Keyi-1/xinxian-fpga-guitar/tools/windows_score_uploader/examples/CSV格式说明.txt

CSV 是音符事件表，不是图片或音频文件。请使用 UTF-8 编码。

拍数格式（受软件 BPM 设置影响）：
onset_beats,duration_beats,midi_note,lane,velocity_hint,flags,group_id
0,1,60,,2,0,0
1,1/2,62,,2,0,0
3/2,1/3,64,,2,0,0

onset_beats：从曲首开始的拍数，休止直接体现在起音时间间隔中。
duration_beats：持续拍数；连音请合并为一条较长事件，避免重新起音。
midi_note：MIDI 50–79，即 D3–G5。
lane：0–3 对应界面第 1–4 根弦；所有行留空时按既有规则自动分弦。
velocity_hint：0–3，默认 2，用于试听；实际玩家拨弦力度仍由 FPGA 前端检测。
flags：目前固定 0。group_id：0–65535，通常填 0。

也可使用绝对 48 kHz 样本时间：
t_on_samples,duration_samples,midi_note,lane,velocity_hint,flags,group_id
0,48000,60,,2,0,0
48000,24000,62,,2,0,0
使用样本时间时，软件 BPM 设置不改变节奏。

必须按起音时间排序；同弦不能重叠，起音间隔至少 250 毫秒。
任意 108200 样本窗口每根弦最多 8 次起音；最长 10 分钟。
单首最多 1345 事件，五个槽共享导入空间。
无法分弦或密度超限时软件会报错，不会暗中删除音符。

《入门示例》是 8 秒音阶短句，用于首次串口导入测试。
《情歌》来自用户已确认的两页简谱主旋律：60 BPM、第二音色，
212 个起音、152 秒；第 10/18 小节采用已试听认可的修订节奏，CRC c3451bbc。
