Keyi-1/xinxian-fpga-guitar/verification/docs/RADIAL_SPECTRUM_DISPLAY_PLAN.md

# 右侧莉萨如、环形频谱与左侧四弦拨弦条带

2026-10-12，用户确认 J17 跳帽接触问题已解决，并授权开始下一版。
已按以下布局建立独立 [neo_guitar_radial 工程](../gowin/neo_guitar_radial/README.md)，
使用共享乘法 FFT、32 个实际频带插值为 64 根柱、原生 150×150 曲线及四条拨弦渐变。
**旧的 `neo_guitar_lissajous` 位流继续保留原居中布局。**
本文件保留设计依据；实际实现及验收状态以新工程 README、`verification.json` 为准。

2026-10-12 后续反馈：用户确认环形频谱与四条渐变新版已通过实物验收。
未来优化需求另见 [松品、力度、渐暗与触控游戏方案](NEXT_VERSION_PERFORMANCE_TOUCH_GAME_PLAN.md)，
暂不修改当前已验收的程序。

## 布局

屏幕保持 480×272。用户最新草图把画面分为左侧 208×272、右侧 272×272。
当前居中版本保持不变；这些布局只属于后续环形版本。

右侧区域 x=208..479，圆心 **(344,136)**，中央莉萨如正方形 **150×150**。
其对角线约 212.13，圆半径约 106.07，每侧约剩 29.93 像素。
频谱柱向外延伸，最大半径控制在约 134..135，预留边缘像素及光晕，避免越界。
圆内仍显示四根弦的真实音高 XY 图形，12 点低频、顺时针变高。

左侧 x=0..207，按 y 分成四条，各 **68 像素**：

| 弦 | 区域 y | 色彩 |
| --- | --- | --- |
| 第一根 | 0..67 | 蓝 |
| 第二根 | 68..135 | 绿 |
| 第三根 | 136..203 | 橙 |
| 第四根 | 204..271 | 红 |

每条带在实际接受拨弦时快速点亮渐变，再缓慢变暗；重新拨弦立即重新提亮，
四弦同时拨时四条可同时点亮，单独换品不能伪造拨弦闪光。
弦号/品位/Hz 可放在各自条带内；右侧不再使用当前底部四个信息卡。
三个按键仍保持原音色/音效功能。

## 频率与动态

从既有 `guitar_audio_top.final_pcm_valid/final_pcm` 取数据。
该信号来自 `four_string_board_audio_chain` 中最终音效后的左右 PCM24 平均值，
分析涵盖实际三音色模态、哇音半倍频、五度和声以及合唱/混响。
它是单声道混合频谱；左右声道相位抵消会影响幅度，不等于两声道能量之和。

12 点方位为低频，顺时针升高。建议 64 根柱，以接近对数的频率轴覆盖
约 47 Hz 到 24 kHz，48 kHz 采样的正频率范围。
仓库已有 1024 点 FFT，频率格距 46.875 Hz；最低几个柱需要依据实际 FFT 数据插值，
高频柱按频带聚合，而不是给窄频带强行分配不存在的 FFT 格点。

高度使用对数幅度和有限自动量程，让音色的高频分量也可见。
相邻柱可做有限的空间平滑，时间上采用快速上升、缓慢下降和独立峰值标记；
柱体沿半径渐变，顶部更亮。实际没有频谱能量的区域允许为空，静音时应回落。
显示上的插值和平滑不改动音频 PCM，也不能创造未演奏的频率。

## 保持声音完整的资源方案

当前音频单独使用 112/118 BSRAM；居中原分辨率显示使用 4 个，合计 116。
已有 FFT/频谱工程相对音频增加约 3 BSRAM 和 5 DSP，直接叠加会超过可用 RAM。
因此后续必须先改显示/分析的资源分配，不减少音源的 32 模态或音效。

建议把只有 256 项的反正弦表改为明确的 LUT 逻辑，释放 1 BSRAM；
FFT 保留两个复数工作 RAM 和原窗口，将窗口/蝶形乘法改成一个分时乘法器，
通过更多计算时钟换取 DSP 余量。在 50 MHz 显示域运行 FFT，
PCM 用保持数据的同步交接进入分析端，始终不向音频施加背压。
环形图继续使用原分辨率行缓存，不另建全屏帧缓存。

这是待验证的架构预算。后续实现需分别检查：

- 音频与当前完整版本逐周期、逐样本一致；所有原音色/音效保持。
- 单音、四音、半倍频、和声及接近 Nyquist 的 FFT 参考输出正确。
- 频率沿圆周顺时针映射，空间平滑不丢峰，静音时全部回落。
- 圆、中央正方形、外圈柱体和信息区在屏内且没有重叠。
- 全部行在刷新预算内完成，无缓存撕裂、PCM 丢样或音频 deadline miss。
- 实际综合网表 RAM/DSP 未超限，两时钟的 setup/hold 零违例。

环形版本应建立独立上板工程，保留当前已验收的居中版本及其位流。
