Keyi-1/xinxian-fpga-guitar/COPYRIGHT.md

# 版权与署名

**Copyright (c) 2026 芯弦项目贡献者（Xinxian project contributors）。**

该署名代表项目原创贡献者的集合，不表示所有版权已转让给某一维护者、GitHub 账号或新增的法律实体。各贡献者保留对自己原创贡献依法享有的权利；已有个人、单位或第三方权属约定继续有效。

Git 历史中的贡献者署名包括 Keyi（亦使用 Keyi Zhao）、Iris965、hanxiao-1。Git 历史用于记录协作与来源，不单独构成完整的权属证明。仓库维护者已于 2026-11-04 明确确认取得团队对 Apache-2.0／Windows GPLv3 授权方案及“芯弦项目贡献者”署名的同意。

团队原创代码和材料按 [LICENSING.md](LICENSING.md) 指定的范围授权。使用、修改和再分发时，按相应许可证保留版权、许可和必要的修改声明；没有另行附加必须署名为某一个人的条件。

第三方软件、IP、音乐、编配、谱面、图纸、字体及商标权利仍归其各自权利人，不因收录或参与打包而转让给本项目。没有明确授权依据的材料，不声明为团队原创，不由本项目重授权。

源代码许可不授予冒充原团队、宣称获得团队背书或超出许可证范围使用他人标识的权利。本文不声明“芯弦”已注册为商标，也不声明拥有未列明的专利。

发现署名、来源或授权信息有误时，请通过仓库 Issue 向维护者说明具体文件、来源和依据，以便核实和更正。
