Keyi-1/xinxian-fpga-guitar/releases/LICENSING.md

# 发布文件的许可补充

本目录的程序与源码按仓库根目录 [LICENSING.md](../LICENSING.md) 的组件范围授权。第三方曲谱、字库、图纸和 Gowin IP 保留原权利，不因打包成 FS、APK、MEM 或源码 ZIP 而由本项目重新授权；部分再分发权仍待核实。

`license_notices_20261104.zip` 提供根许可证、版权、NOTICE、第三方许可和源码索引，并列出它所对应的固定发布文件 SHA256。原始验收包和纯源码包不改写，可与该补充包一起取得许可说明。

Windows 优先下载 `FPGA_Guitar_Uploader_1.2.0_licensed.zip`。它保留原 `1.2.0.zip` 的所有成员及其字节，另附许可文件和带许可的对应源码 ZIP；软件版本和运行代码未变。`licensing_manifest.json` 列出原包哈希与新增成员，便于审阅。

这里的“许可补充”不表示已取得所有第三方素材的公开再分发许可。仓库保持现有可见性；公开分发含这些素材的包之前，仍需解决 [第三方清单](../THIRD_PARTY_NOTICES.md) 中标为待核实的项目。
