Keyi-1/xinxian-fpga-guitar/tools/windows_score_uploader/LICENSING.md

# Windows 客户端许可

Copyright (c) 2026 芯弦项目贡献者 / Xinxian project contributors。

本目录的原创应用代码、界面绘制和 `tools/run_windows_score_uploader.py` 采用 **GNU General Public License version 3 only，SPDX: GPL-3.0-only**。完整正文见同目录 `LICENSE`。

共享的 `tools/game_score_upload.py`、`game_score_v2.py` 和 `game_fingering.py` 保持 Apache-2.0；作为开源版 PyQt5 应用的一部分组合分发时，应用整体遵守 GPLv3，并保留这些共享模块的原许可和声明。

`examples/` 中的第三方曲谱、外部运行时和依赖不由本目录重新授权；参见仓库根目录 `LICENSING.md` 与 `THIRD_PARTY_NOTICES.md`。PyQt5 采用开源 GPLv3 版本，不因底层 Qt 使用 LGPL 而变成 LGPL。

原始便携包及其 `对应源代码.zip` 保持原字节。许可补充版增加应用许可、第三方源码索引和 `对应源代码-含许可.zip`，全部原程序与运行资源保持不变。原包的第三方声明仍可在 `THIRD_PARTY_NOTICES.txt` 查阅。

分发时应提供版本对应的完整源码、构建与依赖信息及适用许可。使用者可以按许可证修改程序、替换动态 Qt 库并重新构建，不另加相反限制。
