Keyi-1/xinxian-fpga-guitar/docs/images/full_width_game_stage.png

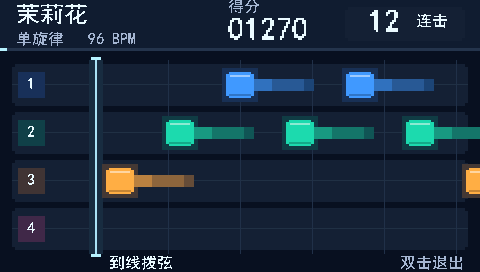
docs/images/full_width_game_stage.png
