Keyi-1/xinxian-fpga-guitar/tools/windows_score_uploader/assets/guitar.png

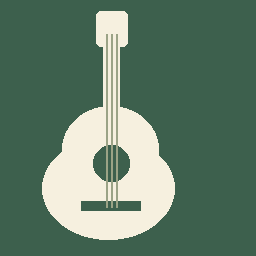
tools/windows_score_uploader/assets/guitar.png
