Keyi-1/xinxian-fpga-guitar/verification/docs/LCD_WHITE_WHEN_AUDIO_PLUGGED.md

# 插入 3.5 mm 耳机/音箱后 LCD 白屏：排查记录

**已解决（2026-10-12）：用户确认根因是 J17 跳线帽接触不牢，插牢后音频与 LCD 无冲突。
无需为此修改显示或音色 RTL。以下保留排查过程及当时待验证的假设。**

## 2026-10-12 实物反馈

- 工程：`gowin/neo_guitar_lissajous`，居中四弦莉萨如版本。
- 不接音频插头时，LCD 坐标背景、曲线与演奏联动正常。
- 接 USB 供电的有源音箱，3.5 mm 插头一插入即白屏，不需要拨弦；音频仍正常。
- 用户修正了先前的描述：上电后热插拔，拔出 3.5 mm 插头并不会恢复，屏幕继续白屏。
- 音箱 USB 接独立电源；更换不需要 USB 电源的无源耳机也会白屏。
- 底板通过圆形 DC 接口和 12 V 诱骗线供电；充电器标称支持 12 V / 2 A。
- 耳机预先接入后的冷启动结果、保持插头的重新下载结果和白屏时的电压/波形尚待实测。
- 最新补充：用户表示先前能显示颜色的程序现在似乎都不能变色。
  尚未确认是否已拔掉音频线、完全断电、重新加载原彩条程序，并复测电压/时钟。

## 已核对的事实

1. `constraints/neo_guitar_lissajous.cst` 的 52 个端口分配互不重复。
   DAC 使用 Y17、AB17、AA16；功放关闭脚为 AB16。
   LCD 数据/控制使用 G18..P20 的另一组已固定引脚，没有复用上述四脚。
2. 顶层 `pa_en_n=~audio_rst_n`，正常运行时一直为低；没有读入 3.5 mm 插头检测信号。
   LCD 扫描、背景及像素时钟不以耳机插入、PCM 音量或拨弦作为使能条件。
3. 用户提供的 31005 底板 PDF，第 10 页 `DAC+PA.kicad_sch`：
   J25 是 3.5 mm CTIA 插孔，`HP_DETL` 接到 NS4263 的 `HP-IN`；
   插入时检测开关断开，电阻把 HP-IN 拉高，切换到耳机模式。
   该检测网络没有连接 LCD 的 DCLK、DE、HSYNC、VSYNC 或 FPGA 软件输入。
   `PA_EN` 高电平关闭功放，低电平开启。
4. 同一 PDF 第 12 页 `LCD_DPI.kicad_sch`：
   J5 的 4 脚 VCC、31 脚 DISP 接 +3V3；背光来自 5V_Peripheral 的独立升压电路。
   亮背光不能证明 LCD 逻辑电源、时钟及 RGB 采样仍正常。
5. 2026-10-12 09:09 的本地实现报告仍为 setup/hold 零违例，
   音频 Fmax 13.512 MHz、显示 Fmax 51.360 MHz。
   源文件与上一轮验证记录中的源文件 SHA-256 一致。
   本次重新生成的位流 SHA-256 为
   `faa0aae61b0b07b54577dbd810e73b7c32c286ae740a7090248dcfd4baf95e6a`，
   与 10 月 11 日记录的文件不同，不能直接将旧位流哈希当成本次文件的验证证据。

以上没有证明硬件根因；目前没有证据支持改动音色、降低音频精度或更换 LCD 引脚。

## 第一轮对照：区分插入瞬间扰动与持续异常

若旧的独立彩条程序也不显示，应先恢复无音频连接的最小基准，再继续下面的热插/冷启动区分：

1. 拔掉 3.5 mm 音频插头，底板和屏幕断电；检查并重新插牢 J17 的 1–2 跳帽及 J5 排线锁扣。
2. 上电后重新下载原来实物成功的 `T:/Documents/AMD/fpga_lcd_selftest_60k/impl/pnr/lcd_selftest.fs`。
   它只包含 50 MHz LCD 彩条逻辑，没有吉他音源、MCP3208 或 PT8211 数据发送链。
3. 记录默认彩条、KEY1 切换及 KEY0 按住关闭背光的结果，并按下表重测屏幕端电压/波形。
4. 若需排除按键切换因素，可使用既有
   `T:/Documents/AMD/fpga_lcd_selftest_60k/diagnostic_auto_rgb/impl/pnr/lcd_auto_rgb.fs`，
   每 2 秒轮换黑、红、绿、蓝、白；这是测量工具，并非保证修复白屏的新位流。

未获得上述基准结果，不能确认屏幕已损坏，也不能把现象确定为整合程序的音频/LCD 引脚冲突。

无源耳机同样触发白屏，已经降低“原音箱 USB 电源/地环路”为首因的可能性。
热拔出不恢复提示可能是一次扰动后，LCD 内部状态或 FPGA 显示域没有恢复；
这是待测假设，不能仅凭此确定复位、供电或时钟中的哪一项有问题。

先插好普通有线耳机，使底板和屏幕完全断电约 5 秒，再重新上电。
确保相同 FPGA 程序已加载；若之前只做 SRAM 下载，断电会丢失配置，需在预插耳机后再次下载。
若冷启动正常、热插入才失效，应捕获插入瞬间的供电和时钟异常。
若预插耳机冷启动也白屏，应比较耳机模式下的持续供电、电平和 DCLK。

白屏后保持耳机插着，再下载同一个程序：

- 重新下载后恢复：优先检查 FPGA 显示域状态、复位恢复、50 MHz 时钟瞬态及供电；
  重新下载也改变 LCD 时序，不能仅凭该结果排除 LCD 内部状态问题。
- 下载不恢复，但整体断电可恢复：优先检查 LCD 逻辑电源与自身初始化；
  J5-31 DISP 硬接 +3V3，当前 FPGA 不能直接将它拉低重置面板。
- 以上均不恢复：继续检查持续电气异常和接触/连接。

## 已做与备用接线对照

依次记录以下组合的画面与声音，不同时修改多个条件：

| 条件 | 观察目的 |
| --- | --- |
| 原音箱、3.5 mm 保持接入，仅断开音箱 USB 电源 | 区分外部电源/地线联系与插孔本身；无源状态下的输入也可能产生负载，结果须结合下两项 |
| 普通不需要 USB 供电的有线耳机接入 J25 | 已测，同样白屏；问题并非原音箱专属 |
| 原音箱改为独立充电宝供电，再接 3.5 mm | 检查共用充电器、多口 PD 重新协商或电脑/底板 USB 接地产生的影响 |

当前应继续查底板功放切换、电源、插孔、50 MHz 时钟以及 LCD 接线。
标称 12 V / 2 A 不能替代插入前后的实际电压和纹波测量。

## 第二轮测量：在白屏状态测，不使用旧的正常状态读数

以屏幕端 J5 的 GND（3、29、36 脚）为参考，分别记录插入前后：

| 测点 | 本工程正常预期 |
| --- | --- |
| J5-4 VDD、J5-31 DISP | 约 3.3 V，插入时也应保持稳定 |
| J5-30 DCLK | 8.333333 MHz；示波器确认高低电平、连续性与边沿，不只看频率档 |
| J5-32 HSYNC | 约 15.694 kHz，低脉宽 0.48 us |
| J5-33 VSYNC | 约 53.745 Hz，低脉宽 254.88 us |
| J5-34 DE | 有效行高脉宽 57.6 us；每帧 272 条有效行 |
| 底板 DC 输入与 +3V3 | 插入前后是否变化；捕获插入瞬间跌落或振铃 |

若底板端信号正常，需在屏幕端再次测量，以识别 FPC、地线和连接接触问题。
声音正常只能证明音频链仍工作，不能证明独立的 50 MHz 显示时钟及 LCD 逻辑电源正常。

## 何时修改代码

- 显示信号及电源测量确认异常后，按异常位置处理，不先改频率比例、颜色或音色算法。
- 如对照结果指向板载 NS4263，可建立独立的“PA_EN 固定高”的临时诊断位流；
  它会关闭板载功放，不能作为同时发声与显示的正式修复。
- 如确认只有瞬间异常，修复应针对电源/信号完整性，或在有明确复位证据后增加恢复逻辑；
  延时启动或软件复位不能保证修复持续欠压，且不能直接复位硬接高的 DISP。
- 如需要观察 50 MHz 域，可另加诊断指示或定时背景；正式版继续保留原三键功能。

本次排查不启动下一版环形频谱设计，当前演奏显示 RTL 与音色核心暂未修改。
