Keyi-1/xinxian-fpga-guitar/verification/docs/VELOCITY_CALIBRATION.md

# P4 四弦力度校准

2026-10-19后续边界：第一弦易串触与最低响度先由[第一版修正](DYNAMICS_TUNING.md)接续；当前原impl和同名FS已为[四等分力度版](QUARTER_DYNAMICS.md)，CH0/CH2触发220/60，四档64/128/192/256，认证`quarter_dynamics_verification.json`。本文150/112参数及210877be...哈希为保存的初次力度校准快照，只对应`p4_velocity_calibration_20261019/`内部FS，不认证此后同名发布文件。

2026-10-18用户提供三份队友测试代码，授权基于已保存的P4接入力度并综合仿真，随后允许生成新位流时覆盖同名`neo_guitar_touch_game_p4_posture.fs`。没有新推送或代理烧录授权。

旧P4保存在本地标签`snapshot/p4-posture-before-velocity-20261018`（`1bbab98`）及原完整归档`build/releases/touch_game/p4_posture_20261018/`。旧位流SHA256为`34f8a86e942e291453159655c654fc72e5424167686cb2200dd659d4daf7229c`；归档中的`evidence/gowin/neo_guitar_touch_game/impl/pnr/neo_guitar_touch_game.fs`保持该版本。旧P4认证只认证这个固定快照，不能认证此后同名发布文件。

## 采用的校准值

三份输入原文和SHA256在`sim/reference/velocity_teammate/`，不改外部微信文件。注释不是额外指令；两个过期注释写100/30，与实际宏150等/20不符，生产采用实际宏值并纠正注释。

| ADC/轨道位 | 静态基准 | 触发偏差≥ | 回落偏差≤ | 进入力度1/2/3的峰值偏差≥ |
| --- | ---: | ---: | ---: | --- |
| CH0 / bit0 | 2053 | 150 | 20 | 280 / 430 / 620 |
| CH1 / bit1 | 2053 | 100 | 20 | 250 / 400 / 600 |
| CH2 / bit2 | 2053 | 80 | 20 | 150 / 280 / 400 |
| CH3 / bit3 | 2053 | 100 | 20 | 220 / 380 / 600 |

偏差为`abs(sample-2053)`，正负方向均触发；未到触发值不发音，到触发值但低于第一分界为力度0。达到边界归入较高等级，四档编码0～3。CH0～3仍对应MCP3208 CH0～3与`pluck_valid[0:3]`，没有改接线或交换弦。

`BOARD_FIXED_VELOCITY_ENABLE=0`启用动态四档，保留显式固定2的调试参数。按队友代码从首次越过触发值开始，取其后32个该通道样本与首个样本的最大绝对偏差，共33个观测值，末个样本也计入。窗口结束才同时提交力度和单周期拨弦脉冲，避免按刚越阈值的低幅度误分档。原事件时间戳仍记录提交时刻。

原SPI和ADC数据重建保持，包括已下板的奇数码重建方式，没有借此次校准改变ADC位对齐。400个通道样本死区和80个连续低于回落值样本保持，窗口按各通道自己的采样次数计数，不按四通道总数计数。新增`capture_pending`只用于观察窗口；姿态自动切音色把它计入待处理起音，防止约1.5ms捕获期间提前换音色。

## 响度与音色边界

上传的`voice_envelope.v`与现有文件逐字一致；它属于旧可选包络路径。当前三种音色使用实时`piano_voice_core`及其既有四档增益，不用另一套ADSR覆盖已验证的钢琴击弦和弦音/哇音包络。

| 力度编码 | 现有Q8增益 | 相对满力度振幅 |
| --- | ---: | ---: |
| 0 | 112 / 256 | 43.75% |
| 1 | 160 / 256 | 62.50% |
| 2 | 208 / 256 | 81.25% |
| 3 | 256 / 256 | 100% |

演奏与游戏真实拨弦使用捕获力度；试听继续固定2，曲谱metadata和推荐音色不改。此表是音源数字增益，不是声压dB或人耳响度比例。所有模态/谐波、音色系数、包络、音效、采样率、位宽、主增益、PA、两路音频与按键职责保持。四档最终响度仍须用实际琴体、扬声器和功放确认。

## 验证与当前构建

运行时源码`e5680ef`，原工程`gowin/neo_guitar_touch_game/neo_guitar_touch_game.gprj`、原`impl`、Device B。原工程综合及完整P&R/STA均PASS，记录在`build/velocity_calibration/synth_v1/`。综合LUT39698+ALU10501=Logic50199；下表统一采用完整实现报告，与保存的P4比较，不能将综合逻辑BSRAM108代替物理BSRAM113。

| 完整实现指标 | 保存的P4 | 力度校准版 | 变化 |
| --- | ---: | ---: | ---: |
| Logic / 59904 | 50580 | 50570 | -10 |
| Register / 60780 | 20090 | 20146 | +56 |
| CLS / 29952 | 28585（95.436%） | 28316（94.538%） | -269 |
| BSRAM / 118 | 113 | 113 | 0 |
| DSP / 118 | 115.5 | 115.5 | 0 |
| 系统报告Fmax / MHz | 50.020 | 50.089 | +0.069 |
| 音频报告Fmax / MHz | 13.858 | 13.638 | -0.220 |

运行仍为50/12.288MHz；未布通、setup、hold、latch及已测运算deadline违例全部0。保留两条既有PR1014通用时钟布线提示，STA计入实际布线。旧余量目标中CLS≤95%、音频≥13.5MHz已达到，系统≥55MHz仍未达到，不能宣称全部余量目标完成。资源变化来自本次完整实现，不把局部寄存器变化当作总体收益。

- `velocity_detector_01`：四通道全部4096输入码，共16384组，正负偏差/边界/132个峰值位置、末样本提交、固定2选项、交错窗口、振铃/重触发/复位；另有生产SPI4/捕获32/死区400/回落80的四弦×四档真实SPI模型。
- `velocity_audio_02`：实际ADC引脚→P2演奏路由→三音色×四档，每档1024样本；与独立指定正确等级的原音源逐PCM/PT8211/I²S比对，声部能量严格递增，12个单声部干声测试无数字硬顶。全部音效与四声部同时起音、捕获期姿态保护、手动优先、原生产顶层姿态场景也通过。01仅因测试最后四弦参考误设为混合等级而失败，已保留原日志；修正参考为四弦满力度，没有改生产音源。
- `velocity_legacy_01`：冻结`655458f32ba4f7e06403fd6c5c4da0b6f0dad8a7`的8192样本/2097153周期、全部音色/效果/1452样本退出；P2判定/四档力度、D3～G5完整32位参考/9032样本、实际硬件默认按键去抖均通过。
- `velocity_adc_gate_01`：当前实际完整VG中的ADC前端，原语/父级补码复位及全部8位力度/4位捕获输出已审计，真实SPI4和生产计数，四弦×四档，4739008时钟/32238转换逐周期与RTL相同，无内部结果强制。

- `velocity_full_gate_01`：当前实际完整VG整机对照PASS，10次真实115200事务，实际RAM写入/CRC/帧原子提交，第五行触控和四声部G5/D3/E4/C5；13397音频样本、16帧、5875200 LCD时钟采样，包含动态频谱与曲线渐暗。
- `velocity_posture_gate_01`：当前实际完整VG姿态整机PASS，真实MPU引脚、生产256包校准、物理音色键、AUTO待命/尾音/手动取消/退出/恢复；12815音频样本、1773读包、5次实际音色变化、11226240有效期系统时钟LCD采样。上述LCD采样数不是独立像素数；各bench的触控/计数加速/事件刺激边界在记录中明确，不把受控仿真称为实物验收。
- 曲库384组布尔连线审计PASS；33项PC测试与生成器按完整源码/输入/日志哈希复用，未变化的既有证据只用于明确同源范围，不复用旧VG日志认证新网表。

当前完整VG SHA256为`f64a6960a33513f73e2c60006b31a0fdf18970cce2fd0a23a128eb81e816e3c2`。综合PID39028、同一VG接续P&R PID24376及两个实际VG整机仿真均已结束，完整实现于2026-10-19 00:09:27完成。严格最终校验PASS，认证为`gowin/neo_guitar_touch_game/velocity_calibration_verification.json`，重新绑定源码、ROM、输入、工具、日志、当前VG、P&R/STA与位流哈希。不要重复启动已通过测试或完整构建。

## 发布与下板

原工程可直接使用`gowin/neo_guitar_touch_game/impl/pnr/neo_guitar_touch_game.fs`，无需重新综合布线。按用户明确许可，发布副本覆盖原同名`build/releases/touch_game/neo_guitar_touch_game_p4_posture.fs`，新SHA256为`210877be3e236c36d431e67bd116a6c9b0c2ac4e6d7b18912b162473b2b5812c`。本批完整证据归档为`build/releases/touch_game/p4_velocity_calibration_20261019/`，以`archive.json`核对每个文件；旧P4标签与固定原归档保持，旧认证只对应旧归档内部FS。两个受保护用户文件的内容及暂存对象不变。

1. 在Gowin Programmer中选择上述同名新FS，保持原接线与运行时钟。
2. 先在演奏模式逐弦试轻/中/重/最重，检查同弦强弱层次、连拨和静置不误触；再试三种音色、四弦同时拨及延音/混响。
3. 游戏中核对真实拨弦判定、试听固定力度2、触控选曲/退出和UART；已接MPU时再核对捕获/尾音期间不提前自动切音色、手动仍优先。

本批实物仍待：每弦轻/中/重/最重各20次，静置噪声/串弦/连拨/正负压电波形，跨弦与跨音色听感和硬削顶，游戏命中窗口，延音与姿态同时操作。没有原始ADC标注波形、目标声压或功放增益测量，因此不能把数字验证当作独立声学标定。供电/MPU接线/阈值和稳定性继续按P4说明验收，不自动展开蓝牙或新功能。
