Keyi-1/xinxian-fpga-guitar/verification/docs/evidence/voice_e4_golden_summary.txt

Xinxian FPGA Guitar - E4 golden vector
Configuration: {"lut_addr_bits": 10, "note_off_index": 24, "note_on_index": 0, "pcm_product_shift": 7, "phase_bits": 32, "phase_rom_sha256": "dc0c068f5d900bf015759b7a247e24b5ad950976b3725c4a76183bdb4eadd294", "sample_rate_hz": 48000, "sine_lut_sha256": "39d6e76e2dcf7f8337257c5948d6f525a94ffe09f5cf481e9e75a1300082b3c5", "vector_length": 48}
Phase increment: 01C20D2F
Vector samples: 48
Maximum PCM24: 6022393
Minimum PCM24: 0
Maximum PCM16: 23525
Minimum PCM16: 0

The CSV is the primary human-readable reference.
The MEM files are intended for ModelSim scoreboards.
