Keyi-1/xinxian-fpga-guitar/verification/docs/evidence/voice_e4_long_summary.txt

Xinxian FPGA Guitar - long E4 golden vector
Vector length: 48800
Sample rate: 48000 Hz
Nominal frequency: 329.6275569 Hz
note_on index: 0
note_off index: 36000
Phase increment: 01C20D2F
Sine LUT SHA-256: 39d6e76e2dcf7f8337257c5948d6f525a94ffe09f5cf481e9e75a1300082b3c5
Phase ROM SHA-256: dc0c068f5d900bf015759b7a247e24b5ad950976b3725c4a76183bdb4eadd294
PCM24 range: -8368130 .. 8385792
PCM16 range: -32688 .. 32757
