Keyi-1/xinxian-fpga-guitar/verification/gowin/neo_guitar_radial/README.md

# 四弦拨弦渐变、150×150 莉萨如和环形真实频谱

这是独立的下一版上板工程，Top=`neo_guitar_radial_top`，
器件 `GW5AT-LV60PG484AC1/I0`，Device B。
旧的 `neo_guitar_lissajous` 居中版本及其位流继续保留。

**实物验收（2026-10-12）：环形布局和松品续音均已由用户确认通过。**
本轮按用户授权只加入中央曲线渐暗，新位流待上板复测。
四档力度、条带长度与触控游戏仍为
[下一版方案](../../docs/NEXT_VERSION_PERFORMANCE_TOUCH_GAME_PLAN.md)中的待实施项目。

## 画面与演奏

480×272 屏幕左侧为 208×272，四条带各 68 像素：第一弦蓝、第二弦绿、第三弦橙、第四弦红。
只有实际接受的拨弦事件才使对应条带快速点亮，之后约 0.58 秒渐暗；
四弦可同时亮起，重拨重新提亮，单独换品不会伪造拨弦。
每条带显示弦号、品位和当前实际发声音高，保留原 20 ms 滑音。
按品和松品只选择音高：最后一个品位松开后，正在发声的弦滑向空弦并继续原衰减；
不会生成松品停音，也不会重置响度、力度、相位或包络年龄。只有真实拨弦重新起音。
声音结束由原音色自然包络及延音设置决定；静音后仅换品不会恢复声音。
这是共享 `guitar_play_control` 的新策略，重新构建引用它的其他工程也会采用相同行为；已有旧位流不变。

右侧为 272×272，中心在像素中心 **(343.5,135.5)**，即约 (344,136)。
莉萨如绘图区为 **150×150 原生像素**，中心和 X/Y 半径分别为上述中心及 74.5。
圆半径约 106，与 150×150 正方形的对角线相匹配；谱柱从半径 107 向外伸展，
柱体最高半径 134，峰值标记最高到 135。所有内容均在屏内。
圆内保留细线、抗锯齿、光晕和淡残影，四音曲线叠加混色。
Y 轴为 220 Hz 参考，X 轴来自四根弦真实主音高 DDS；它不是全部模态 PCM 的 XY 混合。

## 中央曲线渐暗

四声部各有一个 8 位显示亮度包络，复用原逐声部 PCM 峰值：

- 新的实际拨弦计数到达时，一帧提亮到 255；只换品或松品不会重新提亮。
- 持续发声时，亮度向 `level << 4` 跟随，升亮按差值的 1/2、降亮按差值的 1/32 推进，至少变化 1。
- 实际声部结束后保留最多 8 帧尾迹，约 **149 ms**，逐帧降至零；重拨立即重新点亮该弦。
- 四条曲线独立渐暗后再混色；一弦的结束或重拨不改变其他弦的包络。

已去掉原 `22 + 2*level + flash` 的固定底亮度。内部 8 位包络输出为面板的 6 位颜色强度，
低于可显示强度时停止绘图，内部包络最终归零；抗锯齿、光晕、残影和颜色流动继续保留。
包络与绘图使能均在帧消隐内提交，像素流水线级数及 LCD 时序不变。
尾迹按最后实际发声的 DDS 音高继续推进相位，静音后准备下一品不会使旧尾迹跳变。
只有环形顶层启用被动观察器的 `HOLD_INACTIVE_PITCH`；声音活动标志与音高/品位标签仍来自原演奏链。
该功能没有反馈到音频，三音色、4×32 分量、滑音、音效和松品续音均保持不变。
左侧四条带和真实频谱继续采用原衰减逻辑。本轮未改变拨弦力度判断或条带长度。

亮度实现见 `rtl/display/guitar_curve_envelope.v`，只使用移位、加减和寄存器，
不增加 RAM 或 DSP。现场可在此调整峰值跟随速度；尾部固定 8 帧的移位步长需同步修改计数及测试。

## 环形频谱

12 点附近为最低频率，顺时针升高。64 根可视柱来自 32 个实际频带的插值和邻域平滑，
快速上升、每帧缓降，另有慢速峰值标记和沿半径变亮的彩色渐变。
低频段不分配没有 FFT 格点的空频带；实际无能量的区域可以为空，静音会回落。

## 真实频谱与资源共享

分析输入为既有 `guitar_audio_top.final_pcm_valid/final_pcm`：
最终音效后的左右 PCM24 平均值，包含原三音色、五度和声、合唱及混响。
这是单声道混合频谱，两声道相位抵消会影响幅度，不等于两声道能量之和。

PCM 通过保持数据的请求/应答邮箱从 12.288 MHz 进入 50 MHz 域。
交接没有向音频施加背压；超限有独立诊断，仿真必须为零。
FFT 连续采集 1024 个 48 kHz 样本，加 Hann 窗；处理时短暂停止采集下一分析窗口，
不停止或丢弃实际音频输出。每个分析窗口约 22.2 ms。
FFT 保留既有分析定点算法，24→16 位只用于显示分析，音频 PCM 精度保持原样。
正频率覆盖 bin 1..512，约 **46.875 Hz..24 kHz**，排除 DC 并包含 Nyquist。
前 14 个频带各对应一个低频格点，后续频带逐渐加宽，避免低频空带。
幅度采用对数映射、有限增益与缓降参考，避免小噪声在静音时被放大成满圈。
32 个频带计算完成后整组发布；64 根柱及拨弦条带在帧消隐内更新。

一套 18×16 乘法器分时完成窗函数和四个复数乘积，不同时复制四个 FFT 乘法器。
本轮为满足 50 MHz，将乘法器输入提前一拍寄存，使状态译码/输入选择与 DSP 乘法分开。
蝶形仍采用原四次乘法调度，窗函数采样多一个 ROM 准备时钟；48 kHz 输入仍连续采集。
FFT 整数结果与原 FFT 逐频点比对，音频算术、ROM 和 PCM 路径不参与该优化。
FFT 用两个双端口工作 BSRAM 和一个窗 ROM，共 3 个 BSRAM。
曲线继续使用两条行缓存和一个正弦 ROM，共 3 个 BSRAM。
反正弦、旋转因子和小型径向表显式使用 `syn_romstyle="logic"`，避免自动占用 RAM。
原音频使用 112 个 BSRAM，总预算为 **118/118**，不能再直接叠加帧缓存。
新增共享只发生在显示/频谱模块，音源的 4×32 分量、ROM、定点精度和全部音效没有降低。

圆周方向用八分区阈值比较，距离用平方距离；显示不做逐像素除法或 atan2。
几何/字体为五级流水线，行缓存到 RGB 为四级，均在六个 50 MHz 时钟的像素周期内完成。
面板 RGB、同步与 DE 仍在 DCLK 下降沿输出，距上升沿约 60 ns。
绘图最坏 2266/3186 时钟（2176 行独立解析参考测试，含实际声部结束后的尾迹），无丢行。

本次渐暗版最终布局布线结果（Gowin V1.9.12.03，2026-10-12）：

| 项目 | 使用量／容量或结果 |
| --- | --- |
| Logic | 41721 / 59904 |
| Register | 16370 / 60780 |
| BSRAM | 118 / 118 |
| DSP | 115.5 / 118 |
| 音频 Fmax，目标 12.288 MHz | 17.483 MHz |
| 显示 Fmax，目标 50 MHz | 50.167 MHz |
| Setup / Hold 违例 | 0 / 0 |
| Latch | 0 |

显示域时序余量较小，RAM 已用满；更改 RTL 后必须重新综合、布线和验收，
不能直接增加帧缓存或提高显示时钟。

## 接线、按键与下载

沿用上一版所有接线：J5 LCD、J13 品位矩阵、J8 MCP3208、PT8211 和音箱。
**J17 必须可靠短接 1–2，确保跳帽接触牢固**；它关闭与 LCD 共线的 CH569。
不需要 HDMI。V22 仍为 50 MHz，V13 仍为板上已配置的 12.288 MHz。
三个用户按键保持原功能：

| 按键 | 功能 |
| --- | --- |
| KEY0 | 钢琴 → 明亮弦音 → 哇音 V4 |
| KEY1 短按 | 合唱开关 |
| KEY1 长按约 1 秒 | 五度和声开关，后续拨弦生效 |
| KEY2 | 无效果 → 延音 → 轻混响 |

在仓库根目录构建：

```powershell
gw_sh.exe gowin/neo_guitar_radial/build.tcl
```

Gowin IDE 可打开 `neo_guitar_radial.gprj`，确认 Top 为 `neo_guitar_radial_top`。
最终下载 `impl/pnr/neo_guitar_radial.fs`，首次使用 SRAM Program/Configure。
本次渐暗更新另存同内容下载文件 `impl/pnr/neo_guitar_radial_curve_fade.fs`，
方便在 Programmer 中区分旧版本；两份文件 SHA-256 相同。
CLI 构建脚本会同步更新该别名。IDE 另行构建仅更新默认 FS；使用带后缀文件前需把默认 FS 重新复制到别名，验收脚本会检测不同步的文件。
已验收的松品版本仍保留为 `impl/pnr/neo_guitar_radial_open_release.fs`，
另有构建前备份 `temp/before_curve_fade/neo_guitar_radial.fs`，指纹为
`701ba99e1c65f5667b934ef5b860df0bc968fca73d2ac45fc7b23b17e9ee85ce`。
更早的原环形程序备份为 `temp/before_open_release/neo_guitar_radial.fs`，
指纹 `71629a8d242f99c2bf7d8f1e2ea60fa0e24c903dfccb8665d16093bec77a047c`。
资源和两个时钟的 setup/hold 必须先由 `check_result.py` 验收，不能仅以生成了 FS 判断通过。
原屏背光恒流匹配和 GT911 触摸状态沿用上一版。

## 验证与实物验收

```powershell
./gowin/neo_guitar_radial/run_sim.ps1 -ModelSimBin '你的 ModelSim/win64' -PythonExe '你的 python.exe'
./gowin/neo_guitar_radial/run_gate_check.ps1 -ModelSimBin '你的 ModelSim/win64' -GowinHome '你的 Gowin/IDE'
python gowin/neo_guitar_radial/check_result.py
```

新 RTL 测试包括：PCM24 跨域交接、FFT 与旧 FFT 的逐频点整数比对、DC/Nyquist/静音、
频带原子发布、全圆独立 atan2/平方距离参考、四条带拨弦/衰减、
150×150 曲线独立解析模型和完整真实矩阵/ADC 演奏链。
完整演奏涵盖四音、最高品滑音、松品、三音色、合唱、和声、延音及混响，
连续 **7,214,423 个音频时钟**的 PCM、DDS、DAC、输入及控制输出与采用同一新演奏策略的 FULL 完全一致。
松品音高与旧行为的不同是本次预期变化，不宣称松品后的声音与旧程序相同。
新增 `tb_guitar_open_release` 在完整 4×32 音源中检查四弦包络年龄、自然结束、三音色和音效；
仅在测试实例缩短 MAX_SAMPLES以加快自然结束验证，生产音源参数、ROM与算术均不改动。
默认时序测试另外验证实际 12.288 MHz / 48 kHz 下的防抖、完整滑音和续音。
原核心与全部音色 ROM 的 SHA-256 另与仓库 HEAD 核对。
新增渐暗验证包括独立包络与实际 RGB 像素、四声部独立衰减、零亮度下限、
8 帧尾迹、事件计数回绕、尾迹中重拨、帧内亮度稳定以及最后可听 DDS/相位保持。
另将完整 4×32 音源的自然结束接入实际 CDC 和 LCD 扫描，导出 10 帧画面；
仅测试实例的 MAX_SAMPLES 缩短为 4096，生产时长、采样率、音源 ROM 和算术均不变。
门级测试用实际 Gowin 原语模型核对 LCD 引脚与 DAC 串行输出，并绑定当前网表哈希。
最终资源、Fmax、零违例和测试证据写入 `verification.json`。

本次渐暗版最终验收通过：30 项 RTL 测试证据，其中与修改相关的 10 项已重跑，
其余 20 项引用源码未变的既有结果；52 个固定引脚及电压核对通过，Setup/Hold 均为零。
当前综合网表的 7632 帧实际 DAC 输出与 RTL 逐位一致，包含 7292 帧非零和 1596 帧半速哇音；
7949456 个板时钟、1115060 个可见 LCD 像素完全一致。
音源、音色 ROM、音效及已验收松品控制的文件指纹与 `4d1af92` 基线保持一致。
渐暗位流及同内容下载别名的 SHA-256：
`870b8c1f2bd76d6dc6b0ddc2d5210fe75bdefa1017f62c4f9726649268598173`。
构建脚本自动更新下载别名；验收脚本核对别名与默认 FS 一致，防止误用旧文件。

本次为保持原 50 MHz 时钟，FFT 乘法器操作数改为提前寄存。
未增加乘法器或 RAM，2048 个正频点结果与原 FFT 逐位一致；当前 50.167 MHz Fmax 已通过。
不放宽时钟约束，不降低音源精度、分量数或音色复杂度。

历史松品更新最终验收已通过：27 项 RTL 回归证据、52 个固定引脚及电压核对、
Setup/Hold 零违例；综合网表的 **7632 帧实际 DAC 输出**（7292 帧非零，
1596 帧半速哇音）和 **1115060 个可见 LCD 像素**逐位一致。
门级另验证真实矩阵四弦松品后完成空弦滑音，声部保持活动且没有松品阻尼。
音源核心与全部音色 ROM 文件保持不变。上述自动构建/门级验收记录对应的位流 SHA-256：
`701ba99e1c65f5667b934ef5b860df0bc968fca73d2ac45fc7b23b17e9ee85ce`。
本地后续构建的位流指纹需单独核对；用户的实物功能反馈与这份历史自动构建记录分别保存。

实际 RTL 画面保存在 `sim/temp/radial_four_voices.png`、`radial_slide_c5.png`、`radial_release.png`。
渐暗帧保存在 `sim/temp/radial_fade_attack.png`、`radial_fade_tail_0.png` 到 `radial_fade_tail_7.png`，
其中声音结束后改为准备第 8 品，尾迹仍保留先前实际音高；最后一帧中央曲线归零。
本次渐暗更新待上板复测：逐弦及四弦拨弦应快速亮起，随声音慢慢变暗，结束时平滑淡出；
尾迹中重拨对应弦应立即提亮。换品/松品应继续改变曲线比例而不会闪回最亮；
分别用三音色和 KEY2 延音观察尾部，并核对声音与已验收版本一致。
松品续音已通过用户实物验收，作为回归继续检查：
按第 1 品后拨弦，再松品，应平滑转到空弦且继续衰减；先拨空弦再按品再松品也应一致。
仅换品不重新起音，自然结束后再按品保持静音。四弦和 KEY2 延音状态分别核对。
同时复测逐弦拨弦看蓝/绿/橙/红快速点亮与渐暗；
四音同时拨弦看四条带及复音曲线；切换三音色及音效，核对频谱分布随实际声音变化。
四档力度与 GT911 触控尚未做专项标定/验收，下一版方案不把它们列为当前已完成能力。
所有 `impl/`、`sim/temp/` 的位流、报告和图片都是本地生成产物。
