Keyi-1/xinxian-fpga-guitar/verification/firmware/jdy23/release/README.md

# JDY-23 蓝牙模块版本

本目录保存 2026-10-27 已完成的发布包；2026-10-30 提交到仓库。
本次只复核源码、已有验证记录和交付包的哈希，没有重新综合、布线、编译或烧录。

- [完整发布包](jdy23_20261027.zip)：FPGA 位流、Android JDY23 APK、接线/配置说明、配置脚本、原情歌示例，以及退出旧 BL616 诊断时可选的时钟恢复文件。
- [原始数字验证记录](verification.json)：包含源码、曲库、网表、位流、Android 输入和已有专项验证记录的绑定。
- [使用说明](../README.md)：3.3V 供电、共地、J8-9/10 接线、模块配置、手机握手及传谱步骤。
- [SHA256SUMS.txt](SHA256SUMS.txt)：本目录 ZIP 与原始验证记录的校验值；ZIP 内另有逐文件校验。

FPGA 改动限定为上传串口分频及两个引脚映射：9600/8N1，TX=AB21/J8-9，RX=AB22/J8-10。
Android 采用 FFE0/FFE1、20+12 字节分片和停等确认，保留断线后的提交状态核对。
音源、钢琴半时长、尾音锁定、滑音、颤音、触控、姿态与曲库运行时源码保持已有版本。

原工程已完成综合和完整 P&R/STA，系统/音频 Fmax 为 50.033/17.840 MHz，
实际时钟为 50/12.288 MHz，setup/hold/latch/未布通均为0；系统余量较窄。
专项验证覆盖实际 9600 UART、XG3/BSRAM/CRC/提交、当前网表接收、Android 类模型及配置脚本。
本版本尚未完成实体模块广播、手机连接及实物传谱验收，APK 未由代理安装。

固定交付哈希：

| 文件 | SHA256 |
| --- | --- |
| jdy23_20261027.zip | `145c412df784d6897f97cb1ed146bf87dd4b7c459e8ae271ac19d265fa8b9178` |
| neo_guitar_touch_game_jdy23_9600.fs（ZIP 内） | `78056f8c3bdde32bbbc12e1c7cc234e76beaa002562fb134fc6807a3c3452604` |
| xinxian_jdy23.apk（ZIP 内） | `b4fceac18a13d8ff3b9220cdf36b26bf27053cea292f59be751fb316ca166f5a` |

旧发布不覆盖；后续更新使用独立版本和验证记录。
