Keyi-1/xinxian-fpga-guitar/verification/docs/FULL_EFFECTS_V2.md

# FULL 音效 V2：空弦延音与可区分的合唱／混响

后续三音色更新见 [ROCK_TIMBRE.md](ROCK_TIMBRE.md)；本页记录 V2 两音色的音效基线。

日期：2026-10-05，分支 `feat/full-piano-effects`。
用户已上板确认三键功能正常，但反馈三种音效区别小，尤其明亮弦音的空弦延音不明显。
V2 使用相同的板级入口、接线、按键与音符表，重新实现效果参数和延音行为。

## 原因与修改

V1 延音只放慢松品之后的阻尼，空弦没有这个事件。
同一次空弦 C4 拨弦的实际 RTL PCM16 对照证明：两种音色的 V1 延音与无效果输出完全相同。
明亮弦音又叠加了很快的逐分量衰减，因而更快消失。合唱使用约 1 ms 的相同左右调制，
主要改变梳状滤波音色，缺少空间宽度；混响每条回声只有 1/32。

| 处理 | V2 实现 | 比较时关注 |
| --- | --- | --- |
| 延音 | 击弦起音前 2048 样本保持原速；之后自然包络每四个样本推进一次；松品后保持阻尼系数 | 空弦及按品音符本身的长尾音 |
| 明亮弦音 | 普通状态每四个样本更新分量衰减，延音状态每十六个样本更新 | 尾部不再被额外衰减迅速压掉 |
| 合唱 | 15～23 ms 的 Q8 分数延迟，0.55 Hz 三角调制；左右反向；3/4 干声加 1/4 延迟声 | 左右宽度、厚度与缓慢晃动 |
| 轻混响 | 31.0／41.5／56.5 ms 公共反馈延迟；3/8 归一化输入、5/8 反馈；3/4 干声加两条各 1/8 回声 | 起音后的空间反射，反馈尾音约 0.6 秒 |

延音只改变包络和分量幅度衰减，DDS 相位仍按正常 48 kHz 采样推进。
退出延音时已松品的音符恢复普通阻尼。自然包络仍会结束，没有无限维持平台。
房间网络的输入系数与反馈系数之和为一，反馈小于一；干湿系数之和为一。
分数延迟使用两条独立的注册凸组合乘法，避免以前 Gowin 有符号预加器的问题。
延迟 RAM 有填充保护，按键切换保留约 5.33 ms 的干湿渐变。

默认无效果的钢琴 **192000 个 PCM16 立体声帧与 V1 逐样本相同**。
原固定八模态钢琴入口的 32000 个样本也与独立参考相同。

## 工程与位流

仍打开 `gowin/neo_guitar_audio_full/neo_guitar_audio_full.gprj`，
Top=`neo_guitar_audio_full_top`，器件 `GW5AT-LV60PG484AC1/I0` / Version B。

- 当前下载文件：`gowin/neo_guitar_audio_full/impl/pnr/neo_guitar_audio_full.fs`。
- 本轮命名副本：`build/piano/neo_guitar_audio_full_effects_v2.fs`。
- 两者 SHA256：`e122443418dc86975a82881840529990691935f06b156974d47485b0c29fbd03`。
- V1 回退副本（本轮开始时的本地构建）：`build/piano/effects_v1_accepted/gowin/neo_guitar_audio_full/impl/pnr/neo_guitar_audio_full.fs`，
  SHA256 `9d130149bea45a294b754ac6118db42bb3d0144dca875a02f34de97f22320641`。
  同目录备份树包含修改前 RTL、系数、证据与 `manifest.json`。

按键沿用：1 键循环音色；2 键短按合唱、长按五度和声；3 键循环无效果／延音／轻混响。
工程没有外部复位键。LED0～3 分别表示明亮音色、合唱、延音、轻混响。
和声在下一次拨弦锁存；第三键无效果时，同时点亮 LED2／3 表示和声已启用。

## 数字验收

| 构建 | Logic | FF | BSRAM | DSP | 时序 |
| --- | --- | --- | --- | --- | --- |
| 可下载 FULL 音频 | 22420 / 59904 | 10294 / 60780 | 80 / 118 | 91 / 118 | 音频 Fmax 20.101 MHz，最小 setup +31.633 ns；setup/hold 零违例 |
| FULL 音频 + FFT/LCD 逻辑 | 29329 / 59904 | 12615 / 60780 | 83 / 118 | 96 / 118 | 音频 Fmax 18.471 MHz，像素 Fmax 136.144 MHz；setup/hold 零违例 |

后者使用自动引脚，只用于资源和时序检查，不能下载。LCD 实物验收仍待面板采购及接线冻结。
两个构建均无锁存器，时钟和容量要求保持不变。

- 完整回归 **76 项通过**，用户 RTL 编译及普通仿真无警告或错误。
- 四声部 **128 个非零分量**、2000 个真实采样帧，音源计算仍为 **231 / 256 时钟**。
- FULL 连续 **10000 帧**无丢样或 deadline miss，FFT 与显示各更新六次。
- 实际下载工程综合网表 **3263 个 DAC 帧逐比特相同**，覆盖两音色、合唱、独立延音／混响、五度及上电初始化。
  只加速双方机械按键计数器；没有强制音频数据、ROM、乘法器或 DAC。
  原语模型有 126 条已知未使用存储位宽分支提示，无其它警告、错误或比较失败；没有加载 SDF。
- 新合唱 **4600 个整数参考样本逐个相同**，包括负数插值、地址回绕、干声旁路及脏 RAM 复位。
  新混响通过独立整数延迟模型、接近满幅输入、渐变与尾音检查。
- **16 份各 192000 帧**的新旧音效输出，采用真实 256 时钟预算；均无削波、未知数据或超时。

完整记录见 [full_effects_v2_acceptance.txt](evidence/full_effects_v2_acceptance.txt)。

## 试听与量化

`build/piano/effects_v2` 有 16 份原始输出 WAV、两份 V2 效果顺序试听、两份 V1→V2 延音对照，
以及 `effects_metrics.json` 和 `open_string_effects_comparison.png`。
WAV 为实际 RTL 输出的 48 kHz 立体声 PCM16，没有归一化、额外混响或软件音效。

- `v2_piano_effects_comparison.wav`：无效果 → 合唱 → 轻混响 → 延音。
- `v2_bright_effects_comparison.wav`：同样顺序，使用明亮弦音。
- 每段 4 秒，间隔 0.35 秒；起点为 0、4.35、8.70、13.05 秒。每段只有一次相同 C4 拨弦。
- `piano_sustain_v1_v2.wav`、`bright_sustain_v1_v2.wav`：先 V1，后 V2，各 4 秒。

拨弦后 1.5～2.0 秒，V2 延音比无效果的尾部 RMS：钢琴 **+18.21 dB**，明亮弦音 **+26.68 dB**。
两个音色的无效果／延音基频峰均为 **261.658 Hz**，接近目标 C4 的 261.626 Hz；FFT 网格间隔约 0.183 Hz。
去除最佳拟合音量差后，混响相对干声的残差 RMS 从约 10～12% 提高到约 21%；
合唱左右相关系数由近 1 降至约 0.88。这些数字证明处理差异，听感仍以实际耳机／双扬声器为准。

复现：

```powershell
gw_sh.exe gowin/neo_guitar_audio_full/build.tcl
gw_sh.exe gowin/build_full.tcl
./sim/run_main_regression.ps1 -PythonExe E:/anaconda3/python.exe
./tools/run_piano_gate_check.ps1 -Full
E:/anaconda3/python.exe tools/generate_full_effects_preview.py
```

上板比较时先保持和声关闭，以同一力度拨同一空弦、每次间隔至少 3～4 秒。
比较合唱时第三键置于无效果；比较第三键三状态时先关闭合唱。
再试按品拨弦后松品及三／四音和弦。用户听感验收后再决定是否合并分支。
