Keyi-1/xinxian-fpga-guitar/verification/docs/P2_STATIC_SONG_INTEGRATION.md

# P2 静态多曲目：触控、显示与实际音色集成

日期：2026-10-16。本版在原 `gowin/neo_guitar_touch_game/neo_guitar_touch_game.gprj` 完成综合和 P&R，
主构建始终使用该原工程和原源码。使用 `gw_sh.exe` 打开同一 `.gprj`，依次 `run syn`、`run pnr`；
采用原 CST 和 SDC，运行时钟仍为 50 MHz / 12.288 MHz。
此前 A4 三次尝试各剩 1 条未布通网络；算法 1 试验剩 376 条，四次失败报告均完整保留。
用户明确授权过 Route_Maxfan32、Clock_Route_Order0 和 Route_Option1；仅回退失败试验的 Route_Option 到 2，其他配置字节与原暂存对象保持。最终 A5 使用 Maxfan32、ClockOrder0、算法2。

A5 仅改 P2 窗口控制器的内部存储和命中掩码：已拒绝超过 28800000 样本曲长的既有目录契约，故合法 onset/duration 使用 25 位，elapsed 包括最终 7200 样本判定尾窗仍小于 2^25，结束时间之和小于 57607202，使用 26 位。输入记录和元信息的合法性检查仍为完整 32 位，错误高位不会截断为合法数据。外部 song_time、曲谱和统计接口不变。
四轨命中槽位并列译码 OR，保留原同周期提交；没有增加采样调度或流水级。独立冻结 A4 对照逐时钟比较全部公开输出：821642 拍、2753 次快照、全 2048 事件/32 次环绕、512 组四轨提交、饱和、动态拨弦、十分钟边界、跨 25 位结束时间加法、非法高位、切换与故障均一致，最忙扫描仍为 131 拍/256 拍。
A4 的旧网表结构桥接仅为历史证据；A5 重新完成整机核心/连接/显示/冻结音频 RTL 回归，以及本次实际综合网表三组对照。旧日志不能代替 A5 网表与 P&R 的认证。

原工程可用位流：`gowin/neo_guitar_touch_game/impl/pnr/neo_guitar_touch_game.fs`。
发布副本：`build/releases/touch_game/neo_guitar_touch_game_p2_static_songs.fs`。
SHA256：`8d78cf9005fadfa9aa863adf4e9c17fc494521c68b828ddce6269b8091d87292`。
新验证记录：`gowin/neo_guitar_touch_game/p2_integration_verification.json`。
完整归档：`build/releases/touch_game/p2_static_songs_20261016/`。
P1 归档及 `verification.json` 原样保留；P1 记录不能用来认证这次新产物。

## 可选曲目

| 菜单行 | 内容 | 事件／时长 | 推荐音色 | 节奏 |
|---|---|---|---|---|
| 茉莉花 | 原有单旋律 | 67 / 33.75 s | 钢琴 | 保留原 96 BPM |
| 慢练 | 原创分解和弦练习 | 256 / 256 s | 第二音色（明亮弦音） | 60 BPM，每秒一音 |
| SEVEN NATION ARMY | 升八度短 riff 练习循环 | 168 / 192 s | 哇音 | 60 BPM |
| 情歌前奏 | 四小节前奏和声的自编分解型，八次循环 | 128 / 128 s | 第二音色 | 60 BPM，每秒一音 |
| TEST ONLY | 十分钟时间边界夹具 | 256 / 600 s | 不开放 | 菜单点击无动作 |

《情歌》和 Seven Nation Army 都是此前已说明的短片段练习循环，不是完整原曲伴奏或整首转录。
数据来源、编排范围、离线分弦约束和核心边界见 `P2_STATIC_ENGINE_PROTOTYPE.md`。
电脑仍只负责整理音符事件；FPGA 存谱、显示、判定真实拨弦并实时合成，不使用 PCM 回放。

## 连接与行为

- “曲目编号＋模式”由同一条命令跨时钟传递，数据在确认前保持不变。
  普通游戏与试听使用同一份目录和静态 ROM，启动锁定元信息。
- `game_p2_mode_router` 在采样边界禁止新起音、强制释放旧声，等所有声部静音后确认命令并应用推荐音色。
  推荐音色真正加载到 `guitar_effect_buttons` 的音色状态，原按键仍可继续切换三种音色。
  合唱、五度和声、延音／混响状态和音色参数不变。
- 新的游戏代数用于识别重玩后的新快照，结果页的旧故障／结束状态不会立即取消新一轮。
  核心 fault 自动走强制释放；布局异常通过 UI 退出到结果页，显示 ERROR。
- 256 bit 帧快照保存 32 位曲时／得分、16 位统计、64 bit 消费环、窗口头和代数。
  音频侧提交窗口头与消费位；显示侧继续共享 CDC 的帧保持 bank。
- 显示扫描最多 64 条窗口事件。复用一个 18 位常数除法器生成坐标和尾长；
  对尾长先钳制至 80000 样本，与原 `min(duration/250,320)` 一致。
  有效像素仍使用原四级流水线、六个系统时钟／像素和 x=96 判定线。
- 字库为 114 个常规字符＋12 个原标题 tile，仍在原 2048×16 bit 容量内。
  游戏得分显示六位，结果计数显示五位，不在 255 或 999 时回卷。
  进度条按各曲实际总时长更新；帧中间不改状态。
- 曲谱采用明确的 DPB16 切片和逐行生成的 INIT 常量，逻辑上保留完整 2048×96 bit。
  独立单元为 12 块；生产综合删除未用的分组字段后，实际为 **10 个 BSRAM**。
  音频与显示两读端口各为一拍同步读，静态只读，无运行期写入或读写冲突。
  整机 BSRAM 数量以下方完整 P&R 为准。

### P2 快照布局

| 位 | 内容 |
|---|---|
| 63:0 | 消费环，按全局事件 ID 低六位索引 |
| 95:64 | 32 位采样曲时，倒计时为补码负数 |
| 127:96 | 32 位得分 |
| 143:128 / 159:144 | 连击／最高连击，各 16 位 |
| 175:160 / 191:176 / 207:192 | Hit／Miss／Wrong，各 16 位 |
| 219:208 / 227:220 | 四轨判定／四轨判定代数 |
| 229:228 | 模式，0菜单、1演奏、2游戏、3试听 |
| 230 / 231 / 232 / 233 / 234 | 倒计时、结束、切换、fault、deadline |
| 237:235 / 249:238 / 255:250 | 当前曲目、窗口头、游戏代数低六位 |

未被生产显示消费的位允许被综合删除；统计、消费及判定的 RTL 契约不变。
P1 控制器和默认兼容参数仍用于旧回归，生产顶层 `USE_P2=1` 实例化上述完整连接。

## 同口径完整实现

| 项目 | P1 已发布 | P2 本次完整 P&R | 变化 |
|---|---:|---:|---:|
| Logic | 50159 | 51513/59904 | +1354 |
| Register | 22405 | 23030/60780 | +625 |
| CLS | 27943 | 28455/29952（95.002%） | +512 |
| BSRAM | 95 | 99/118 | +4 |
| DSP | 115.5 | 115.5/118 | +0 |
| 系统 Fmax | 58.765 MHz | 55.880 MHz | -2.885 MHz |
| 音频 Fmax | 14.442 MHz | 15.042 MHz | +0.600 MHz |

P2 符合实际 50 MHz／12.288 MHz 运行与合法资源门槛；CLS 95.002% 超过 95% 余量目标（还需至少减少 1 CLS）。不宣称所有余量目标仍达标。

相较此前未布通的 P2 A4，A5 完整实现减少 Logic 109、Register 151、CLS 57，BSRAM/DSP 不变，并已成功布通。A4 没有有效 STA，不能据此比较 Fmax；上述表格的时序比较使用已发布 P1 与本次完整 A5 报告。
未布通、latch、setup、hold 及已测运算 deadline 均为 0。
完整报告在原工程 `impl/pnr/neo_guitar_touch_game.rpt.txt` 和 `neo_guitar_touch_game_tr_content.html`。
对应综合网表 SHA256：`a4560fbd637231658d9422b95b0d21951cc64078dea90df651ddffe4146aa6d3`。

## 验证范围

- 原九项 RTL 与五项离线分弦测试通过。另通过原按键两个兼容回归，包含真实 245760 拍防抖、
  12288000 拍长按，未强制内部状态；原按键职责保持。
- P2 4 项核心 RTL／五项 Python 数据测试通过，包括 2048 事件、32 次环回绕、300 次统计、
  密度和非法元数据拒绝、Perfect/Good/Bad/Wrong/Miss、四声部、重玩和时间边界。
  最坏每采样 65 次读、131 个忙时钟，低于现有 256 拍采样周期。
- P2 连线回归通过四行触控选曲、诊断行禁用、异步原子命令、实际三种音色非零 PCM、
  试听、手动换音色、延音退出、故障释放和故障后重新开始，共 19542 个采样周期。
- 原与 P2 演奏路径各 8192 样本／2,097,153 参考时钟，与冻结音频 `655458f` 一致，
  覆盖原三音色和音效。延音退出 1452 样本，约 30.25 ms。
- 2,636 次 RTL 布局由独立整除／舍入计算核对：全部五槽事件、消费位变化、窗口回绕、
  倒计时、10 min 和 2^24 时间边界通过。最长 445 个系统时钟，小于保守消隐预算 38,226。
  六位得分、五位计数、进度、RIFF 放大标题的四字符像素及四首准备页通过。
- 显式 ROM 单元综合网表先做 4096 次逐条对照：全部 2048 条 96 位记录在两个异步端口一致，
  跨页、一拍读和停读保持通过。早期自动推断版在第二条记录观察到 MIDI 59→29，
  该版布线已停止，不作为发布；最终版本使用经验证的显式 INIT 映射。
- A5 网表完整保留顶层与真实 ROM－布局连接，核对 1,865 次连续布局，覆盖全部 619 条生产事件。
  原子代数／消费字段在同一帧使用。没有根据优化后的网名猜测并注入组合译码结果。
- A5 网表实际四曲试听和三种音色，通过 10215 样本的 PT8211／I²S 引脚逐时钟对照。
  此测试仅将倒计时计数器缩至一次采样，真实合成、释放和采样节奏不变。
- A5 十帧整机综合网表对照，1,305,600 个有效像素：主页、菜单、选中前奏、倒计时、哇音舞台、
  长曲窗口头／计数、结果页、动态频谱／曲线和页面切换；真实六时钟扫描、触控 GPIO、静音双音频输出一致。
- A5 使用本次新网表重新验证，直接绑定同一 VG 哈希。A4 的两份原始 VG、结构证明和四次失败记录作为历史证据另行保留，不替代 A5 的行为认证。
- 控制器例外仅适用于上述冻结 A4 对照通过的单一模块；八项故意改错测试确认无法据此放过其他模块、错误参考、未验证的源码、错误收据或带 Warning 的日志。音频资产、其余源码和 CST/SDC 保护检查保留。
- 综合、完整 P&R、真实 BSRAM 映射及 STA 通过。本次网表、ROM、源码、日志、报告与位流分别重新哈希绑定。

时间越界测试使用测试台推进内部曲时，不声称完成墙钟十分钟或长期稳定性测试。
尚待 P2 下板反馈：实际触摸方向、听感／音量、完整慢曲游玩及长时间稳定性；没有新定量声学结果。
严格比赛参数组合不作为本训练版的新位流发布；本版保持 `ALLOW_AUTOPLAY_PREVIEW=1`、`ENABLE_MISS_CUE=1`。
UART 导入、MPU、Flash／SD、蓝牙和完整原曲伴奏均未实现。

## 复核与下板

本轮证据目录由脚本保留：

```powershell
./tools/run_touch_game_checks.ps1
./tools/run_game_p2_window_equivalence.ps1 -RunDir sim/temp/p2_window_opt_r2
./tools/run_touch_game_checks.ps1 -RunName p2_a5_integration -Benches tb_game_p2_connection,tb_game_p2_display,tb_game_p2_audio_preservation
./tools/run_game_p2_checks.ps1 -RunDir sim/temp/p2_a5_core
./tools/run_game_p2_gate.ps1 -GateDir sim/temp/p2_a5_gate_origin -Benches tb_game_p2_engine_gate
./tools/continue_game_p2_gate.ps1 -OriginGateDir sim/temp/p2_a5_gate_origin -GateDir sim/temp/p2_a5_gate_final
E:/anaconda3/python.exe tools/check_game_p2_result.py --build-dir build/p2_integration/impl_a5_bound_time --gate-dir sim/temp/p2_a5_gate_final
```

上述目录对应已通过的这一次构建，不应为刷新状态重复运行。新改动使用新的证据目录；旧 P1 校验器和归档不改写。
原工程综合清单与失败布线报告在 `build/p2_integration/impl_a4/`；第二次失败记录在 `build/p2_integration/impl_a4_route32/`；
第三、四次失败记录分别在 `build/p2_integration/impl_a4_route32_clock0/`、`build/p2_integration/impl_a4_route32_clock0_algo1/`；最终记录在 `build/p2_integration/impl_a5_bound_time/`。
后者明确绑定新源码清单、控制器独立参考证明、本次综合网表、用户授权及配置前后哈希，本地归档同时保存这些证据和源码快照。
源码归档仅用于追溯，综合和 P&R 始终使用原 `.gprj` 与原 `impl`。

1. 在 Gowin Programmer 直接选择原工程的新 `.fs`，或同哈希 P2 发布副本；无需为使用位流再综合。
   若 Gowin IDE 此前一直打开，重开同一 `.gprj` 刷新新增文件列表即可。
2. 保持现有接线和 J17 1–2 可靠连接，先查看主页、触控菜单及第五行禁用行为。
3. 选择“情歌前奏”，试听应是第二音色的慢速分解；选择 SEVEN NATION ARMY 应为哇音。
   准备、舞台和结果显示当前曲目；原音色按键仍可手动换音色。
4. 进入实际游戏，四轨无需按品，对准 x=96 拨弦，核对判定、Miss 提示和进度；
   开延音后双击退出，确认旧声释放、菜单恢复、重玩仍为原选曲。
5. 再测演奏模式三音色、音效和双输出，最后检查完整慢练／长时间运行。

代理没有烧录硬件或推送远程。本次下板反馈后再决定后续长曲内容或导入阶段。
