Keyi-1/xinxian-fpga-guitar/verification/docs/QING_GE_USER_MELODY.md

# 《情歌》用户谱完整主旋律试奏版

2026-10-18：当前主工程已由[P3可写曲库/UART发布](P3_WRITABLE_SONG_IMPORT.md)更新。本页M2资源、位流哈希和验证只认证固定主旋律历史归档；同一38小节/212起音内容、第二音色及用户暂接受的第10/18小节时值继续保留在P3。当前原`impl`应使用P3认证，不能套用本页旧日志。

## 本次内容与明确许可

输入为用户于 2026-10-16 提供的两张 EOP / Wuyangr 双行钢琴简谱图片，原谱 G 调、4/4、72 BPM。
保留原图和哈希于 `scores/p2/source/qing_ge_user_page_1.jpg`、`qing_ge_user_page_2.jpg`，
逐音读谱记录在同目录 `qing_ge_user_melody.json`，生成的逐音审计在 `scores/p2/qing_ge_transcription_audit.json`。

本版取上行主旋律，覆盖图片全部 **38 小节／152 个四分音符拍**；按已选慢练速度 **60 BPM**，长 **152 s**。
下行分解伴奏没有变成拨弦任务，也没有新增自动伴奏玩法。
这是用户提供的整份简化编配，不声称包含原唱录音中未给出的所有段落。

用户已明确同意：

1. 保留所有音程，整曲降一八度，将游戏音域扩为 **D3～G5（MIDI 50～79）**；演奏模式保持原样。
   原谱常规 G4 唱名基准下为 D4～G6。第 36 小节双高音点的 1 按原图保留为 G6，输出 G5，没有偷偷折回。
2. 第 **10、18** 小节可见时值各少半拍；将两处“5”由半拍改为一拍，补足四拍。
   这是用户接受的试行修订，不冒充无歧义的原谱内容；原始读法与修订分别保留。2026-10-18 用户下板后认为这两处仍有轻微节奏偏差，但影响不大，当前保留为已知待改进项。

合并 30 个灰色同音延续、保留 13 处休止和三连音，共 **212 次真实起音**。
跨第 5→6、13→14 小节的延音连续，不重复起音。末小节保留完整四拍长音。
没有把前奏循环重复拼成整首，也没有从别处补录未提供的旋律。

## 代码范围

- 原第 3 槽替换为“情歌”，推荐第二音色，菜单/准备/游戏/结果名称同步，舞台标为 MELODY。
  原前奏 CSV/二进制及已发布片段位流保留作历史，不再作为生产槽 3。
- `qing_ge_user_score.py` 用有理数生成全部起音/结束样本，逐小节核对四拍，检查连音相邻与同音。
  生产库现在 959/2048 事件，前四曲 703 事件；前三曲及十分钟诊断的事件数据不变。
- 新 `game_extended` 只用于无需按品的游戏谱。沿用已有分配器的同弦不重叠、临近音换弦代价与密度检查，
  允许四个合成声部接受 D3～G5。原 `physical` 默认仍使用既有 0～8 品候选和 D3～C5。
- P2 控制器的 DDS 暂存/表从 26 扩到 27 个有效位，外部仍为 32 bit 精确相位增量。
  音频链只增加参数，使 P2 的原滑音器用 27 个有效位；其他工程默认仍为 26。
  不扩大滑音器会在 G5 持音时丢掉 bit26，因此新增完整 32 位参考对照。
- 钢琴模态/谐波、音效、采样率、PCM/DDS 分辨率和时钟不变；CST/SDC/接线不变。
  进度步长与目录由同一生成器输出，不再独立写死旧前奏的 128 秒。
- 可见曲名复用现有“情歌”字样，MELODY 使用新消息；字库本体及原标题图块不变。

## 验证与构建结果

用户追加的标题修订已纳入：可见曲名统一为“情歌”；准备／结果页两字框 x=224～255，按 480 像素画面居中；选曲列表保留行内左对齐，游戏顶部保留原信息区。以冻结 M1 独立核对 20 屏／2,611,200 像素，其他像素及原演奏模式不变。

本批已通过原工程综合、完整 P&R/STA 和所需数字验证。本次使用 `gw_sh` 打开用户平时使用的同一 `.gprj`，执行 `run syn` / `run pnr`，直接生成原 `impl` 产物，没有另建工程。
原工程位流：`gowin/neo_guitar_touch_game/impl/pnr/neo_guitar_touch_game.fs`。
独立发布副本：`build/releases/touch_game/neo_guitar_touch_game_qing_ge_melody.fs`。
两者 SHA256：`c0a138912edbf2504f64143049066234c4f10ea381fd974b9c58f6b147bd3bf4`。
认证：`gowin/neo_guitar_touch_game/p2_qing_ge_melody_verification.json`；完整证据归档：`build/releases/touch_game/qing_ge_melody_20261016/`。
历史片段和 P1 位流、各自认证保持原样，不能混用日志。

同一器件、同一原工程完整实现报告口径：

| 项目 | 已下板片段版 P2 | 本批 38 小节主旋律 |
| --- | --- | --- |
| Logic | 51513/59904 | 52286/59904 |
| Register | 23030/60780 | 23079/60780 |
| CLS | 28455/29952 | 28470/29952 |
| BSRAM | 99/118 | 99/118 |
| DSP | 115.5/118 | 115.5/118 |
| 系统 Fmax | 55.880 MHz | 55.334 MHz |
| 音频 Fmax | 15.042 MHz | 13.143 MHz |

CLS 为 95.052%；三项旧 P1 余量目标未全部达到，不能用本批合法实现宣称余量目标达成。实际运行时钟保持 50／12.288 MHz。
系统已达到 55 MHz 目标；CLS 尚需减少至少 16 个，音频 Fmax 距 13.5 MHz 目标尚差 0.357 MHz。
资源均合法，未布通、latch、setup／hold 及已检查音频／曲谱／布局 deadline 均为 0。音源模态、效果、FFT、采样率、位宽、时钟和 CST/SDC 保持。

验证范围：

- 20 项主旋律 RTL bench（标题修改只复用这些源码证据，另加 20 屏独立标题对照）：五项 P2 核心、四项集成／音频、原九项触控／游戏与两项按键兼容；另有旧 MIDI50～72 域冻结控制器逐拍对照 821,642 时钟／2,753 快照，不将该旧域证明扩称为新音域证明。
- 整份 212 音的试听／全 Perfect／全 Miss／重启，以及 MIDI50～79 的每个精确 DDS 值。控制器时间加速 4000 倍：四分拍为 12 样本，十六分／三连音保持精确；生产 48 kHz 不变。最高每 256 时钟 65 读／131 忙。
- 原演奏 8192 样本／2,097,153 参考时钟与冻结提交 `655458f32ba4f7e06403fd6c5c4da0b6f0dad8a7` 一致，延音开启退出仍 1452 样本。扩展音域四声部以完整 32 位滑音参考对照 9032 样本，覆盖三音色／全部音效、G5 持音 bit26、双向滑音及强制释放。
- 2888 次连续 RTL 布局，最慢 445 时钟，小于 38226 消隐预算；24 项 Python 测试包含格式／分弦／MIDI 导入／两页谱转换。字库 114 字形与 12 标题图块保持。
- 最终 M2 实际综合网表：四首选曲／三音色的音乐 PT8211/I2S 对照、2117 次布局、10 帧 1,305,600 有效像素和实际六系统时钟／像素扫描、动态频谱／页面切换对照。
- 实际完整 VG 另按已证明的 25 个 elapsed DFF Q 寄存器推进时间，逐一触发全部 212 次真实曲库读取／DDS 解码／起音（含第36小节 G5 bit26），55,222 时钟内与 RTL 的控制和音乐串行输出一致；只加速计时，不注入曲库、相位或起音结果，不冒充墙钟整首播放。
- 实际完整 VG 的 DPB 两个异步端口共 4096 读，覆盖所有 2048×96 bit 记录、G5、跨页、读延迟和停读保持；实际映射 10 个 DPB16（恒零 group 切片消除）。新增音域门级检查从控制器已注册输出注入 D3/C5/F#5/G5，保留真实路由／音频链／串行输出，对照 G5 持音、双向滑音及延音退出。这是明确的组件边界注入，不冒充墙钟整首门级播放。

标题修改后 Gowin 改变了网表边界，未采用旧网表复用方案；上述六项实际综合网表检查全部在最终 M2 新 VG 重跑并重新绑定。仅源码回归使用严格限定的 renderer 三处字／坐标变化例外，其他运行源码哈希均保持，并以新增 20 屏冻结像素对照单独验证。M1 候选和未采用的图复用检查按历史保留，不能认证 M2。

综合／P&R 进程、源码清单和日志在 `build/qing_ge_melody/impl_m2_title/`；所有认证哈希重新绑定本批实际源码、ROM、VG、构建日志、P&R、STA 和位流。
最终版证据通过后不重复构建相同源码；M1 到 M2 因用户新增标题要求重新实施。保护的工程 process_config 与 MPU 文档保持原字节和暂存对象。

## 下板核对

1. Programmer 直接选择上述原工程 `.fs` 或同哈希独立副本，沿用原接线。无需重新综合；本次没有代理烧录或 push。
2. 游戏选曲第四行“情歌”，确认推荐第二音色，先试听。主内容 60 BPM／152 秒；核对第 10、18 小节加长半拍的修订、第 36 小节高 G、长音／三连音、末小节完整四拍和全曲曲式。
3. 开始演奏并核对判定／Miss、进度、结果／重玩；延音开启双击退出，确认旧声释放。再抽查其他三曲、演奏三音色、按键音效与两路音频。

这份交付覆盖两张图片的全部 38 小节上声部，不声称补齐原唱录音未提供的段落。下行伴奏尚未接入本次主旋律游戏。
2026-10-18 用户报告当前版本已经过下板验证，整体可以接受；第 10、18 小节仍有轻微节奏偏差，影响不大，先保留当前时值并登记为已知待改进项。此反馈不等于节奏完全准确，也不单独认证第 36 小节高 G 的定量表现。

反馈已记入 `hardware_acceptance.json`；未另行采集现场烧录文件哈希、定量声学或长期稳定性测量。数字认证及发布归档保持原样，本次仅记录反馈，无源码变化，不重复构建。下一主线为 P3 可写曲库与 UART 导入；已到货加速度计可先做独立读取和安装校准，正式姿态联动按 P4 推进。
