Keyi-1/xinxian-fpga-guitar/verification/misc/roadmap.md

# 从零到基础要求：建议时间安排

假设每周投入 10～15 小时，三人并行。

## 第 0 周：准备

- 确认报名题目为高云选题二；
- 建立 Git 仓库；
- 安装 Python、VS Code、Icarus Verilog、GTKWave；
- 阅读高云赛题原文，确认禁止软核/MCU 的边界；
- 不买板，先运行本目录的 Python 参考程序。

交付物：能生成 440Hz WAV，能读懂工程目录。

## 第 1 周：数字音频基础

- 了解采样率、位宽、频率、周期；
- 用 Python 生成正弦、方波、三角波、锯齿波；
- 验证 48kHz、16bit 音频；
- 完成 DDS 数学模型；
- 完成 256 点波表。

交付物：`sine_table.hex`、参考 WAV、频率测试结果。

## 第 2 周：第一个 HDL 模块

- 学 Verilog 的时钟、复位、寄存器；
- 完成相位累加器；
- 完成 ROM 查表；
- 完成单声部 DDS；
- 用 Testbench 导出样本。

交付物：单声部仿真波形和 440Hz 频率误差。

## 第 3 周：按键与音符

- 写按键同步器；
- 写按键去抖；
- 写 8 个按键到音符的映射；
- 预计算 C4～C5 的 phase_inc；
- 完成按下发声、松开发声停止。

交付物：仿真中能按事件切换音符。

## 第 4 周：四复音

- 写 4 个 voice；
- 写声部分配器；
- 写按键释放逻辑；
- 写 4 路定点混音；
- 做溢出保护。

交付物：同时触发 4 个音符的仿真结果。

## 第 5 周：第二个控制维度和包络

- 音色选择：正弦/方波；
- 音量控制或八度切换；
- 加简单 Attack/Release；
- 测量按键到声音数据变化的延迟。

交付物：满足“2+ 控制维度”的 HDL 版本。

## 第 6 周：I2S 仿真

- 明确 DAC 的 I2S 格式；
- 写 BCLK/LRCK/SDATA；
- 用 Testbench 检查串行数据；
- 不接板也先验证 I2S 时序。

交付物：I2S 时序波形和数据恢复脚本。

## 第 7 周：第一次上板

- 安装 Gowin IDE；
- 建立工程；
- 约束时钟和 I/O；
- 下载固定测试音；
- 再下载按键单音。

交付物：板上固定音、按键单音。

## 第 8～9 周：板级四复音和音色

- 接 I2S DAC；
- 四复音；
- 两种音色；
- 长时间运行；
- 修复按键、噪声、时序问题。

交付物：基础功能完整演示。

## 第 10～12 周：稳定性和材料

- 连续运行测试；
- 测量复音数、延迟、资源、时钟；
- 整理 HDL 源码；
- 录制演示视频；
- 写设计报告和答辩 PPT。
