Keyi-1/xinxian-fpga-guitar/verification/docs/PERFORMANCE_VIBRATO.md

# 演奏主链路颤音接入

2026-10-23。用户选择保留当前松品回空弦的操作，连续松按同一品位三次后开启颤音。基线为 `5ad92f0c4ec2b877e750ea59c0372c40c1075d75`，已验收 ID70 完整版与 Flash 断电启动继续保留。

## 操作与声音边界

- 在演奏模式，先按品并真实拨弦，使该弦正在发声；在同一品位完成三次松开／按回。
- 每次松开时间为 60～200 ms，三次手势需落在约 600 ms 窗口内。未达到次数、超时、换到其他品位均不触发。
- 每次松品仍立即选择空弦，并保持原来的 20 ms 滑音和自然衰减；手势模块只观察接触变化，不产生 Attack、note_off 或旧版 250 ms 等待。
- 第三次按回后，待原滑音结束，以约 6 Hz、Q15 深度 380（约 ±20 音分）调制该弦音高。四弦独立；只按品不会凭空发声或复活已结束音符。
- 松品、换品、真实重拨、该声部自然结束、退出演奏或复位，会清除对应颤音；单弦重拨或换品不取消其他弦。
- 游戏、试听和倒计时不启用该手势，曲谱音高与判定保持。IMU 自动音色仍遵循空闲、手动优先和已有尾音保护。

## 实现

旧版 `a8bffe7` 的 `phase_vibrato_modulator.v` 与三次松按识别作为参考。没有把旧 `fret_note_event` 接回主链，因此没有恢复延后松品和松品 note_off 的旧语义。

新增 `performance_vibrato_gesture.v` 观察真实矩阵去抖结果；`guitar_touch_game_audio.v` 只在演奏模式交给它识别。`four_string_board_audio_chain.v` 在已有滑音之后、声音合成之前应用 `four_string_vibrato_serial.v`。关闭或取消时组合旁路，真实拨弦的同样本音高与包络保持。

调制器共享一个移位加法乘法器；默认 380 系数只需 9 位，V4 四声部在 44 个音频参考时钟内完成下一采样的准备，低于每样本 256 时钟预算。保留旧 Q15 算术移位的负数向下取整、无符号 32 位相位范围和饱和语义。输入在运算中改变或取消时丢弃旧结果；溢出运算预算会置位 deadline 标志。

## V2 历史验证：功能通过，时序未通过

V2～V5 均未发布可下板的新颤音位流。原工程始终使用 `gowin/neo_guitar_touch_game/neo_guitar_touch_game.gprj` 和原 `impl`，CST／SDC、时钟、音源模态与音效参数不变。

- 冻结前版源码、原工程位流／网表／报告及保护文件保存在 `build/vibrato/before_20261023/`；固定 ID70 发布 `build/releases/touch_game/p4_imu_id70_20261023/` 和同名 `neo_guitar_touch_game_p4_posture.fs` 保持。
- 第一候选 V1：组件、51,001 样本独立音频参考、冻结音频、姿态／显示 RTL 均通过。综合 Logic 52317、Register 21191、逻辑 BSRAM 108，DSP 原语与基线一致。未进行 P&R；完整网表保存在 `build/vibrato/v1/synthesis_artifacts/`。因可去除两组冗余快照而被 V2 接续，不把 V1 综合数据作为最终资源。
- V1 的 Windows PowerShell 进程对象没有返回子进程退出码，原 `process.json` 中保留 `null`；成功判据为带错误捕获的 Tcl 完成标志、综合完成日志、无错误和新鲜资源／网表文件。V2 改用可靠的 Python 子进程退出码记录，不伪造旧退出码，不重复已经成功的 V1 综合。
- V2 组件 `vibrato_components_07` 已通过：33 次手势刺激，21,022 个采样、168,176 次相位对照，默认最长 48 时钟，另检查满 16 位深度、动态输入、复位和故意超预算报警。
- V2 综合 PID 5820 已成功结束，真实退出码 0；Logic 51758、Register 20929、逻辑 BSRAM 108，DSP 原语保持。相较 V1 减少 559 Logic、262 Register。实际 VG SHA256 为 `aba7640ee17b9871033acf739b258f6b23045e7fe95119f9d96f2769cef53d7e`；以上综合数据不代替最终物理资源。
- `vibrato_audio_04` 通过：关闭颤音时 12290 样本等于冻结旧链，启用时 51001 样本等于独立直接乘法参考，13056513 个 PT8211／I²S 时钟对照一致，覆盖三音色、四档力度及原音效。
- `vibrato_top_02` 的 ID68／ID70 整机与 12 场景／1566720 有效像素通过；`vibrato_legacy_03` 的冻结音频、扩展音域、判定、真实按键和分弦检查通过。`vibrato_physical_top_02` 通过真实四弦矩阵／三次生产时值松按，共 23134 音频样本。
- 当前实际 VG 的四弦四档 ADC／SPI 对照 `vibrato_adc_gate_01` 已通过：4739008 时钟、32238 次转换。曲库 384 组及四声部真实增益操作数 128 组审计均通过。
- 当前实际 VG 的姿态整机 `vibrato_posture_gate_01` 已通过：真实 MPU 引脚、生产 256 包校准、实体音色键、AUTO／尾音／手动优先／退出／恢复，共 12838 音频样本、1773 读包、5 次音色变化、11246883 LCD 时钟样本。仅保留原有明确行号的 vendor `vopt-2697` 例外，项目警告与错误均为 0；LCD 时钟样本不是独立像素数。
- V2 UART／显示整机 `vibrato_full_gate_01` 已通过：10 次真实 115200 事务、四声部、13397 音频样本、16 帧／5875200 LCD 时钟样本。物理矩阵颤音 `vibrato_gesture_gate_01` 已通过：26821 音频样本、4633 MPU 包、23500800 LCD 时钟样本；三次生产时值松按、立即空弦、四弦隔离、重拨／游戏／退出均覆盖。
- V2 P&R PID 10256 已于 12:40 结束，但最终 STA 拒绝：系统 Fmax 37.655 MHz、950 个 setup 违例；音频 12.732 MHz、hold 0。Logic 52147、Register 20929、CLS 28805/29952、BSRAM 113、DSP 115.5。最差路径为扫描 v_count 到 UI 的 tails1，slack -6.557 ns。该版不可下板，未发布；完整源码、VG、FS、P&R／STA 已保存在 `build/vibrato/v2/implementation_artifacts/`，拒绝状态见 `candidate_status.json`。旧 ID70 发布仍保持。

## V3 选择器实验：综合收益不足，已撤回

只将 UI 的八组跨全曲谱动态选择改为先选四轨之一，再作八组固定切片；不增流水线、不改像素节奏、RGB、字库、音色或音频链。

- 独立冻结 ID70 UI，`vibrato_ui_01` 已通过 12 场景／1566720 像素／9408537 时钟的逐时钟 RGB 和页面对照，覆盖全32槽、动态布局、全部9位 y、菜单／游戏／IMU／切页。
- `audit_vibrato_ui.py` 只允许五处精确源码替换，对全部512种 y、32槽、centre／tail／valid 的90112个符号输入位选择逐一证明相同。原裁剪、算术、舍入、状态和全部 RGB 输出语句保持。
- 原工程 V3 综合 PID 16512 已结束：Logic 51944，比 V2 增加186，寄存器20929保持；综合估算系统 Fmax 从44.713降至41.619MHz（不是物理结果）。未进入P&R，实验已撤回，生产 UI 恢复原字节。完整综合产物保存在 `build/vibrato/v3/synthesis_artifacts/`，不用于发布。

## V4 音频／手势优化：V5 沿用

只改颤音内部实现：移除与最终累加器重复的 product 寄存器、合并准备状态，用一条带低位进位的加法链精确完成正负 Q15 舍入与基准相位相加，四组已有基准比较共用。手势改为等价剩余时间计数，减少常数比较。生产 UI 保持原样。

- `vibrato_components_09` 全部通过：原33次边界手势、21022采样／168176次相位核对，默认44时钟；新增冻结V2手势逐时钟核对108201采样／400000随机边沿，覆盖生产与缩短参数，并持续检查“剩余+已过=原时限”不变量。
- `vibrato_audio_05` 全部通过，仍为冻结12290／独立参考51001样本、13056513个双音频口时钟，且与V2相同的37668个样本体现启用颤音的预期变化；三音色／四力度／全部音效与松品语义保持。
- `vibrato_top_03`、`vibrato_legacy_04`、`vibrato_physical_top_03` 均已通过，覆盖ID68／70整机、1566720像素、冻结8192／扩展9032音频样本、判定／实体按键、23134个物理矩阵演奏音频样本。
- 原工程综合 PID 25080 已结束：Logic51650、Register20878，仅比V2少108 Logic和51寄存器。未进入P&R；保留本节精确音频／手势实现，V5另直接拆分显示关键路径。

## V5 显示关键路径修复：功能通过，STA 仍拒绝

针对 V2 实测最差的扫描计数到 UI 尾迹寄存器路径，原四级像素流水线内把尾迹长度比较从第一级移到已有的第二级；原 dx／valid／local_y 与原始9位尾迹长度同沿寄存，布尔谓词及符号舍入不变。扫描器同步保存 `pixel_y=(v_count-12) mod512`，同行／换行／帧回绕／复位均无坐标延迟，不增加像素流水级。

- `vibrato_display_timing_02` 通过：1566720像素／9408537时钟／12场景，尾迹标记、RGB、页面逐时钟一致；另1917150扫描时钟、1567607有效期时钟样本、5个帧起始，所有坐标／mask／RGB／DCLK／同步／DE逐时钟一致，仍六时钟一像素。全512种y、32槽、完整字段边界和复位／消隐／切页均覆盖。
- `audit_vibrato_timing.py` 限定全部精确源码变换，验证尾迹谓词跨共同寄存器的等价身份和584种完整行计数状态转移。不增加任何时序例外，也不修改CST／SDC。
- 原工程综合 PID39608已成功结束：Logic51518、Register20951、逻辑BSRAM108，DSP保持；实际VG SHA256 `52a9495972ca542db8ef7179a5f818cffcb59138433c7dd16459c5696c1ed16c`。物理资源和Fmax仍以当前完整P&R为准，不用综合估算宣称通过。
- `vibrato_top_04`、`vibrato_legacy_05`、`vibrato_physical_top_04` 当前完整RTL均通过。只复用V4已通过的两个独立音频／手势记录：它们编译但未实例化的UI／扫描文件有变化，静态模块闭包与原日志的加载模块均排除这两模块；所有实际音频／手势／ROM／bench／工具字节一致。复用例外只限这两文件、两个记录，当前显示证明仍须独立通过。
- V5实际VG四弦四档ADC／SPI `vibrato_adc_gate_02` 已通过，4739008时钟／32238转换；曲库384组及四声部真实增益128组静态审计已通过。其余实际VG整机为 `vibrato_full_gate_02`、`vibrato_posture_gate_02`、`vibrato_gesture_gate_02`，不复用V2网表日志。
- 原工程完整 P&R PID40264 已结束。最终系统 Fmax 45.902 MHz、音频 Fmax 11.955 MHz，setup 违例 113、hold 0；Logic 51903、Register 20951、CLS 28889/29952（97%）、BSRAM 113、DSP 115.5。显示最差路径已消失，但新的音频最差路径落在 `phase_slide_smoother` 的精确 `/15` 除法器，系统最差路径落在既有 `guitar_radial_bands` 状态；后者是用户明确拒绝继续改动的历史实验区域。V5 不可下板、未发布，拒绝记录保存在 `build/vibrato/v5/candidate_status.json`。

## V6 精确除法替换与最终物理实现

V6 只把生产 `SLIDE_SAMPLES=960=64×15` 的无符号 `/15` 换成精确移位加法倒数和一次余数校正；其余滑音状态、舍入、采样延迟与接口逐字节保持。对全部小于 `2^33` 的输入，近似商只可能等于真商或小一，余数范围为 0～29，因此低 5 位余数与 `>=15` 校正给出精确商，不引入 DSP 或新流水级。证明记录为 `build/vibrato/divide15_candidate/proof.json`。

- 当前源码重新通过 `vibrato_divide15_06`：穷举 4,194,304 个 22 位输入，另测 400,000 个 27/33 位输入及 120,000 个动态时钟；五组 phase26/27/32、slide960/15/997 的输出、step、busy 每拍等于冻结旧实现。完整音频链另有冻结 12,290 样本、独立参考 51,001 样本、13,056,513 个 PT8211／I²S 时钟，覆盖三音色、四档力度、全部音效、滑音／空弦／重拨／释放且无 deadline。
- 原工程 V6 综合退出码 0；Logic 50618、Register 20959、逻辑 BSRAM 108，DSP 原语保持。实际 VG SHA256 为 `0e825c35bac0db47327279f2866cc4aa75797c922e54d671c8328bc931938663`，相较 V5 综合减少 900 Logic。
- 原工程 V6 完整 P&R 退出码 0；Logic 51019、Register 20959、CLS 28447/29952（95%）、BSRAM 113、DSP 115.5。系统时钟要求 50.000 MHz、实际 Fmax 50.003 MHz；音频时钟要求 12.288 MHz、实际 Fmax 17.668 MHz；setup／hold 违例均为 0，无 latch、未布线或约束变更。系统余量只有 0.003 MHz，属于达标但极窄，不宣称有额外环境余量。
- 新位流 SHA256 为 `997baf9cfa57e3e6fd65250a3ab0452cde10802f53405043b50a3b748269566b`。V6 实际网表的曲库 384 组写入隔离、四声部 128 组增益操作数审计和四弦四档 ADC 门级测试均通过。UART／游戏／LCD 整机通过 10 次真实 115200 事务、13397 个音频样本和 16 帧／5875200 个 LCD 时钟样本；ID70 姿态整机通过生产 256 包校准、12838 个音频样本、11246883 个 LCD 时钟样本及 1773 次 MPU 读包；物理矩阵颤音整机通过三次生产时值松按、立即空弦、四弦隔离、重拨／游戏／退出，覆盖 26821 个音频样本、23500800 个 LCD 时钟样本及 4633 次 MPU 读包。最终统一审计为 PASS。

最终记录为 `gowin/neo_guitar_touch_game/vibrato_verification.json`，独立发布位流为 `build/releases/touch_game/neo_guitar_touch_game_vibrato.fs`。保留已确认的 ID70/P4 发布以便回退；本轮不代替用户烧录或自动推送，硬件颤音手感仍待用户下板确认。

## 验证范围要求

组件检查次数／时值边界、四弦隔离、模式／复位／重拨／自然结束、松品立即回空弦；相位检查使用直接整数乘法的独立参考，并覆盖有符号舍入、饱和、输入动态变化和 deadline。音频同时对照冻结旧完整链与独立调制参考，覆盖三音色、四档力度、原音效、滑音和双输出。

原有 655458f 冻结音频仍仅允许已经授权的三处力度增益常数变换。现有断言、音频保护和警告检查不删除；旧 bench 只补四处新增可选端口的显式关闭连接。实际综合网表必须重新验证真实矩阵列输入、生产手势时值、MPU、UART／游戏／四声部／LCD 和采样预算，再核对原工程完整布线及时序。

最终资源以新完整 P&R／STA 为准。固定旧版的 50.072／13.687 MHz 不能用于认证新颤音位流；硬件颤音手感、误触与实际听感仍需用户下板确认。

## 下板试听

1. 先用 SRAM 加载新的完整颤音 `.fs`。已确认可用的 ID70 固件和 Flash 内容可留作回退；确认本版后再按原流程更新 Flash。
2. 进入演奏模式，可先选第二音色并开启延音，以便听清尾音。按住任一品位，真实拨弦一次。
3. 在约 600 ms 内，对同一品位完成三次“松开、按回”，每次松开约 60～200 ms；第三次按回后保持按住，听音高约每秒起伏六次。过程中不再拨弦，也不需要额外按键。
4. 松开应立即选回空弦并继续自然衰减；再次真实拨弦应重新起音并取消该弦颤音。换品只取消相应弦，其他正在颤音的弦保持。
5. 对四根弦分别试验，并检查普通换品不会频繁误触。再确认游戏／试听音高、双击退出、IMU 校准和空闲切音色仍正常。

数字对照不代替实物手感和声学测量。需要用户确认实际矩阵去抖、松按动作带来的压电串触发、颤音深浅／速度和尾音听感；本轮不代理烧录硬件。
