Keyi-1/xinxian-fpga-guitar/verification/docs/DYNAMICS_TUNING.md

# 第一弦误触与最低档响度调整

后续边界：用户已要求第三弦更灵敏、中间两档改为50%/75%，当前原impl和同名发布FS由[四等分力度版](QUARTER_DYNAMICS.md)接续，认证为`quarter_dynamics_verification.json`。本文CH2=80、64/160/208/256及e97afee4...仅适用于`p4_dynamics_tuning_20261019/`内部固定旧FS，不认证此后的同名发布文件。

2026-10-19：用户反馈弹其他弦时第一根弦易误触，随后要求最低档音量更小、扩大强弱对比。基于已验证力度版`df770fa`仅作两个生产常数修改；其余演奏、游戏、曲谱、显示、UART、姿态及接线保持。旧版标签`snapshot/p4-velocity-before-ch0-threshold-20261019`及固定归档`build/releases/touch_game/p4_velocity_calibration_20261019/`保留，旧位流SHA256为`210877be3e236c36d431e67bd116a6c9b0c2ac4e6d7b18912b162473b2b5812c`。

## 参数与行为

| 项目 | 调整前 | 本次 |
| --- | --- | --- |
| 第一弦E4 / MCP3208 CH0触发偏差 | ≥150 | ≥220 |
| CH1 / CH2 / CH3触发偏差 | 100 / 80 / 100 | 保持 |
| 最低档0增益Q8 | 112/256，满力度振幅43.75% | 64/256，满力度振幅25% |
| 档1 / 2 / 3增益Q8 | 160 / 208 / 256 | 保持 |

偏差仍为`abs(sample-2053)`；新触发220是根据用户现象选择的首轮试板值，未声称经过新ADC实测标定。CH0最低档有效峰值范围缩为220～279，其余分档[280,430,620]、回落20、死区400、稳定80、首样本加随后32通道样本取峰保持。没有增加跨弦互锁或消音，因此同时拨多根弦仍可发音。若实际串弦扰动超过220，单靠此次阈值仍可能触发；需结合下板结果或标注ADC波形继续定值。

最低档增益作用于四弦全部三音色，降低的是轻拨档，不改变中高三档和主音量。新最低振幅为原最低的4/7，最大与最小数字振幅比由16/7增至4；这些是数字增益比例，不是人耳响度倍数或绝对声压。钢琴模态、谐波、真实击弦、弦音/哇音参数、包络、音效、采样时钟和位宽不变；试听固定力度2。

## 数字验证

生产源码`855e63d`，严格源码守卫仅允许`guitar_config.vh`的CH0触发150→220、`piano_voice_core.v`的档0增益112→64两个常数改动，所有其余生产源码/ROM/GPRJ/CST/SDC与保存版本相同。三个上传原文件和原始校准证据继续保留，不重写为新试验值。

- `dynamics_detector_01`已PASS：16384组通道/ADC码、132峰值位置、动态捕获/回落/复位、固定2选项、真实SPI四弦×四档。新增140组正负150～219的模拟串弦扰动，与旧150阈值同场比较：CH0不再触发，其他三弦事件/力度/待捕获逐周期一致；220边界真实起音仍为最低档，其他三弦活动不阻挡它。
- `dynamics_audio_01`已PASS：冻结上版音源30024样本，三音色×三频段×四档；其中档1～3的8694样本逐样本相同，档0的21330样本满足64/112缩放及整数舍入误差界，模态源/包络/调度相同。涵盖击弦、五度、延音、哇音年龄边界和释放，deadline为0。另有真实ADC→生产路由→三音色×四档每档1024样本，逐PCM/PT8211/I²S对照、能量递增、12项单声部干声无硬顶；音效/四声部/捕获期姿态保护及生产姿态策略/整机2853样本通过。
- `dynamics_legacy_01`已PASS：8192样本/2097153时钟的冻结演奏链、P2判定、9032样本扩展音域参考、实际按键。冻结基线仍为655458f，但本次仅在独立参考音源中同样应用用户授权的档0增益112→64，校验器逐字审计这一处改动及名称/路径转换；不能将结果称为档0也与旧未改PCM完全相同。旧原始基线及旧校验器不变。延音退出仍1452样本。

原工程综合PID12236已结束并审查PASS：Logic50200=LUT39700+ALU10500、FF20139、逻辑BSRAM108，DSP原语不变。当前VG SHA256为`b5896b26820e9ff7d90c3e53d118a68f31fb6c8ca25682587b5bb2598c0e6769`；384组本批曲库连线审计PASS。另对四声部实际速度乘法器输入作128组完整布尔组合审计，证实演奏/游戏两种来源下所有四档真实DSP增益均为64/160/208/256，未选中的另一输入不影响结果，DSP输入/输出流水线参数与保存版相同。它补充两个整机门级轨迹使用试听固定力度2的覆盖边界，没有强制网表信号。

实际ADC网表`dynamics_adc_gate_01`已PASS，生产SPI4/捕获32/死区400/稳定80、四弦×四档，4739008时钟/32238转换逐周期对照，含新CH0最低档边界。完整VG入口`dynamics_full_gate_01`/`dynamics_posture_gate_01`均已结束PASS：前者10次真实115200事务、实际RAM写/读回CRC/原子提交、四声部、13397音频样本/16帧/5875200 LCD时钟采样，含动态频谱与曲线渐暗；后者真实MPU GPIO/生产256包校准/物理音色键/尾音待命/退出/恢复、12815音频样本/1773读包/5次音色变化/11226240有效期系统时钟LCD采样。LCD时钟采样不是独立像素数，触控/计数/ADC事件加速边界沿用各bench的明确审计。231条厂商原语vopt-2697时序检查提示仅按已有精确白名单接受，无其他仿真警告或错误。33项PC按完整同源输入/工具/日志哈希复用。

最终`tools/check_dynamics_result.py`已PASS，认证`gowin/neo_guitar_touch_game/dynamics_tuning_verification.json`严格绑定两个常数例外、新增冻结参考、全部当前输入/工具/日志/实际VG/P&R/STA和位流。构建仅在用户原`.gprj`与原`impl`进行，受保护配置与方案文件的内容/暂存对象不变。综合PID12236、P&R PID31412和全部仿真均已结束；禁止重复启动已通过的完整构建或测试。

## 完整实现结果

同一VG接续原工程P&R PID31412于2026-10-19 13:00:52结束，STA审查PASS；保持CST/SDC/路由选项不变。以下统一采用完整物理实现报告，不能以综合BSRAM108代替物理值113。

| 项目 | 保存的力度版 | 本次 | 变化 |
| --- | ---: | ---: | ---: |
| Logic / 59904 | 50570 | 50570 | 0 |
| Register / 60780 | 20146 | 20139 | -7 |
| CLS / 29952 | 28316（94.538%） | 28479（95.082%） | +163 |
| BSRAM / 118 | 113 | 113 | 0 |
| DSP / 118 | 115.5 | 115.5 | 0 |
| 系统Fmax / MHz | 50.089 | 50.043 | -0.046 |
| 音频Fmax / MHz | 13.638 | 13.619 | -0.019 |

运行仍为50/12.288MHz，未布通、setup、hold、latch及已测deadline违例均为0；两条既有PR1014通用时钟提示保留，STA已计入实际布线。旧余量目标中CLS≤95%和系统≥55MHz未达到，音频≥13.5MHz达到。物理打包/布线结果有变动，不能用寄存器减少宣称整机资源改善。本批是误触和响度修正，不宣称旧P1余量目标全部完成。

新原工程FS SHA256为`e97afee45346aad123a1ec525a2ddc0b344348898348eaf518fd7d9d7b0c4213`，对应新完整证据归档`build/releases/touch_game/p4_dynamics_tuning_20261019/`，以`archive.json`核对每个文件。旧210877be...和更早34f8a86e...的固定完整归档及标签保留，旧认证只适用于各自归档内部FS。

## 实物比较

全部数字门槛通过后，按既有明确授权覆盖同名`build/releases/touch_game/neo_guitar_touch_game_p4_posture.fs`，内容与原`gowin/neo_guitar_touch_game/impl/pnr/neo_guitar_touch_game.fs`相同。用Programmer直接选择新FS即可，无需重新综合布线。

1. 先不拨第一弦，分别对其他三弦轻/重各拨20次，检查第一弦误触次数；再测试跨弦和四弦同时起音。
2. 对第一弦轻拨20次，观察提高门槛后是否漏音；再逐弦试轻/中/重/最重，比较最低档与其余三档的层次。
3. 三音色分别检查，再开五度/合唱/延音/混响；核对游戏命中和MPU待命/手动切音色。实际声压、串弦概率与长期稳定性尚无新测量。

本批交付后等待用户试板，不推送、代理烧录或打开COM，不自动继续新功能。
