Keyi-1/xinxian-fpga-guitar/verification/docs/P4_POSTURE_TIMBRE_BRINGUP.md

# MPU-6050 姿态切音色与《情歌》节奏修订

2026-10-19发布边界：当前原工程和同名`neo_guitar_touch_game_p4_posture.fs`已更新为[第三弦与四等分力度版](QUARTER_DYNAMICS.md)，以`quarter_dynamics_verification.json`和新位流哈希为准。本文接线、姿态操作和已确认节奏继续适用；下文A2资源/哈希/认证为保存的历史P4快照，只对应`build/releases/touch_game/p4_posture_20261018/`内部旧FS。

2026-10-18：用户已确认当前P3总体可用，并授权先推送保存、再做本批修改。P3提交 `7837a24` 已推送 `origin/master`；本批修改已在本地通过数字验证，不自动推送或代理烧录。旧P3位流/认证完整保留，新源码使用独立P4认证。

## 《情歌》第10、18小节

用户确认的四拍为 `1_11|(1)5_3|(3)___|345`；每个竖线分隔一拍，括号延续前音，不另拨弦，最后345均分一拍。

| 起音（拍，从0开始） | 音 | 持续拍数 |
| --- | --- | --- |
| 0 | 高1 | 1/2 |
| 1/2 | 高1 | 1/4 |
| 3/4 | 高1 | 1/2，连到第二拍 |
| 5/4 | 5 | 1/2 |
| 7/4 | 3 | 5/4，连到第三拍结束 |
| 3、10/3、11/3 | 3、4、5 | 各1/3 |

60BPM电脑参考音在 `build/qing_ge_rhythm_review/preview_v1/`：`corrected_bar10_twice_counted.wav` 为四拍预备后两遍修订小节；`old_then_corrected_counted.wav` 先旧后新；`corrected_bars9_11_clean.wav` 带上下文、不加节拍器。它们为软件近似拨弦音，仅核对节奏，不是板上PCM或音色等价证据。用户已试听确认“节奏正确，采用这版修改正式曲谱”。

正式CSV/BIN、逻辑ROM和两套BSRAM初值已同步。独立逐事件测试证明只有四条事件的时间变化，音高、原分弦、力度、group及其余事件保持；全曲仍38小节/212起音/152秒/60BPM/第二音色。旧试行补拍和原图读谱在源JSON中保留，新的授权明确覆盖旧修订。

如需用既有UART工具再次导入同一曲目，使用新样例`build/p4_posture/upload_example/qing_ge.bin`及同名`.json`，CRC32为`c3451bbc`，BIN与新生产曲谱逐字节相同。P3归档中的旧样例保持原样，不能用它恢复新节奏。PC上传环境及实际COM选择仍按[P3说明](P3_WRITABLE_SONG_IMPORT.md)，本批未打开串口。

## 杜邦线接法

用户实物为GY-521/MPU-6050，尚未固定琴身。使用独立GPIO总线，不与原生J6触控共享，不改原ADC/矩阵/I2S接线。

| MPU模块信号 | NEO Dock 31005 | FPGA/用途 |
| --- | --- | --- |
| VCC | J8-1（3V3） | 模块电源，先核对实物供电 |
| GND | J8-3 | 共地 |
| SCL | J8-11 | Y21，Bank8，开漏GPIO |
| SDA | J8-12 | Y22，Bank8，开漏GPIO |
| AD0（用户写ADO） | 接模块GND | 地址0x68 |
| XDA、XCL、INT | 留空 | 本版轮询数据就绪，不使用辅助总线/中断脚 |

J8-2同为3V3、J8-4同为GND，但上表只指定一套接点。按板上排针编号连接，不按图片左右方向猜位置；J8-5～8继续留给ADC，J13矩阵、J9 I2S、J6触控和LCD跳帽保持。SCL/SDA只驱动0或高阻。

核对依据为官方31005原理图第19页（J8电源及PMOD1_IO0/1），两版60K核心板Bank8/Y21/Y22和BTB连接，以及官方60K约束；原PDF/哈希在 `build/p3_import/board_evidence/`，本批页图在 `build/p4_posture/board_evidence/`。链接：[31005原理图](https://dl.sipeed.com/fileList/TANG/Mega_138K_60K/02_Schematic/DOCK/Tang_Mega_NEO_Dock-138K_31005_Schematics.pdf)。

用户所说3V3尚不是供电实测记录。断电接线；先只接模块VCC/GND，确认稳压后芯片供电和SDA/SCL上拉电平兼容，再接信号。不同GY-521稳压器/上拉可能不同；不能为了修复不通信直接改接5V。原保护方案中的供电/上拉检查继续适用。

## 首版交互和安装

上电默认MANUAL、钢琴，未校准和传感器离线不自动切换。主页底部左侧`CALIBRATE`、中间`AUTO OFF/ON`、右侧健康/姿态；演奏页右下角显示`MANUAL/AUTO/WAIT TAIL`等状态。原游戏页面和触控职责保持。

1. 默认轴向为模块+X指向琴颈、+Z指向琴面正面；+Y完成右手坐标系。先临时固定或用手保持与琴身一致的方向，避免杜邦线拉动。需要换轴/反号时修改显式参数并重新验证，不靠零偏校准掩盖轴向错误。
2. 将琴面+Z朝上水平静置，点击`CALIBRATE`。收集256个连续静止有效包，约2.56秒；移动、跳变、失联或断包会重新计数。陀螺仪均值去零偏，加速度Z保留8192LSB的重力。校准后另等至少1秒健康数据。
3. 出现FLAT/GUITAR/UPRIGHT/READY等状态后，点击`AUTO ON`，再进入演奏模式。
4. 新确认的平放姿态选择钢琴；斜抱选择明亮弦音。原音色键继续按钢琴→明亮→哇音循环，处于同一姿态时手动选择保持。
5. 自动目标等待全部声部自然结束、无待处理起音，且至少两个采样边界确认流水线排空。持续延音可以长期`WAIT TAIL`；不缩包络、不强制截音。手动按键取消待命目标，模式退出使用原停止流程。
6. 竖抱仅报告UPRIGHT，琵琶未实现，因此不改变为假冒的第四音色。游戏默认不受AUTO影响，仍使用曲目推荐和原手动键；菜单只监测。
7. 失联保留当前音色和声音，手动键继续有效。恢复后重新等待健康数据，同一姿态不重发默认音色。复位/重新配置需重新校准和启用AUTO。

这是方案中的“等待音源空闲”的验证版。逐声部起音音色锁存、混合音色尾声隔离、琵琶、蓝牙和断电保存均不在本批。

## 数字验证进度

独立驱动覆盖一字节指针、复位/ID、10项配置写入和逐项回读、14字节大端有符号包、未就绪、NAK、坏ID/配置、过期、时钟卡死和恢复。共享I2C主机的默认两字节路径保留并回归GT911。

姿态运算复用36位移位加法单元，6次平方及3次阈值乘积，无新增DSP乘法表达式；1024个全宽乘积、生产256点校准、重力保留、滤波、三姿态/回差、运动/倒置/饱和、重复包、断包和恢复均测试。分类最慢352个系统时钟，低于1000时钟预算。稳定确认500ms、自动事件间隔1秒；这些是初始阈值，尚需实物姿态数据校准。

实际生产RTL顶层已用真实MPU I2C引脚模型打通：触控校准/AUTO、实际音色键、当前音色枚举、旧音待命/手动取消、退出/重入和传感器故障恢复；2853音频样本、347读取包、两次实际自动切换。触控/ADC注册事件和毫秒计时为明确加速刺激边界，音频时钟和采样方程保持。两次失败测试发现“正常PCM valid反复清除quiet计数”，修订为采样边界排空并加入专门回归，原失败证据保留。

20项既有RTL、4项P3存储/UART/整机/冻结显示、33项Python/生成器已经通过。新增可选端口仅补常量/空连接，逐字反向审计后保留前序PASS日志续跑，没有删除断言或放宽警告。

用户提出底部文字偏左后，改按可见字符数居中，补齐右侧状态底框；触控范围不动。`sim/temp/p4_centered_display_01/`对照冻结P3的12场景、1,566,720有效像素，除主页底部三个框与演奏页右下状态外完全一致，帧中状态变化不撕裂，仍六时钟/像素。实际RTL图片在`build/p4_posture/rtl_previews_centered/`。旧像素证据留存，只按精确有限渲染修改复用不受影响的功能回归。

A1综合已通过，但在布线时收到上述UI修改，故保留证据并主动停止，没有把A1当作最终交付。A2在同一原工程/impl中完成综合、完整P&R/STA，运行时源码提交`be88562`，目录`build/p4_posture/impl_a2_centered/`。Gowin PID18208自22:03:12启动，23:14:16完成；没有重复启动其他完整构建。严格最终校验PASS，新认证为`gowin/neo_guitar_touch_game/p4_posture_verification.json`，旧P3认证/归档保持。

历史A2位流保存于`build/releases/touch_game/p4_posture_20261018/evidence/gowin/neo_guitar_touch_game/impl/pnr/neo_guitar_touch_game.fs`，完整证据仍在该固定归档。旧位流SHA256为`34f8a86e942e291453159655c654fc72e5424167686cb2200dd659d4daf7229c`；旧实际VG SHA256为`27ef25ca8683cc1881a74d9ce5eeeb9c26949c2ad93f428bd22649d0509507ee`。这些结果只绑定A2快照，不认证后来更新的原impl或同名发布文件。

| 完整实现，同器件/原工程口径 | 已验收P3 | 当前P4 A2 | 变化 |
| --- | ---: | ---: | ---: |
| Logic /59904 | 45324 | 50580 | +5256 |
| Register /60780 | 18449 | 20090 | +1641 |
| CLS /29952 | 26860（89.68%） | 28585（95.44%） | +1725 |
| 物理BSRAM /118 | 113 | 113 | 0 |
| DSP /118 | 115.5 | 115.5 | 0 |
| 系统Fmax MHz，运行50 | 50.158 | 50.020 | -0.138 |
| 音频Fmax MHz，运行12.288 | 13.068 | 13.858 | +0.790 |

所有资源合法，setup/hold/latch/未布通及已测deadline均0。新姿态模块综合无DSP，物理DSP/BSRAM与P3相同。两个原有PR1014通用时钟布线提示仍在，STA计入实际布线；没有更改SDC、时钟、路由配置、音色参数或降低音频规格。系统50.020MHz余量较小；CLS≤95%、系统≥55MHz的旧余量目标未达，音频≥13.5MHz已达，不能宣称旧P1余量目标全部完成。本批交付后先实测，不自动继续叠加功能。

当前A2实际完整综合网表的姿态整机对照已PASS：真实MPU开漏引脚、生产256包校准、实际245760时钟音色键去抖、AUTO/旧音等待/手动取消/退出重入/故障恢复，12,815音频样本、1,773次MPU读包、5次实际音色变化；LCD同步/RGB与参考RTL逐系统时钟相等，共11,226,240个有效期系统时钟采样（不是独立像素数）。只有经过原语Q/引脚审计的计数等待和注册触控/ADC事件被加速刺激，不强制ROM/DDS/音频结果。实际增益ROM全部128地址及模态状态RAM352读/384写也通过；384组曲库页/地址/数据/字节使能布尔连线审计通过。

同一实际VG的原UART/动态显示整机入口也PASS：真实115200十次事务（含重复/BUSY）、DPB写入和RAM读回CRC/原子提交、四声部G5/D3/E4/C5、13,397音频样本、16帧/5,875,200 LCD时钟采样，包含频谱与曲线渐暗。本入口保持生产I2C分频并对照未接传感器时的开漏输出，不使用姿态计时加速；只有注册触控事件和原有32位倒数计数Q刺激。旧版本数字日志不参与本次VG认证。

归档审计发现旧45210样本组件记录没有单独记录音色ROM哈希，因此仅补跑音源/状态RAM两项组件以补齐当前全部ROM、系数、原数组参考及源码的完整输入哈希：`p4_audio_dependency_closure_01`通过，仍45,210样本/全部模态使用值和352读/384写。已完成的20项/整机/网表测试不重跑；没有以忽略资产哈希的方式获得PASS。

实物尚待：模块电源/上拉、轴向、三姿态各20次、阈值边界60秒、拨弦5分钟、摇晃/倒置/拔线恢复、无截尾/误起音、原游戏/UART/两路音频和长期稳定性。没有代理烧录、实物COM通信或本批定量声学结果。
