Keyi-1/xinxian-fpga-guitar/verification/docs/QUARTER_DYNAMICS.md

# 第三弦灵敏度与25/50/75/100%力度档

2026-10-19：用户要求第三根弦最低触发阈值略降、第二和第三档数字增益调整为50%/75%。已保存旧版标签`snapshot/p4-before-quarter-gains-20261019`（d0b57a4）及固定归档`build/releases/touch_game/p4_dynamics_tuning_20261019/`，旧FS SHA256为`e97afee45346aad123a1ec525a2ddc0b344348898348eaf518fd7d9d7b0c4213`。不覆盖旧固定归档。

| 参数 | 保存版 | 本次 |
| --- | ---: | ---: |
| 第三弦G3 / CH2触发偏差 | 80 | 60 |
| 第一弦CH0触发偏差 | 220 | 保持220 |
| 第二/第四弦CH1/CH3触发偏差 | 100 / 100 | 保持 |
| 档0 / 1 / 2 / 3增益Q8 | 64 / 160 / 208 / 256 | 64 / 128 / 192 / 256 |
| 相对满档数字振幅 | 25 / 62.5 / 81.25 / 100% | 25 / 50 / 75 / 100% |

这是实际拨弦力度功能上的参数调整，已有版本已按真实ADC峰值分四档，不是本次才启用音量随力度变化。每次首次过门槛及随后32个该通道样本取绝对偏差峰值，窗口末尾同时提交起音和力度；一次起音确定档位，余音继续原包络衰减。第三弦60是根据用户要求选择的初次试板值，未声称经过新测量；其最低档峰值范围60～149，分档边界150/280/400不变。其余三弦力度边界、基准2053、回落20、死区400、稳定80均保持。

增益作用于四弦全部三音色；不改变主音量、音色模型/模态/击弦/包络/音效/采样率/位宽或接线。试听继续固定编码2，其实际数字增益随本次档2改为75%，原为81.25%。数字振幅比例不等于人耳响度或绝对声压。

## 源码和验证范围

生产源码`152a764`相对d0b57a4只有两个文件的三个常数变化：CH2触发80→60、档1增益160→128、档2增益208→192。原工程/原impl构建，不另建工程。两个受保护用户文件内容和暂存对象保持。旧参考、旧认证和旧构建日志不认证本次产物。

- `quarters_detector_01`五项PASS：16384组通道/ADC码、132峰值位置、捕获/重触发/复位、真实SPI四弦×四档。140组第一弦抑制用例仍通过；新增第三弦正负60～79共40组轻拨，仅新60门槛接受，其他三弦事件/力度/捕获逐周期相同；59不触发、60包含且等满32后续样本才提交。
- `quarters_audio_01`四项PASS：独立冻结上版音源48456样本，三音色×三频段×四档；档0/3的5796样本完全相同，档1/2的42660样本分别满足128/160和192/208缩放及整数舍入界，模态源/包络/调度保持，deadline为0。另真实ADC→三音色×四档每档1024样本，逐PCM/PT8211/I²S及实际增益检查、能量递增、单声部干声无硬顶；全部音效/四声部、姿态策略及真实MPU整机2853样本通过。
- `quarters_legacy_01`四项PASS：8192样本/2097153时钟演奏链、P2判定、9032样本扩展音域/双数字口、实际按键，延音退出仍1452样本。冻结演奏链回归只允许在原655458f参考内累计应用已授权的112/160/208→64/128/192三个增益常数；最大256和其余参考代码不变。不能将改过增益的档0/1/2称为与未改旧PCM完全一致。

综合PID23460已结束并审查PASS：Logic50053=LUT39553+ALU10500、Register20139、逻辑BSRAM108，DSP原语计数与保存版相同；最终以完整实现物理值为准。当前VG SHA256 `543d2db4977ee1b141c179ac17ebb4d948d40fbf13fd6d82f441580547d72107`。实际曲库384组布尔连线与四声部128组速度DSP操作数/原流水线参数审计PASS，实证两种模式下全部四档为64/128/192/256，而非只检查试听固定档2。
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
