Keyi-1/xinxian-fpga-guitar/verification/scores/p2/source/qing_ge_user_page_2.jpg

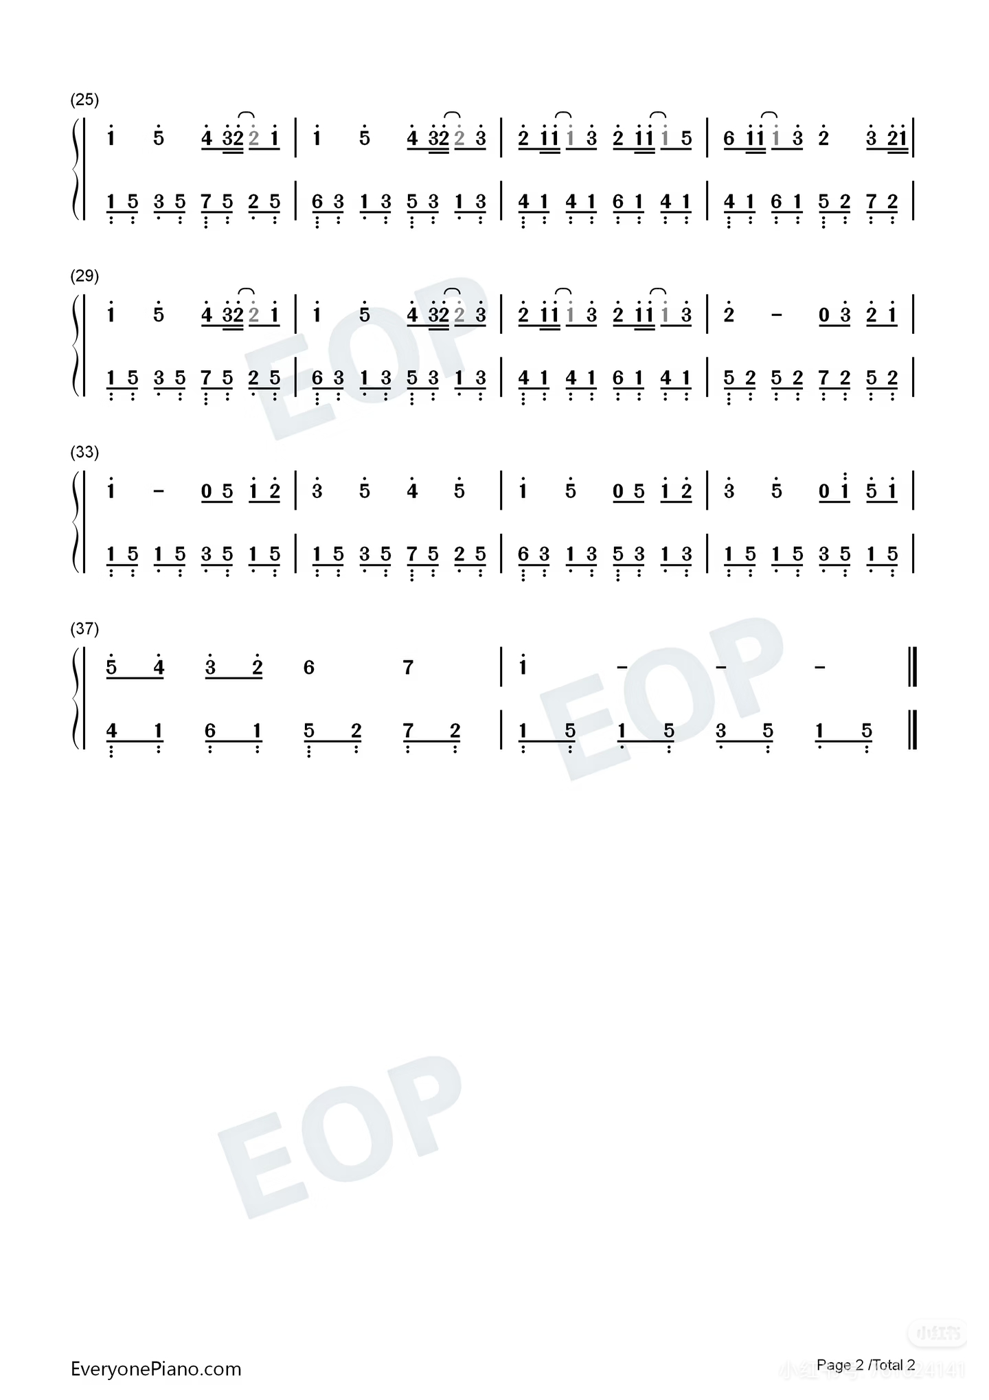
verification/scores/p2/source/qing_ge_user_page_2.jpg
