Keyi-1/xinxian-fpga-guitar/(list of files, drawings)

Other design files:
verification/misc/ProPrj_guitar_2026-09-09.epro
