Keyi-1/xinxian-fpga-guitar/verification/mobile/p5-import/pnpm-lock.yaml

lockfileVersion: '9.0'

settings:
  autoInstallPeers: true
  excludeLinksFromLockfile: false

importers:

  .:
    dependencies:
      expo:
        specifier: 58.0.14
        version: 58.0.14(@babel/core@7.29.7(supports-color@8.1.1))(@expo/dom-webview@58.0.2)(react-native@0.88.0(@babel/core@7.29.7(supports-color@8.1.1))(react@19.3.0)(supports-color@8.1.1))(react@19.3.0)(supports-color@8.1.1)
      expo-crypto:
        specifier: 58.0.7
        version: 58.0.7(expo@58.0.14)
      expo-dev-client:
        specifier: 58.0.14
        version: 58.0.14(expo@58.0.14)(react-native@0.88.0(@babel/core@7.29.7(supports-color@8.1.1))(react@19.3.0)(supports-color@8.1.1))
      expo-document-picker:
        specifier: 58.0.4
        version: 58.0.4(expo@58.0.14)
      expo-file-system:
        specifier: 58.0.9
        version: 58.0.9(expo@58.0.14)(react-native@0.88.0(@babel/core@7.29.7(supports-color@8.1.1))(react@19.3.0)(supports-color@8.1.1))
      react:
        specifier: 19.3.0
        version: 19.3.0
      react-native:
        specifier: 0.88.0
        version: 0.88.0(@babel/core@7.29.7(supports-color@8.1.1))(react@19.3.0)(supports-color@8.1.1)
      react-native-ble-plx:
        specifier: 3.5.1
        version: 3.5.1(react-native@0.88.0(@babel/core@7.29.7(supports-color@8.1.1))(react@19.3.0)(supports-color@8.1.1))(react@19.3.0)

packages:

  2g@1.0.1:
    resolution: {integrity: sha512-+uViadKOS/wwR4pFu5g8TPn3QHpKqoX19JHCnp8k/3cLpImdcXozwvZA6Q/5PeW3AcU8neL8faaMidBcv7o8CA==}
    hasBin: true
    peerDependencies:
      typescript: '>=5.8.0'
    peerDependenciesMeta:
      typescript:
        optional: true

  '@babel/code-frame@7.29.7':
    resolution: {integrity: sha512-Aup7aUOfpbAUg2ROOJN6Iw5f9DMBlzu0mIkm/malLQFN/YQgO48wCj0Kxa3sEHJvPVFg7siR+qRInwXd2qhQKw==}
    engines: {node: '>=6.9.0'}

  '@babel/compat-data@7.29.7':
    resolution: {integrity: sha512-locTkQyKvwIEgBzVrn8693ebc97F2U8ZHjbXwDXJ5Fn2TCpNwTlKcaKLkdHop5c/icOFE7qt7Q9JC5hnKNa6Gg==}
    engines: {node: '>=6.9.0'}

  '@babel/core@7.29.7':
    resolution: {integrity: sha512-RgHBCvtjbOK2gXSNBNIkNoEc9qoVEtau3hj8gEqKQuL3HZAibKarWFEI3Lfm6EYKkLalOh8eSrj9b+ch9H/VBA==}
    engines: {node: '>=6.9.0'}

  '@babel/generator@7.29.8':
    resolution: {integrity: sha512-gZbepsdh3WDtgZKWL+vTPh71LSBrm/Y4/QDZBVCcYfmeTEEuoOYwlSy+G1StfJg+/Zy550u/3TATbm7qDbbMtg==}
    engines: {node: '>=6.9.0'}

  '@babel/helper-annotate-as-pure@7.29.7':
    resolution: {integrity: sha512-OoK6239jHPuSQOoS0kfTVKn0b/rVTk0seKq4Gd2UMLtmOVLjDC0ki3e+c90Trqv2gMfvJFqkiljrr568+qddiw==}
    engines: {node: '>=6.9.0'}

  '@babel/helper-compilation-targets@7.29.7':
    resolution: {integrity: sha512-wem6WaBj4NaVYVdNhLPPVacES6ZJ+KBBfSkTMD3YZxbP3rm3Di85tJU5ljaUNhaOynt+Aj0xruhYuzQBt8n71g==}
    engines: {node: '>=6.9.0'}

  '@babel/helper-create-class-features-plugin@7.29.7':
    resolution: {integrity: sha512-IY3ZD9Tmooqr3TUhc3DUWxiuo8xx1DWLhd5M7hQ+ZWJamqM2BbalrBJb2MisSLoYorOj75U03qULCxQTY9r3hg==}
    engines: {node: '>=6.9.0'}
    peerDependencies:
      '@babel/core': ^7.0.0

  '@babel/helper-create-regexp-features-plugin@7.29.10':
    resolution: {integrity: sha512-/YY9soQuWa8TURtHXHT+GbklpbAA+dZErxFGHIr6qgDg96xuGWrTAs1+MfjgVJPF0YLQsOVsOYs8lhgsPbOinQ==}
    engines: {node: '>=6.9.0'}
    peerDependencies:
      '@babel/core': ^7.0.0

  '@babel/helper-define-polyfill-provider@0.6.8':
    resolution: {integrity: sha512-47UwBLPpQi1NoWzLuHNjRoHlYXMwIJoBf7MFou6viC/sIHWYygpvr0B6IAyh5sBdA2nr2LPIRww8lfaUVQINBA==}
    peerDependencies:
      '@babel/core': ^7.4.0 || ^8.0.0-0 <8.0.0

  '@babel/helper-globals@7.29.7':
    resolution: {integrity: sha512-3nQVUAtvkKH9zahfWgw96Jc/uFOmjACE1kQz82E2lqWmHBgjzbNlsC22nuQTfahmWeQtTq5nQ/4Nnd2A1wj4zA==}
    engines: {node: '>=6.9.0'}

  '@babel/helper-member-expression-to-functions@7.29.7':
    resolution: {integrity: sha512-j+7JYmk1JYDtACIGj0QJqqWZjoUpMoEikQGADMaHgCMCSDqd2+P32rfcibUNrGOMWrlzK1WJBdxrB3JJQZwWtg==}
    engines: {node: '>=6.9.0'}

  '@babel/helper-module-imports@7.29.7':
    resolution: {integrity: sha512-ejHwrQQYcm9xnTivShn2IDOlIzInN34AXskvq9QicvCtEzq1Vzclu/tKF8Jq1Cg8JG2GL6/EmjgsCT7lXepE3g==}
    engines: {node: '>=6.9.0'}

  '@babel/helper-module-transforms@7.29.7':
    resolution: {integrity: sha512-UPUVSyXbOh627KiCIGQSgwWzGeBKLkaJ9PJEdrngIwMSzxLR4jS4+f1f1jb7VzBbg8nFLaYotvVPFCTqdrmTAg==}
    engines: {node: '>=6.9.0'}
    peerDependencies:
      '@babel/core': ^7.0.0

  '@babel/helper-optimise-call-expression@7.29.7':
    resolution: {integrity: sha512-+kmGVjcT9RGYzoDwdwEqEvGgKe3BYq+O1iGzjFubaNgZHwYHP6lsF2Yghf4kEuv9BV7tYDZ913aBW9am6YKong==}
    engines: {node: '>=6.9.0'}

  '@babel/helper-plugin-utils@7.29.7':
    resolution: {integrity: sha512-G7sHYigPY17oO5SYWnfD/0MTBwVR781S/JI643e/JhUYgVgWE/61SoW3NH9KWUKyKq5LVh3npif99Wkt6j86Jw==}
    engines: {node: '>=6.9.0'}

  '@babel/helper-remap-async-to-generator@7.29.7':
    resolution: {integrity: sha512-16AMiW26DbXWBbr3B8wNozKM0ydMLB892vaOaJW/fPJdnT8vJk5sdkQcU/isqUxyCE0cEoa8wZOcbgDuC4b6Og==}
    engines: {node: '>=6.9.0'}
    peerDependencies:
      '@babel/core': ^7.0.0

  '@babel/helper-replace-supers@7.29.7':
    resolution: {integrity: sha512-atfGXWSeCiF4DnKZIfmJfQRkSw9b9gNNXR1kqKjbhG4pGYCOnkp8OcTB8E3NXjBu8NpheSnOeNKz8KT7UNFTmQ==}
    engines: {node: '>=6.9.0'}
    peerDependencies:
      '@babel/core': ^7.0.0

  '@babel/helper-skip-transparent-expression-wrappers@7.29.7':
    resolution: {integrity: sha512-brcMGQaVzIeUb+6/bs1Av0f8YuNNjKY2JyvfRCsFuFsdKccEQ5Ges2y74D74NZ1Rz8lKJ9ksJkfqwQFJ/iNEyQ==}
    engines: {node: '>=6.9.0'}

  '@babel/helper-string-parser@7.29.7':
    resolution: {integrity: sha512-Pb5ijPrZ89GDH8223L4UP8i6QApWxs04RbPQJTeWDV0/keR2E36MeKnyr6LYmUUvqRRI+Iv87SuF1W6ErINzYw==}
    engines: {node: '>=6.9.0'}

  '@babel/helper-validator-identifier@7.29.7':
    resolution: {integrity: sha512-qehxGkRj55h/ff8EMaJ+cYhyaKlHIxqYDn682wQD7RNp9UujOQsHog2uS0r2vzr4pW+sXf90NeeayjcNaX3fFg==}
    engines: {node: '>=6.9.0'}

  '@babel/helper-validator-option@7.29.7':
    resolution: {integrity: sha512-N9ZErrD+yW5geCDtBqnOoxmR8+tNKiGuxKlDpuJxfsqpa2dFcexaziGAE/qoHLiDDreVNMupxGmSoNlyvsA3gw==}
    engines: {node: '>=6.9.0'}

  '@babel/helper-wrap-function@7.29.7':
    resolution: {integrity: sha512-iES0Skag9ERIF68aXadpO6dbXa03mNWK3sEqJaMnLNs/eC3l0lkImdfoy6Y09/SfkpawdAB4RjQ7PVA7TcVGdw==}
    engines: {node: '>=6.9.0'}

  '@babel/helpers@7.29.10':
    resolution: {integrity: sha512-EMCx3AGZ3WfAl6ht7AyQoPm2Lh+BGYEMdc4Q6Hf7uSCDOZFuLq44qNwL+iaim8VlyYhRAo4X43+weadK8ZB4Yg==}
    engines: {node: '>=6.9.0'}

  '@babel/parser@7.29.9':
    resolution: {integrity: sha512-CjXrNHTnvqBVqHgdBysY3vk2T8tpJHb5/RMeHJBTyVa9xgugCB0CJTx/3oO8RV2QRQP391RWpB7D6hLjm8V9uA==}
    engines: {node: '>=6.0.0'}
    hasBin: true

  '@babel/plugin-proposal-decorators@7.29.7':
    resolution: {integrity: sha512-EtU0Hi3GvrTqD56xKmZvV/uCXK2ZbwVNPNLAquVItcAZpUhkXwWlo3Fmj0c2LxgSf2I8IDULeAepwNP1OefLXg==}
    engines: {node: '>=6.9.0'}
    peerDependencies:
      '@babel/core': ^7.0.0-0

  '@babel/plugin-proposal-export-default-from@7.29.7':
    resolution: {integrity: sha512-p+G5BNXDcy3bOXplhY4HybQ1GxH3i2Tppmdm/3epyRu2VgJJZuUlZ61MqRTg582Q7ZLBdP7fePYvsumSEkMxcQ==}
    engines: {node: '>=6.9.0'}
    peerDependencies:
      '@babel/core': ^7.0.0-0

  '@babel/plugin-syntax-decorators@7.29.7':
    resolution: {integrity: sha512-9MTTLbF39X6sqM92JPEsoI7++26hjZvzkxKZy64aMhWLH2mPkJ/Q3AV4QLmls3R14FpSpkOwQQfUh962JGQxxg==}
    engines: {node: '>=6.9.0'}
    peerDependencies:
      '@babel/core': ^7.0.0-0

  '@babel/plugin-syntax-dynamic-import@7.8.3':
    resolution: {integrity: sha512-5gdGbFon+PszYzqs83S3E5mpi7/y/8M9eC90MRTZfduQOYW76ig6SOSPNe41IG5LoP3FGBn2N0RjVDSQiS94kQ==}
    peerDependencies:
      '@babel/core': ^7.0.0-0

  '@babel/plugin-syntax-export-default-from@7.29.7':
    resolution: {integrity: sha512-foag0BB37ROhdeIX9O8G0jX7hw0UekJc04cHMrYLOnrErsnBKqJGHJ8eDRpoCFZBvEPPygmmtw4qyU97qa4oOw==}
    engines: {node: '>=6.9.0'}
    peerDependencies:
      '@babel/core': ^7.0.0-0

  '@babel/plugin-syntax-flow@7.29.7':
    resolution: {integrity: sha512-ajMX6QPcyomotqwpzhkYGxcK2i/us0rs1Qo9QvUpa+Fca0FTmqrzKrctoIYLMxcOhGZldGT/BAVkRGTWBiR8gQ==}
    engines: {node: '>=6.9.0'}
    peerDependencies:
      '@babel/core': ^7.0.0-0

  '@babel/plugin-syntax-jsx@7.29.7':
    resolution: {integrity: sha512-TSu8+mHCoEaaCDEZ0I3+6mvTBYR4PCxQwf2z9/r5Tbztv6NaLR3B9thGTTxX2WGuGHJqRiAbKPeGTJ5XWXVg6A==}
    engines: {node: '>=6.9.0'}
    peerDependencies:
      '@babel/core': ^7.0.0-0

  '@babel/plugin-syntax-nullish-coalescing-operator@7.8.3':
    resolution: {integrity: sha512-aSff4zPII1u2QD7y+F8oDsz19ew4IGEJg9SVW+bqwpwtfFleiQDMdzA/R+UlWDzfnHFCxxleFT0PMIrR36XLNQ==}
    peerDependencies:
      '@babel/core': ^7.0.0-0

  '@babel/plugin-syntax-optional-chaining@7.8.3':
    resolution: {integrity: sha512-KoK9ErH1MBlCPxV0VANkXW2/dw4vlbGDrFgz8bmUsBGYkFRcbRwMh6cIJubdPrkxRwuGdtCk0v/wPTKbQgBjkg==}
    peerDependencies:
      '@babel/core': ^7.0.0-0

  '@babel/plugin-syntax-typescript@7.29.7':
    resolution: {integrity: sha512-ngr+82Sh0xMz25TPCZi+nC2iTzjfCdWS2ONXTp/PtSCHCgaCNBpdMqgvJ2ccdLlClVZ7sisIgB914j/JFe+RZA==}
    engines: {node: '>=6.9.0'}
    peerDependencies:
      '@babel/core': ^7.0.0-0

  '@babel/plugin-transform-async-generator-functions@7.29.7':
    resolution: {integrity: sha512-d98gXZkgswvkyohMBABkhm3GeXhYj8psWfwQ2C7gtfrKGTykQa/iOIi+JJhwMjPlZ6Vm2XN+DCf3Es1EoG4ZLA==}
    engines: {node: '>=6.9.0'}
    peerDependencies:
      '@babel/core': ^7.0.0-0

  '@babel/plugin-transform-async-to-generator@7.29.7':
    resolution: {integrity: sha512-pcUb2SS+RMo9TWVBwKGI5ShtoG7R+zBsFmCKDa6fe8c+hPr3XJlZgoE5j6i8W7gDjhyvy+85vmYexanvXh3d1w==}
    engines: {node: '>=6.9.0'}
    peerDependencies:
      '@babel/core': ^7.0.0-0

  '@babel/plugin-transform-block-scoping@7.29.7':
    resolution: {integrity: sha512-ONyr4+AZhKh8yKWInVxU9AXA9EbsyeLcL6V0dJy6M2/62vuvpGm29zzuymbTpdc451GEpDIdAyPLP3r+P61yKQ==}
    engines: {node: '>=6.9.0'}
    peerDependencies:
      '@babel/core': ^7.0.0-0

  '@babel/plugin-transform-class-properties@7.29.7':
    resolution: {integrity: sha512-GtcpjFvanPfzNQi3eTitsCqtRRmmqzpy/A+yhTR1HaZo1Ly3EA8ZXxlPyHdR8/IuRMYc3E4wdGBewB2QKQjAaA==}
    engines: {node: '>=6.9.0'}
    peerDependencies:
      '@babel/core': ^7.0.0-0

  '@babel/plugin-transform-class-static-block@7.29.7':
    resolution: {integrity: sha512-kibJgmEdX2iMwsHY2tSZNDgj8PwIlCQz7FK9KuGKO8zsuoUwSEhoNnNVp/emKWrbY4HeO6kkXfdMqRKKKXBm2A==}
    engines: {node: '>=6.9.0'}
    peerDependencies:
      '@babel/core': ^7.12.0

  '@babel/plugin-transform-classes@7.29.7':
    resolution: {integrity: sha512-qV0OGGBVacduzQHE649JyCneOFI/maT+YKsO+K4Yi3xv2wTPNjM/W2o2gdzMwEAZz7fXNTHAe0NcSg30bIN69g==}
    engines: {node: '>=6.9.0'}
    peerDependencies:
      '@babel/core': ^7.0.0-0

  '@babel/plugin-transform-destructuring@7.29.7':
    resolution: {integrity: sha512-iPX8aD6H9zV5s7ZsqTdNocPN/MGQ5sSMnElKrktxjJRMnB2jN/1p2+R7GkfD6CAYoVFqy5A4XnSIUeGgJzIWpg==}
    engines: {node: '>=6.9.0'}
    peerDependencies:
      '@babel/core': ^7.0.0-0

  '@babel/plugin-transform-export-namespace-from@7.29.7':
    resolution: {integrity: sha512-24B2nOy2TeJSMheqwPD4DDQOV/elLSIlKxjZt4i05H5AgdPdWR3n18HnNrcJ+j76WJd9gbwb9jPjNYUy6RautA==}
    engines: {node: '>=6.9.0'}
    peerDependencies:
      '@babel/core': ^7.0.0-0

  '@babel/plugin-transform-flow-strip-types@7.29.7':
    resolution: {integrity: sha512-wRHeUjUjCZnMHmiO5bRgjFLcoEh7JyTdByOW11ahhwNa4V0bmeGEaIvt51yq0zQp2yWIpqfxXXPyUP6GFJZHOQ==}
    engines: {node: '>=6.9.0'}
    peerDependencies:
      '@babel/core': ^7.0.0-0

  '@babel/plugin-transform-for-of@7.29.7':
    resolution: {integrity: sha512-zeSIHh0+E1Um1WJRXCFlHQYu2ieJNdivLLjlBEp+dIBu3S51n+SZZmIXjxnItw6pz56Cn+KvK68BIBVsxq2JiQ==}
    engines: {node: '>=6.9.0'}
    peerDependencies:
      '@babel/core': ^7.0.0-0

  '@babel/plugin-transform-logical-assignment-operators@7.29.7':
    resolution: {integrity: sha512-A0H91hh6W8MFRkp5TqJmMr39jzGD1A1E1Ysiv2O06Sfbhkapm+XyIzxWCEh5kqwOZ1/8QZ0dY3SeQ7XBqfJd5Q==}
    engines: {node: '>=6.9.0'}
    peerDependencies:
      '@babel/core': ^7.0.0-0

  '@babel/plugin-transform-modules-commonjs@7.29.7':
    resolution: {integrity: sha512-j0vCldybPC5b5dwCQOJ21uKtHzt7hxLygJTg9eF1ScfaikEDNfzn94XoW5Fi+seBR0nCyL23xaBFFkq7dTM8XQ==}
    engines: {node: '>=6.9.0'}
    peerDependencies:
      '@babel/core': ^7.0.0-0

  '@babel/plugin-transform-named-capturing-groups-regex@7.29.7':
    resolution: {integrity: sha512-vuFoLwr4qnv2xbZ16SQd6uPcH5FNrLHhk/Jzo++0XJFcaDsr4gjJVg6j398oMHiC+83k/GiBzviwF5KBJkPUtQ==}
    engines: {node: '>=6.9.0'}
    peerDependencies:
      '@babel/core': ^7.0.0

  '@babel/plugin-transform-nullish-coalescing-operator@7.29.7':
    resolution: {integrity: sha512-idmp1dFaekP9GbcMvG24Kvw2BfhFZjHnNJCkV4WuIY4PskJzwI3f1N5OdgYke38T7rftO6ERulFRn2cFeZwRkg==}
    engines: {node: '>=6.9.0'}
    peerDependencies:
      '@babel/core': ^7.0.0-0

  '@babel/plugin-transform-object-rest-spread@7.29.7':
    resolution: {integrity: sha512-Ld98jn4c0smUywL57m7SgsHq3OpThOa6LqZJif3G6jYOovPleoFhVrBJ1WegRApSFB2wu4+RelAj9AC9G08Z4A==}
    engines: {node: '>=6.9.0'}
    peerDependencies:
      '@babel/core': ^7.0.0-0

  '@babel/plugin-transform-optional-catch-binding@7.29.7':
    resolution: {integrity: sha512-sLsyndxK2VwX6yNUOakMb7Sh553ZTe/vVM1XJ+9Z5aW1ytsc8xOIwmyk05NNjN60vkc5/KqoTH6hB4V41LJhng==}
    engines: {node: '>=6.9.0'}
    peerDependencies:
      '@babel/core': ^7.0.0-0

  '@babel/plugin-transform-optional-chaining@7.29.7':
    resolution: {integrity: sha512-6GM1dhvK3gNODkXcEcMCOLEDCLSoZ/sBbro2Ax8HURyasQ4NshagQixkRFdh5niI6E4gmA/jYI/4aT7rRos3ZQ==}
    engines: {node: '>=6.9.0'}
    peerDependencies:
      '@babel/core': ^7.0.0-0

  '@babel/plugin-transform-parameters@7.29.7':
    resolution: {integrity: sha512-ZDOBqV/qLYJI0YElr8DcENEyARsFQeESqWXH6gZlghYXuPPjvweuDhP4VyEi4BlUBlLRFZVjxoZDMjxhLW766g==}
    engines: {node: '>=6.9.0'}
    peerDependencies:
      '@babel/core': ^7.0.0-0

  '@babel/plugin-transform-private-methods@7.29.7':
    resolution: {integrity: sha512-/6Rz4DK1ETDEM/bWHsPHcaEe7ZaT1EqSXjtSP/L0DijOYuaUhiRiOKcwpZ8P7zR4xXEHc2ITdiCgBm9Tpyv9ug==}
    engines: {node: '>=6.9.0'}
    peerDependencies:
      '@babel/core': ^7.0.0-0

  '@babel/plugin-transform-private-property-in-object@7.29.7':
    resolution: {integrity: sha512-+BNo06dnrzdNNqCm1X6YUaVv0DKk8Q+JYcoZfOkLhYWNCXzlwTSRq8zGWayT1csjcpNXV9CQTBRRbmTLZac5cA==}
    engines: {node: '>=6.9.0'}
    peerDependencies:
      '@babel/core': ^7.0.0-0

  '@babel/plugin-transform-react-display-name@7.29.7':
    resolution: {integrity: sha512-+1wdDMGNb4UPeY3Q4L5yLiYe6TXPXubs4NjrgRFw13hPRLJfEMw2Q5OXkee6/IfdqePIeW4Jjwe3aBh7SdKz4Q==}
    engines: {node: '>=6.9.0'}
    peerDependencies:
      '@babel/core': ^7.0.0-0

  '@babel/plugin-transform-react-jsx-development@7.29.7':
    resolution: {integrity: sha512-Xfy3UVMF04+ypnFbkhvfqtmvwfe92qwQdbGZVonhE+6v35GzlofmOnA1szaZqzb9xYWr0nl1e5EMmzi0DNON1g==}
    engines: {node: '>=6.9.0'}
    peerDependencies:
      '@babel/core': ^7.0.0-0

  '@babel/plugin-transform-react-jsx@7.29.7':
    resolution: {integrity: sha512-WsZulLVBUHXVj2cUcPVx6UE21TpalB6bHbSFErKT0Ib++ax24jjXe73FqlWvdylFOjiuPHYi6VCcgRad1ItN+A==}
    engines: {node: '>=6.9.0'}
    peerDependencies:
      '@babel/core': ^7.0.0-0

  '@babel/plugin-transform-react-pure-annotations@7.29.7':
    resolution: {integrity: sha512-H5E+HBgDpr6Q5t+Aj11tL7XkIui1jhbIoArVQnqjgXo5/3YxkN7ZEBcWF4RQlB0T4rrxJQbXS6kiFV6B7XTqUA==}
    engines: {node: '>=6.9.0'}
    peerDependencies:
      '@babel/core': ^7.0.0-0

  '@babel/plugin-transform-runtime@7.29.7':
    resolution: {integrity: sha512-xmAscdE/AsqRW7vutbPNoUmu/nF5SrLKPs7aoJgEjo35lLKA/Bc0i2rMv/hr1+Y0o1bQCiVtith3u2vdgRL39Q==}
    engines: {node: '>=6.9.0'}
    peerDependencies:
      '@babel/core': ^7.0.0-0

  '@babel/plugin-transform-typescript@7.29.9':
    resolution: {integrity: sha512-FFwIwzU+7SCOuxxV4YtJql6T9981ZVTm+FHO5GhVsRqCTdy0WwrEZh3l42ARpXruJUDGOptdduHW6Zr7pNPLNg==}
    engines: {node: '>=6.9.0'}
    peerDependencies:
      '@babel/core': ^7.0.0-0

  '@babel/plugin-transform-unicode-regex@7.29.7':
    resolution: {integrity: sha512-7D/x/23/d/3VqZ0QA+LGbZMlGwZjztBygSWWWsfTPoQ1oQ6Q1P6Mr3d0kk42XabyUVw+fha3LqdRsFqeKqvCyA==}
    engines: {node: '>=6.9.0'}
    peerDependencies:
      '@babel/core': ^7.0.0-0

  '@babel/preset-typescript@7.29.7':
    resolution: {integrity: sha512-/Foi8vKY2EVbed/1eZx0gJEEwHAIxogrySI7rULcRIvhZzbvoE/b5qG5Ghc0WKAFKOHA9SD1x7RsFlOYdutIiQ==}
    engines: {node: '>=6.9.0'}
    peerDependencies:
      '@babel/core': ^7.0.0-0

  '@babel/runtime@7.29.10':
    resolution: {integrity: sha512-NpugTzbKgGrNe45Ui32cN8vCFFMxVtP/9rtfwv0nP5FRDAjvYBxJcLVpYA9mr1jxP6cnIT7x9LUzuDTbWYYNRA==}
    engines: {node: '>=6.9.0'}

  '@babel/template@7.29.7':
    resolution: {integrity: sha512-puq+Gf35oI24FeN11LkoUQFqv9uwNeWpxXZi/Ji3rRIoKAzKnxRaZ+Gkj0vKS9ZCiTESfng1N9LyOyXvo+m+Gg==}
    engines: {node: '>=6.9.0'}

  '@babel/traverse@7.29.10':
    resolution: {integrity: sha512-B3lYAs2nkKskbgQ1nfy8Ma9ao9Q1rntTAQHrzzyDuj+TSO+X3le6PfWwqDvodsb+OumE10eMFfuMCTQSQ5iuIQ==}
    engines: {node: '>=6.9.0'}

  '@babel/types@7.29.8':
    resolution: {integrity: sha512-Vj1jF3cPfxg7OAfoI7QnVKLoILlm2JF9pnVHrX8qx7AHMiYWT+NDAA7jChlNgRS4WTLc/fD1lXLmPixluj+3Gg==}
    engines: {node: '>=6.9.0'}

  '@expo/cli@58.1.11':
    resolution: {integrity: sha512-wkFTSLXXYqLkRT5oy4DnLuTOtbFIu3qTiXHSHkFSqUBTHiE92y3bOIwM3UN7Y1ys18qVJge8lXjezaEfsHmijQ==}
    hasBin: true
    peerDependencies:
      expo: '*'
      expo-router: '*'
      react-native: '*'
    peerDependenciesMeta:
      expo-router:
        optional: true
      react-native:
        optional: true

  '@expo/code-signing-certificates@0.0.7':
    resolution: {integrity: sha512-zP0tnfqrFFRL8INtOaQ6XwEYfdIpIH9vrEo7y0bHQGQa50z4/QWXE5CI4nRUHxqFW4MVWOwXFg1hom1aAZHNkQ==}
    engines: {node: '>=22.13.0'}

  '@expo/config-plugins@58.0.9':
    resolution: {integrity: sha512-HyP7V1QgDxeHcOEh4qQH7cfK7cI7wNp0y9lszAu98SRYCshhDbwB9gWpFfnpX1GQUtgiqG4Hvgh1z3ntcGwAjw==}

  '@expo/config-types@58.0.3':
    resolution: {integrity: sha512-wyfrwkTT/hQHzwyqkXkngKxoOa8L6ovsTP4h/UukS1mTmssee5et6HOPoN5RtawdJPnm5JO28f//C/wXlpka8Q==}

  '@expo/config@58.0.6':
    resolution: {integrity: sha512-PT1qv4s/R5A/NxXb4efGlFsYF5Consi7F8xSsJBAN090EGDr6U1EDQGOijFqzDc3JA2epD8zjKLJLOVB9YOewg==}

  '@expo/devcert@1.2.2':
    resolution: {integrity: sha512-wz1YedXwdNbYqk/PRr34vixnuw1+l6uSwmPXUj649cot5iYNccb2zIOnK7Nonb1Pfd/dxAY6CvU6KM3uSdxC7A==}

  '@expo/devtools@58.0.2':
    resolution: {integrity: sha512-WBj/K+vv8JPSmY70ennL04YYOHkpEsGGkfuVY9lfv4XO7Qhbt5qz4q6W7maME194I5oGcimRMigUFfWNkBe90w==}
    peerDependencies:
      expo: '*'
      react: '*'
      react-native: '*'
    peerDependenciesMeta:
      expo:
        optional: true
      react:
        optional: true
      react-native:
        optional: true

  '@expo/dom-webview@58.0.2':
    resolution: {integrity: sha512-bLkREoP7qL3rEuzxP60xG+TjdPoGjbnZfxkvYo5imJxGWfKMOf7x962W06Pu+WWAr4gcDRk16iA+Clg8D0zjCg==}
    peerDependencies:
      expo: '*'
      react: '*'
      react-native: '*'

  '@expo/env@2.5.2':
    resolution: {integrity: sha512-z8kCvBVJpd2S20a+Ab1otQgz8sJLeR7CXDTsuAMcNbYFsK10Fdhfb7rx9Ys1vvlbijnY55eZhQvJACajc1IjBQ==}
    engines: {node: '>=20.12.0'}

  '@expo/fingerprint@0.21.5':
    resolution: {integrity: sha512-4ngc+aPgMK56sYc47tfabmoaNdP7OvPBOH7QPgN3riSYM0Ev+KwsGRDius5jBBwjCI9ADp7IpjJEK9xlRYjjvA==}
    hasBin: true

  '@expo/image-utils@0.12.5':
    resolution: {integrity: sha512-nsFYd7GfDdwZa+S+p+EkVCkh7UKKNf0kfUXDQ53HbyMmNFD3psb5JYwU/2N+uZG5wOEfKGfQ5u7pk/wn2gMlBA==}

  '@expo/inline-modules@0.2.6':
    resolution: {integrity: sha512-S8PK3wx6ogwunoQ7pqdPbklQGtXloeWTAOzWJ9yIL7xHFxvnI/Ryj0phA3KEGCMlaKZjaCP1h/3s7n/ueErRgQ==}

  '@expo/json-file@11.2.1':
    resolution: {integrity: sha512-UPhKoFCj8BcwgLB1rKQ1CuR/REITnZLiqxHEHOeH1tPsdXcHGtUDh0P5bLbr7oU0nKVdtJ5rzyKx8jniMQdESQ==}

  '@expo/local-build-cache-provider@58.0.6':
    resolution: {integrity: sha512-AJk3pslFNlwRMbUbfvxhu6CPA9U7A+JPb88VS/uWkG/S/QMJL90Iw4sPVfG4BOKfRUNkB8ipl432Dr4txjSMKw==}

  '@expo/log-box-utils@58.0.2':
    resolution: {integrity: sha512-My8Lwe9FU/yDwwzqwi5LN2rzzDcJqIAZKrD9f0XHZEKz/FQnWJYdt1rsV7+RwqMGeGq2XsxTCVT1ggTCOvumxw==}

  '@expo/log-box@58.0.12':
    resolution: {integrity: sha512-IzDYoFY2iUsmSDvl1V7YUM7UkCPDyMVS4e4a38c2LnFc1A3WGMUiQh+vsHLYTPKjIelu4r7/u4V7Gxtfa0oJgA==}
    peerDependencies:
      '@expo/dom-webview': ^58.0.2
      expo: '*'
      react: '*'
      react-native: '*'
    peerDependenciesMeta:
      expo:
        optional: true

  '@expo/metro-config@58.0.14':
    resolution: {integrity: sha512-UDUMAJwYGEzaB26ejMLG/IOVzwKDbHzoODBf3FZeRS94kk9jDf1dWE1VMX6bLBLoiflxXwqrMWiH0Fvz3gZ9YQ==}
    peerDependencies:
      expo: '*'
    peerDependenciesMeta:
      expo:
        optional: true

  '@expo/metro-file-map@58.0.5':
    resolution: {integrity: sha512-Y2w8qKklLffZie28In4WF6f6e8nIJOhU0mZ5UaQdCiITVQm2a5teNdIDudEPkBsh8ItlvyHZt9n42PN2onRbkQ==}

  '@expo/metro@58.0.0':
    resolution: {integrity: sha512-PMD640ihB0C3Oqm0AnDVJ/8qF2cKbRUEqGuSOr4tM/OTb9ktxsQqsiSSSeaOEgdCZBq20AxRS0d6WHNhhH2P+g==}

  '@expo/modules-macros-win32-arm64@0.20.0':
    resolution: {integrity: sha512-7B57gc7+TeygPcK8fLYlEhJbbvaPh+JBzex11YIYZrSzbFhz7Q+Z37fSdAfp4EsfCswJNcX0S6wpkgSlVNefVw==}
    cpu: [arm64]
    os: [win32]

  '@expo/modules-macros-win32-x64@0.20.0':
    resolution: {integrity: sha512-BM5a2U2tCyHzmtiSEY70KPsts82Mfy1bHSZ7AUbg6z9LcnxuThxJlcH85/SV5eFbhrPfgDBAG/WAncyZCvKvyA==}
    cpu: [x64]
    os: [win32]

  '@expo/osascript@2.8.1':
    resolution: {integrity: sha512-SCi+6q6uOkGhiAn6AIP/OPFgaIq/iKD2oYpnAOg2rShHStJ8ey7wyT127RbOaZXmlcY/62rHOX1WiiMnD8u/BA==}
    engines: {node: '>=12'}

  '@expo/package-manager@1.14.2':
    resolution: {integrity: sha512-sftl0eRVVCarI6grMdjAB3jX2pX1Mt3cdSnajlXS4QyeDkaKRM/ntBy6dcagj1VL0+cEfEqctlyvinmlZdNubg==}

  '@expo/platforms@58.0.1':
    resolution: {integrity: sha512-KtLrtAvpShq16l9lTxd2fZSjULxcGxXrJTHA31iUVqrc+Af7aTAJW4ZB3yQBgi/w+kSb6BB/CG9RXI0ohbMm6g==}

  '@expo/plist@0.10.1':
    resolution: {integrity: sha512-nuNOqj+r/hGJbZ1Ax3jUpZaOB8UAMHUrISALJEUKaCieTflYj7224EqFWmMpriCGk9wXS1gH+9GGVnSj0tWzuQ==}

  '@expo/prebuild-config@58.0.14':
    resolution: {integrity: sha512-2wVzVDfXjRB3LzUbW5shOM/A+6eUUCfR+2bpZiWRBBZBtZP2HA5Zq1YgCio1tDqMGAHf2NQQDhvy/Rz1U6aC3A==}

  '@expo/require-utils@58.0.4':
    resolution: {integrity: sha512-DvjS5NCitXYcad2Woe1EMHJKcbhTbE77HX0BgOQGL2LFHE3q2H0n8kCWDPBOCVJ63Drap3c35nwoJwF5TQL7Tw==}
    peerDependencies:
      typescript: ^5.0.0 || ^5.0.0-0 || ^6.0.0 || ^7.0.0
    peerDependenciesMeta:
      typescript:
        optional: true

  '@expo/router-server@58.0.14':
    resolution: {integrity: sha512-RSzQYMA+Tv2eTemhjhzpx8+hL+pMC30JTVqAWrk5AZwht+OgaKZar/gHmj4iJf7n3rq+GG6KujrkKF9xAXLz2w==}
    peerDependencies:
      '@expo/metro-runtime': ^58.0.14
      expo: '*'
      expo-constants: ^58.0.12
      expo-font: ^58.0.8
      expo-router: '*'
      expo-server: ^58.0.5
      react: '*'
      react-dom: '*'
      react-server-dom-webpack: ~19.0.1 || ~19.1.2 || ~19.2.1 || ~19.3.0
    peerDependenciesMeta:
      '@expo/metro-runtime':
        optional: true
      expo-router:
        optional: true
      react-dom:
        optional: true
      react-server-dom-webpack:
        optional: true

  '@expo/schema-utils@58.0.2':
    resolution: {integrity: sha512-w28y8SG+5ZTdDdmH2ZnCQk9wHVwGzI9NqX5V4urJUFEnxbm7I129fJRkb8RIAJmMA1WKU5h3ONmranV473uaXQ==}

  '@expo/sdk-runtime-versions@1.0.1':
    resolution: {integrity: sha512-kvisefkhxu8Fm/4M8G6DEqUaigrXfrSOm2lFw7hsk/nq0zchcp6B4wSk8rlheHY8FRi5iHxKtoVMGY/3M6h04A==}

  '@expo/spawn-async@1.8.0':
    resolution: {integrity: sha512-eb9xxd/LbuEGSdua4NumCu/McVB9EM+F/JxB9pWgnERw4HQ9XyTNH1KapG6oqLWR8TuRK2LQfzJlmNi94CVobw==}
    engines: {node: '>=12'}

  '@expo/sudo-prompt@9.3.2':
    resolution: {integrity: sha512-HHQigo3rQWKMDzYDLkubN5WQOYXJJE2eNqIQC2axC2iO3mHdwnIR7FgZVvHWtBwAdzBgAP0ECp8KqS8TiMKvgw==}

  '@expo/ws-tunnel@2.0.1':
    resolution: {integrity: sha512-mljsRffbOHzmSimYQbQu9h9NR3alwCCwEEouRGFL4QRTt8dNvsNtKEPa/5jHmtDLDtsh4xXsWKwzjN9BTpeXHQ==}
    peerDependencies:
      ws: ^8.0.0

  '@expo/xcpretty@4.4.7':
    resolution: {integrity: sha512-EbxYllZ7/ozONVZd425cm4XnolfW+AmSFT5aP7Jdno6oc3WrYQcHz2CO20z/2rwWwYgztmV2PXvYH+BQ8YFjqg==}
    hasBin: true

  '@isaacs/ttlcache@1.4.1':
    resolution: {integrity: sha512-RQgQ4uQ+pLbqXfOmieB91ejmLwvSgv9nLx6sT6sD83s7umBypgg+OIBOBbEUiJXrfpnp9j0mRhYYdzp9uqq3lA==}
    engines: {node: '>=12'}

  '@jest/schemas@29.6.3':
    resolution: {integrity: sha512-mo5j5X+jIZmJQveBKeS/clAueipV7KgiX1vMgCxam1RNYiqE1w62n0/tJJnHtjW8ZHcQco5gY85jA3mi0L+nSA==}
    engines: {node: ^14.15.0 || ^16.10.0 || >=18.0.0}

  '@jest/types@29.6.3':
    resolution: {integrity: sha512-u3UPsIilWKOM3F9CXtrG8LEJmNxwoCQC/XVj4IKYXvvpx7QIi/Kg1LI5uDmDpKlac62NUtX7eLjRh+jVZcLOzw==}
    engines: {node: ^14.15.0 || ^16.10.0 || >=18.0.0}

  '@jridgewell/gen-mapping@0.3.13':
    resolution: {integrity: sha512-2kkt/7niJ6MgEPxF0bYdQ6etZaA+fQvDcLKckhy1yIQOzaoKjBBjSj63/aLVjYE3qhRt5dvM+uUyfCg6UKCBbA==}

  '@jridgewell/remapping@2.3.5':
    resolution: {integrity: sha512-LI9u/+laYG4Ds1TDKSJW2YPrIlcVYOwi2fUC6xB43lueCjgxV4lffOCZCtYFiH6TNOX+tQKXx97T4IKHbhyHEQ==}

  '@jridgewell/resolve-uri@3.1.2':
    resolution: {integrity: sha512-bRISgCIjP20/tbWSPWMEi54QVPRZExkuD9lJL+UIxUKtwVJA8wW1Trb1jMs1RFXo1CBTNZ/5hpC9QvmKWdopKw==}
    engines: {node: '>=6.0.0'}

  '@jridgewell/source-map@0.3.11':
    resolution: {integrity: sha512-ZMp1V8ZFcPG5dIWnQLr3NSI1MiCU7UETdS/A0G8V/XWHvJv3ZsFqutJn1Y5RPmAPX6F3BiE397OqveU/9NCuIA==}

  '@jridgewell/sourcemap-codec@1.6.0':
    resolution: {integrity: sha512-T7jf+5zgsZHwNJ4lvQ7/aezbyk0nNX+zJVWpmHA7VYsEx7a7qr5Rg5IbtJFqkgze5Y2sruq1RUY8Q837Od7iFw==}

  '@jridgewell/trace-mapping@0.3.31':
    resolution: {integrity: sha512-zzNR+SdQSDJzc8joaeP8QQoCQr8NuYx2dIIytl1QeBEZHJ9uW6hebsrYgbz8hJwUQao3TWCMtmfV8Nu1twOLAw==}

  '@noxcturnal/noxcturnal-darwin-arm64@0.1.5':
    resolution: {integrity: sha512-hQgDaWxKYln83Uk1Hh4Liju9AvGoYh4aLd4A1ou3lGn5hxzhW2uO+z3mERtWk6BMGVazvi/yUXtp9x3IlaWyhA==}
    engines: {node: '>=18'}
    cpu: [arm64]
    os: [darwin]

  '@noxcturnal/noxcturnal-darwin-x64@0.1.5':
    resolution: {integrity: sha512-I57zR8QF7Xam+4nGD5UoIODsw0VjkVyn51iDBL3CMaDR5Lh1OxXwKZMYKtv3CtQl+RSDsMfmXBEqGYLE8lIPHg==}
    engines: {node: '>=18'}
    cpu: [x64]
    os: [darwin]

  '@noxcturnal/noxcturnal-linux-arm64-gnu@0.1.5':
    resolution: {integrity: sha512-gVH4XJPh8RdrdjjlU0dKeielQt/FXfvqhr8IEWEf3VeNtQs8l2rPzFPdqS0uwLWQYHLBGgB0LkuOil1KKYx1gQ==}
    engines: {node: '>=18'}
    cpu: [arm64]
    os: [linux]
    libc: [glibc]

  '@noxcturnal/noxcturnal-linux-arm64-musl@0.1.5':
    resolution: {integrity: sha512-rzQ075fcHZ+ebsELussRjnW8WBMy1RuLdS8wSqBGhdVlPR7/NaSyoWkNxnVDT8sEO26xjqGoW/o/08ghBzr/zA==}
    engines: {node: '>=18'}
    cpu: [arm64]
    os: [linux]
    libc: [musl]

  '@noxcturnal/noxcturnal-linux-x64-gnu@0.1.5':
    resolution: {integrity: sha512-X5O0lXMrv8HGOGoXDB1PG0Hjt7Rl+MJA+seR2NecQvUAAw2gzDvF/unCV5sqTAVeHfXhBHEFGkLenHZSD44efg==}
    engines: {node: '>=18'}
    cpu: [x64]
    os: [linux]
    libc: [glibc]

  '@noxcturnal/noxcturnal-linux-x64-musl@0.1.5':
    resolution: {integrity: sha512-fkQIQHRxqldNXVmjxfeCvGOiLhLU9SLBw1As02pMA2xjyiZfiXcUn4SUrZ92ciGnyCS8/XMbx+nZSxgEc3qDPw==}
    engines: {node: '>=18'}
    cpu: [x64]
    os: [linux]
    libc: [musl]

  '@noxcturnal/noxcturnal-win32-arm64-msvc@0.1.5':
    resolution: {integrity: sha512-baeH5m/vM1nf0J2UkW8cfgiVogpM0gRO9b4PZWknXQPbv5+k+0N5sGOYl/UAO2q72qYb3Xbiu7eD8c4A2kR2SA==}
    engines: {node: '>=18'}
    cpu: [arm64]
    os: [win32]

  '@noxcturnal/noxcturnal-win32-x64-msvc@0.1.5':
    resolution: {integrity: sha512-2faDMzom8pCG/s/uR4Czh1atz4KohI85AaSmA2vtAuVnCq+nLL4Viys3A5vUlNz9MNBmTNFxzXyF2Z5HtfxXLg==}
    engines: {node: '>=18'}
    cpu: [x64]
    os: [win32]

  '@oxc-project/types@0.154.0':
    resolution: {integrity: sha512-KYOUGQFlLWR+s4QMV2Q9ko38TZm7EdO87Qm7rvZLqk/webse/cDjtyxKhg/47l0byCbs/k46LT8qc4PKjAikzA==}

  '@react-native/asset-utils@0.88.0':
    resolution: {integrity: sha512-Bj1DxQt5f4OrjdlgSVkZT37Z3hx5hUIN5AUDSqL/e99vgtTcqj5vnm067epZL1EF/QiqsniZO8Q1GSkItOakDg==}
    engines: {node: ^22.13.0 || ^24.3.0 || >= 26.0.0}

  '@react-native/babel-plugin-codegen@0.88.0':
    resolution: {integrity: sha512-leGEnCcS7Q0hTxvzvhNtr8zGQpI1gfWqXjzC4UedsFmNMv6kIo4s70o0XbtM30ZXbpfWe4BcSC8NKWuak5sI4A==}
    engines: {node: ^22.13.0 || ^24.3.0 || >= 26.0.0}

  '@react-native/codegen@0.88.0':
    resolution: {integrity: sha512-SAGg+XfzsrPiYTscbKa9bo2/H2ei2TjyxW8RTMq2Ps661kRK3AnmpMGVfrEFshEMr3FGEbuQIvj86X98kaXlRA==}
    engines: {node: ^22.13.0 || ^24.3.0 || >= 26.0.0}
    peerDependencies:
      '@babel/core': '*'

  '@react-native/community-cli-plugin@0.88.0':
    resolution: {integrity: sha512-WrQdXbjVt1gwAay8ZzYtpOi9ly99ksJ0VMYFdVcMe6nq3vtiRgqKRpHgCdN6ySIbtr5o+aJ+Vr7OTDY98ec/Ow==}
    engines: {node: ^22.13.0 || ^24.3.0 || >= 26.0.0}
    peerDependencies:
      '@react-native-community/cli': '*'
      '@react-native/metro-config': 0.88.0
    peerDependenciesMeta:
      '@react-native-community/cli':
        optional: true
      '@react-native/metro-config':
        optional: true

  '@react-native/debugger-frontend@0.88.0':
    resolution: {integrity: sha512-v5cnBaaWhDRPcQv8EC20zj53jOAKH7u2wnzzXS4JTNu+diPC+cA2+kC7rq3eKI5vGhlAcG2kDPoViRuC0AY0oA==}
    engines: {node: ^22.13.0 || ^24.3.0 || >= 26.0.0}

  '@react-native/debugger-shell@0.88.0':
    resolution: {integrity: sha512-p82zT8ZKNx7nIm/8zf8pi55sxm5KQBm8td47kzoJysTdqHLyPsRMUvDXtvCJIWadHSv7RJ6t/yiCc+IoImLBtw==}
    engines: {node: ^22.13.0 || ^24.3.0 || >= 26.0.0}

  '@react-native/dev-middleware@0.88.0':
    resolution: {integrity: sha512-sHLxVHOwfkF672ZzMepNh4d3IKbrZy3qXDKWSwN5LC5VJkzzZ5FdmSPP4N/CCn2pcKJ4oSqvojXwN4De3Xk92A==}
    engines: {node: ^22.13.0 || ^24.3.0 || >= 26.0.0}

  '@react-native/gradle-plugin@0.88.0':
    resolution: {integrity: sha512-4jPSKslOfJj8NKY/jv9qmWkxZYmqPyamoS3Vs0JOFxw9t4PM6L/ea0fUsjNV0LxC9zJlvWilPJOCTOf7h8wlyw==}
    engines: {node: ^22.13.0 || ^24.3.0 || >= 26.0.0}

  '@react-native/js-polyfills@0.88.0':
    resolution: {integrity: sha512-Iq6v4+EWdOLv0M1+BpADQJBVfInl6FkABXCIBSi0FbvHahEYT+Y4UJ7Cm96p18gbEN1VKzqz3nbBbwLA6bx0rQ==}
    engines: {node: ^22.13.0 || ^24.3.0 || >= 26.0.0}

  '@react-native/normalize-colors@0.88.0':
    resolution: {integrity: sha512-eZCu3tGAQCfvMCPQJVY4dmoMX8ZZYBvqIGHX7lwOYyzNK+Dl8e5ky7ZoXub1Rq75oSrQXNNmSP2CDjNNXXZpFQ==}

  '@react-native/virtualized-lists@0.88.0':
    resolution: {integrity: sha512-zpZIOAbobdS93edwHkNUdGDzvElNeQJqukRERRPns3/ucPvuMd2G4fYpmVJSVjhxtGCcLLB1PFndLYYfwaYoBQ==}
    engines: {node: ^22.13.0 || ^24.3.0 || >= 26.0.0}
    peerDependencies:
      '@types/react': ^19.2.0
      react: '*'
      react-native: 0.88.0
    peerDependenciesMeta:
      '@types/react':
        optional: true

  '@sinclair/typebox@0.27.12':
    resolution: {integrity: sha512-hhyNJ+nbR6ZR7pToHvllEFun9TL0sbL+tk/ON75lo+Xas054uez98qRbsuNt7MBCyZKK4+8Yli/OAGZhmfBZ/g==}

  '@types/istanbul-lib-coverage@2.0.6':
    resolution: {integrity: sha512-2QF/t/auWm0lsy8XtKVPG19v3sSOQlJe/YHZgfjb/KBBHOGSV+J2q/S671rcq9uTBrLAXmZpqJiaQbMT+zNU1w==}

  '@types/istanbul-lib-report@3.0.3':
    resolution: {integrity: sha512-NQn7AHQnk/RSLOxrBbGyJM/aVQ+pjj5HCgasFxc0K/KhoATfQ/47AyUl15I2yBUpihjmas+a+VJBOqecrFH+uA==}

  '@types/istanbul-reports@3.0.4':
    resolution: {integrity: sha512-pk2B1NWalF9toCRu6gjBzR69syFjP4Od8WRAX+0mmf9lAjCRicLOWc+ZrxZHx/0XRjotgkF9t6iaMJ+aXcOdZQ==}

  '@types/node@26.6.5':
    resolution: {integrity: sha512-uMzsv9stDdofIZBx4UGh4Z9ZgXnGC9seRDscilBcTHAeOFk67MZg/k9bWVfO+bk4qZmG+l52hRnLwUiH2LnJTg==}

  '@types/yargs-parser@21.0.3':
    resolution: {integrity: sha512-I4q9QU9MQv4oEOz4tAHJtNz1cwuLxn2F3xcc2iV5WdqLPpUnj30aUuxt1mAxYTG+oe8CZMV/+6rU4S4gRDzqtQ==}

  '@types/yargs@17.0.35':
    resolution: {integrity: sha512-qUHkeCyQFxMXg79wQfTtfndEC+N9ZZg76HJftDJp+qH2tV7Gj4OJi7l+PiWwJ+pWtW8GwSmqsDj/oymhrTWXjg==}

  '@ungap/structured-clone@1.4.0':
    resolution: {integrity: sha512-1mEZtMKPM09vDmQt5y7YvmN2+DFTP7Tg0EWXdic8/C6VRnpb33e4ghisCIE3WZjsE2N8mf+QV1Zqh7ZFYLWInQ==}

  '@xmldom/xmldom@0.8.15':
    resolution: {integrity: sha512-/5NV/vDALVFDXgLmfsy9TRCBlKwO2LNBFzpzvb9iIj+jR+eSc6DLYYvVOdivT/jm7MtU6TebYuRmzEOI7w40UA==}
    engines: {node: '>=10.0.0'}

  '@xmldom/xmldom@0.9.12':
    resolution: {integrity: sha512-5AXjrcMClTryPe9LgZrygpB1lj7s0S9E0+W+AHaVKAVyHanafK86iPSvG5xHVSp/jC+VH1UXu0TAEmY279xH7A==}
    engines: {node: '>=14.6'}

  accepts@1.3.8:
    resolution: {integrity: sha512-PYAthTa2m2VKxuvSD3DPC/Gy+U+sOA1LAuT8mkmRuvw+NACSaeXEQ+NHcVF7rONl6qcaxV3Uuemwawk+7+SJLw==}
    engines: {node: '>= 0.6'}

  accepts@2.0.0:
    resolution: {integrity: sha512-5cvg6CtKwfgdmVqY1WIiXKc3Q1bkRqGLi+2W/6ao+6Y7gu/RCwRuAhGEzh5B4KlszSuTLgZYuqFqo5bImjNKng==}
    engines: {node: '>= 0.6'}

  acorn@8.19.0:
    resolution: {integrity: sha512-oJlA3XiRm7Cyk6qFD2Jn8ak9B7jSy0qy00ADO3+8dpT0LSjFihQYv4C02LFCSYJV3Q37xYwwRy5m+IpIiUzqWw==}
    engines: {node: '>=0.4.0'}
    hasBin: true

  agent-base@7.1.4:
    resolution: {integrity: sha512-MnA+YT8fwfJPgBx3m60MNqakm30XOkyIoH1y6huTQvC0PwZG7ki8NacLBcrPbNoo8vEZy7Jpuk7+jMO+CUovTQ==}
    engines: {node: '>= 14'}

  agent-cli-detector@0.1.7:
    resolution: {integrity: sha512-d8OWDVdZMgjhLUT9ZPgSv/BdFFF9pVuscC0JdUSz3bjwE15gcp6u/o0/JooM2yyAWC49KThFhXlgTXRa9B7yng==}
    engines: {node: '>=18.18'}
    hasBin: true

  anser@1.4.10:
    resolution: {integrity: sha512-hCv9AqTQ8ycjpSd3upOJd7vFwW1JaoYQ7tpham03GJ1ca8/65rqn0RpaWpItOAd6ylW9wAw6luXYPJIyPFVOww==}

  ansi-escapes@4.3.2:
    resolution: {integrity: sha512-gKXj5ALrKWQLsYG9jlTRmR/xKluxHV+Z9QEwNIgCfM1/uwPMCuzVVnh5mwTd+OuBZcwSIMbqssNWRm1lE51QaQ==}
    engines: {node: '>=8'}

  ansi-regex@4.1.1:
    resolution: {integrity: sha512-ILlv4k/3f6vfQ4OoP2AGvirOktlQ98ZEL1k9FaQjxa3L1abBgbuTDAdPOpvbGncC0BTVQrl+OM8xZGK6tWXt7g==}
    engines: {node: '>=6'}

  ansi-regex@5.0.1:
    resolution: {integrity: sha512-quJQXlTSUGL2LH9SUXo8VwsY4soanhgo6LNSm84E1LBcE8s3O0wpdiRzyR9z/ZZJMlMWv37qOOb9pdJlMUEKFQ==}
    engines: {node: '>=8'}

  ansi-styles@3.2.1:
    resolution: {integrity: sha512-VT0ZI6kZRdTh8YyJw3SMbYm/u+NqfsAxEpWO0Pf9sq8/e94WxxOpPKx9FR1FlyCtOVDNOQ+8ntlqFxiRc+r5qA==}
    engines: {node: '>=4'}

  ansi-styles@4.3.0:
    resolution: {integrity: sha512-zbB9rCJAT1rbjiVDb2hqKFHNYLxgtk8NURxZ3IZwD3F6NtxbXZQCnnSi1Lkx+IDohdPlFp222wVALIheZJQSEg==}
    engines: {node: '>=8'}

  ansi-styles@5.2.0:
    resolution: {integrity: sha512-Cxwpt2SfTzTtXcfOlzGEee8O+c+MmUgGrNiBcXnuWxuFJHe6a5Hz7qwhwe5OgaSYI0IJvkLqWX1ASG+cJOkEiA==}
    engines: {node: '>=10'}

  arg@5.0.2:
    resolution: {integrity: sha512-PYjyFOLKQ9y57JvQ6QLo8dAgNqswh8M1RMJYdQduT6xbWSgK36P/Z/v+p888pM69jMMfS8Xd8F6I1kQ/I9HUGg==}

  argparse@2.0.1:
    resolution: {integrity: sha512-8+9WqebbFzpX9OR+Wa6O29asIogeRMzcGtAINdpMHHyAg10f05aSFVBbcEqGf/PXw1EjAZ+q2/bEBg3DvurK3Q==}

  asap@2.0.6:
    resolution: {integrity: sha512-BSHWgDSAiKs50o2Re8ppvp3seVHXSRM44cdSsT9FfNEUUZLOGWVCsiWaRPWM1Znn+mqZ1OfVZ3z3DWEzSp7hRA==}

  babel-plugin-polyfill-corejs2@0.4.17:
    resolution: {integrity: sha512-aTyf30K/rqAsNwN76zYrdtx8obu0E4KoUME29B1xj+B3WxgvWkp943vYQ+z8Mv3lw9xHXMHpvSPOBxzAkIa94w==}
    peerDependencies:
      '@babel/core': ^7.4.0 || ^8.0.0-0 <8.0.0

  babel-plugin-polyfill-corejs3@0.13.0:
    resolution: {integrity: sha512-U+GNwMdSFgzVmfhNm8GJUX88AadB3uo9KpJqS3FaqNIPKgySuvMb+bHPsOmmuWyIcuqZj/pzt1RUIUZns4y2+A==}
    peerDependencies:
      '@babel/core': ^7.4.0 || ^8.0.0-0 <8.0.0

  babel-plugin-polyfill-regenerator@0.6.8:
    resolution: {integrity: sha512-M762rNHfSF1EV3SLtnCJXFoQbbIIz0OyRwnCmV0KPC7qosSfCO0QLTSuJX3ayAebubhE6oYBAYPrBA5ljowaZg==}
    peerDependencies:
      '@babel/core': ^7.4.0 || ^8.0.0-0 <8.0.0

  babel-plugin-react-compiler@1.0.0:
    resolution: {integrity: sha512-Ixm8tFfoKKIPYdCCKYTsqv+Fd4IJ0DQqMyEimo+pxUOMUR9cVPlwTrFt9Avu+3cb6Zp3mAzl+t1MrG2fxxKsxw==}

  babel-plugin-react-native-web@0.21.4:
    resolution: {integrity: sha512-FSclsDTGi5EcvpbW3TM7s8GLWwQqo5wI9zQqJr2m0IoJRenSkp1+bVvdeZXTNznI5Ms9Bry7DLBR+C5Shb9gtw==}

  babel-plugin-syntax-hermes-parser@0.36.1:
    resolution: {integrity: sha512-ycduwJbvdvIMmVvlAZqGggS+pm5Eu4Bk9pcV9Sm2Z4PJNRVsKkv0g7vHj+LeuC1gHTeF67sJXFOq61IlqCa2hA==}

  babel-plugin-transform-flow-enums@0.0.2:
    resolution: {integrity: sha512-g4aaCrDDOsWjbm0PUUeVnkcVd6AKJsVc/MbnPhEotEpkeJQP6b8nzewohQi7+QS8UyPehOhGWn0nOwjvWpmMvQ==}

  babel-preset-expo@58.0.17:
    resolution: {integrity: sha512-Rrqc/Z5Idc4bG2/PrEh725t3kvuAc7jUKCJ+wZVU9KXk2bKSdqAniXxQa8aph9aHdv4h5sGKLpMXMaMNz/4+Og==}
    peerDependencies:
      '@babel/runtime': ^7.20.0
      expo: '*'
      expo-widgets: ^58.0.20
      react-refresh: '>=0.14.0 <1.0.0'
    peerDependenciesMeta:
      '@babel/runtime':
        optional: true
      expo:
        optional: true
      expo-widgets:
        optional: true

  balanced-match@4.0.4:
    resolution: {integrity: sha512-BLrgEcRTwX2o6gGxGOCNyMvGSp35YofuYzw9h1IMTRmKqttAZZVU67bdb9Pr2vUHA8+j3i2tJfjO6C6+4myGTA==}
    engines: {node: 18 || 20 || >=22}

  base64-js@1.5.1:
    resolution: {integrity: sha512-AKpaYlHn8t4SVbOHCy+b5+KKgvR4vrsD8vbvrbiQJps7fKDTkjkDry6ji0rUJjC0kzbNePLwzxq8iypo41qeWA==}

  baseline-browser-mapping@2.11.29:
    resolution: {integrity: sha512-YeesxhUmR4h5y5V8KF8iBCqJb8YFrBJ++XBTeGcWIaQOYXGN19JM0FoiOjAhwuDoln8owMgXcWBmgHtYSkky2w==}
    engines: {node: '>=6.0.0'}
    hasBin: true

  big-integer@1.6.52:
    resolution: {integrity: sha512-QxD8cf2eVqJOOz63z6JIN9BzvVs/dlySa5HGSBH5xtR8dPteIRQnBxxKqkNTiT6jbDTF6jAfrd4oMcND9RGbQg==}
    engines: {node: '>=0.6'}

  bplist-creator@0.1.0:
    resolution: {integrity: sha512-sXaHZicyEEmY86WyueLTQesbeoH/mquvarJaQNbjuOQO+7gbFcDEWqKmcWA4cOTLzFlfgvkiVxolk1k5bBIpmg==}

  bplist-parser@0.3.1:
    resolution: {integrity: sha512-PyJxiNtA5T2PlLIeBot4lbp7rj4OadzjnMZD/G5zuBNt8ei/yCU7+wW0h2bag9vr8c+/WuRWmSxbqAl9hL1rBA==}
    engines: {node: '>= 5.10.0'}

  bplist-parser@0.3.2:
    resolution: {integrity: sha512-apC2+fspHGI3mMKj+dGevkGo/tCqVB8jMb6i+OX+E29p0Iposz07fABkRIfVUPNd5A5VbuOz1bZbnmkKLYF+wQ==}
    engines: {node: '>= 5.10.0'}

  brace-expansion@5.0.12:
    resolution: {integrity: sha512-YovQ3rzhaLMIrDjNDMkNS01tea93qhEhG5xy8f6+R0l+dw3Ki+5sCoIoI942iuLZTHWogWktgwVDhU09iNEimQ==}
    engines: {node: 20 || >=22}

  braces@3.0.3:
    resolution: {integrity: sha512-yQbXgO/OSZVD2IsiLlro+7Hf6Q18EJrKSEsdoMzKePKXct3gvD8oLcOQdIzGupr5Fj+EDe8gO/lxc1BzfMpxvA==}
    engines: {node: '>=8'}

  browserslist@4.29.3:
    resolution: {integrity: sha512-1R4kiYKXGViqEN0CnoDrXc1StD9niAwu+j2dukWzrD4bJgsD4lDmEp0CRbc6E/vYJIfTHwPmwyaKtVSudICdPA==}
    engines: {node: ^6 || ^7 || ^8 || ^9 || ^10 || ^11 || ^12 || >=13.7}
    hasBin: true

  bser@2.1.2:
    resolution: {integrity: sha512-V2o8YS2EhrKMO9AumnkK0ynynfFlsajpYupwq7S46H5mhcanwxDkNTw3K67wPIcKTH1ffkA4vhMOtAc7gRmPZw==}

  buffer-from@1.1.2:
    resolution: {integrity: sha512-E+XQCRwSbaaiChtv6k6Dwgc+bx+Bs6vuKJHHl5kox/BaKbhiXzqQOwK4cO22yElGp2OCmjwVhT3HmxgyPGnJfQ==}

  bytes@3.1.2:
    resolution: {integrity: sha512-/Nf7TyzTx6S3yRJObOAV7956r8cr2+Oj8AC5dt8wSP3BQAoeX58NoHyCU8P8zGkNXStjTSi6fzO6F0pBdcYbEg==}
    engines: {node: '>= 0.8'}

  camelcase@6.3.0:
    resolution: {integrity: sha512-Gmy6FhYlCY7uOElZUSbxo2UCDH8owEk996gkbrpsgGtrJLM3J7jGxl9Ic7Qwwj4ivOE5AWZWRMecDdF7hqGjFA==}
    engines: {node: '>=10'}

  caniuse-lite@1.0.30001816:
    resolution: {integrity: sha512-+8Yx7BXCoqk6IF8yTicjfUR6D/ldJzdlsodlEOiOSPmhK844WIgk67/zIQaGAOxNkZyyvBlrRFnLvqKIoqbAFw==}

  chalk@2.4.2:
    resolution: {integrity: sha512-Mti+f9lpJNcwF4tWV8/OrTTtF1gZi+f8FqlyAdouralcFWFQWF2+NgCHShjkCb+IFBLq9buZwE1xckQU4peSuQ==}
    engines: {node: '>=4'}

  chalk@4.1.2:
    resolution: {integrity: sha512-oKnbhFyRIXpUuez8iBMmyEa4nbj4IOQyuhc/wy9kY7/WVPcwIO9VA668Pu8RkO7+0G76SLROeyw9CpQ061i4mA==}
    engines: {node: '>=10'}

  ci-info@3.9.0:
    resolution: {integrity: sha512-NIxF55hv4nSqQswkAeiOi1r83xy8JldOFDTWiug55KBu9Jnblncd2U6ViHmYgHf01TPZS77NJBhBMKdWj9HQMQ==}
    engines: {node: '>=8'}

  cli-cursor@2.1.0:
    resolution: {integrity: sha512-8lgKz8LmCRYZZQDpRyT2m5rKJ08TnU4tR9FFFW2rxpxR1FzWi4PQ/NfyODchAatHaUgnSPVcx/R5w6NuTBzFiw==}
    engines: {node: '>=4'}

  cli-spinners@2.9.2:
    resolution: {integrity: sha512-ywqV+5MmyL4E7ybXgKys4DugZbX0FC6LnwrhjuykIjnK9k8OQacQ7axGKnjDXWNhns0xot3bZI5h55H8yo9cJg==}
    engines: {node: '>=6'}

  cliui@8.0.1:
    resolution: {integrity: sha512-BSeNnyus75C4//NQ9gQt1/csTXyo/8Sb+afLAkzAptFuMsod9HFokGNudZpi/oQV73hnVK+sR+5PVRMd+Dr7YQ==}
    engines: {node: '>=12'}

  clone@1.0.4:
    resolution: {integrity: sha512-JQHZ2QMW6l3aH/j6xCqQThY/9OH4D/9ls34cgkUBiEeocRTU04tHfKPBsUK1PqZCUQM7GiA0IIXJSuXHI64Kbg==}
    engines: {node: '>=0.8'}

  color-convert@1.9.3:
    resolution: {integrity: sha512-QfAUtd+vFdAtFQcC8CCyYt1fYWxSqAiK2cSD6zDB8N3cpsEBAvRxp9zOGg6G/SHHJYAT88/az/IuDGALsNVbGg==}

  color-convert@2.0.1:
    resolution: {integrity: sha512-RRECPsj7iu/xb5oKYcsFHSppFNnsj/52OVTRKb4zP5onXwVF3zVmmToNcOfGC+CRDpfK/U584fMg38ZHCaElKQ==}
    engines: {node: '>=7.0.0'}

  color-name@1.1.3:
    resolution: {integrity: sha512-72fSenhMw2HZMTVHeCA9KCmpEIbzWiQsjN+BHcBbS9vr1mtt+vJjPdksIBNUmKAW8TFUDPJK5SUU3QhE9NEXDw==}

  color-name@1.1.4:
    resolution: {integrity: sha512-dOy+3AuW3a2wNbZHIuMZpTcgjGuLU/uBL/ubcZF9OXbDo8ff4O8yVp5Bf0efS8uEoYo5q4Fx7dY9OgQGXgAsQA==}

  commander@12.1.0:
    resolution: {integrity: sha512-Vw8qHK3bZM9y/P10u3Vib8o/DdkvA2OtPtZvD871QKjy74Wj1WSKFILMPRPSdUSx5RFK1arlJzEtA4PkFgnbuA==}
    engines: {node: '>=18'}

  commander@2.20.3:
    resolution: {integrity: sha512-GpVkmM8vF2vQUkj2LvZmD35JxeJOLCwJ9cUkugyk2nuhbv3+mJvpLYYt+0+USMxE+oj+ey/lJEnhZw75x/OMcQ==}

  commander@7.2.0:
    resolution: {integrity: sha512-QrWXB+ZQSVPmIWIhtEO9H+gwHaMGYiF5ChvoJ+K9ZGHG/sVsa6yiesAD1GC/x46sET00Xlwo1u49RVVVzvcSkw==}
    engines: {node: '>= 10'}

  compressible@2.0.18:
    resolution: {integrity: sha512-AF3r7P5dWxL8MxyITRMlORQNaOA2IkAFaTr4k7BUumjPtRpGDTZpl0Pb1XCO6JeDCBdp126Cgs9sMxqSjgYyRg==}
    engines: {node: '>= 0.6'}

  compression@1.8.2:
    resolution: {integrity: sha512-o8vI5RE5A6EVVOd9o41jKp41aJom+QTEO/Bx8MYNjexMo/Bv2WOjUfZr+aL0WnYSgymUy6zeguqLTsIhV0gMvQ==}
    engines: {node: '>= 0.8.0'}

  connect@3.7.0:
    resolution: {integrity: sha512-ZqRXc+tZukToSNmh5C2iWMSoV3X1YUcPbqEM4DkEG5tNQXrQUZCNVGGv3IuicnkMtPfGf3Xtp8WCXs295iQ1pQ==}
    engines: {node: '>= 0.10.0'}

  content-type@2.1.0:
    resolution: {integrity: sha512-mj7UPXE0jaqaOsukNZRUEfEi2AcL7C/vwmwcHV0O97eO1E1pxBZuyjlZrx5seTaNBg1U6+o35wpa35Qfcc+7ag==}
    engines: {node: '>=18'}

  convert-source-map@2.0.0:
    resolution: {integrity: sha512-Kvp459HrV2FEJ1CAsi1Ku+MY3kasH19TFykTz2xWmMeq6bk2NU3XXvfJ+Q61m0xktWwt+1HSYf3JZsTms3aRJg==}

  core-js-compat@3.50.0:
    resolution: {integrity: sha512-XGpFGbMLHwSt74YLTKho7Ib242qi6O8MSX+sRokV4oz7iKXvQWGYZthjIhjRGMxjzVkAubBO512dKGYcefmX3Q==}
    engines: {node: '>=6.4.0'}

  cross-spawn@7.0.6:
    resolution: {integrity: sha512-uV2QOWP2nWzsy2aMp8aRibhi9dlzF5Hgh5SHaB9OiTGEyDTiJJyx0uy51QXdyWbtAHNua4XJzUKca3OzKUd3vA==}
    engines: {node: '>= 8'}

  debug@2.6.9:
    resolution: {integrity: sha512-bC7ElrdJaJnPbAP+1EotYvqZsb3ecl5wi6Bfi6BJTUcNowp6cvspg0jXznRTKDjm/E7AdgFBVeAPVMNcKGsHMA==}
    peerDependencies:
      supports-color: '*'
    peerDependenciesMeta:
      supports-color:
        optional: true

  debug@3.2.7:
    resolution: {integrity: sha512-CFjzYYAi4ThfiQvizrFQevTTXHtnCqWfe7x1AhgEscTz6ZbLbfoLRLPugTQyBth6f8ZERVUSyWHFD/7Wu4t1XQ==}
    peerDependencies:
      supports-color: '*'
    peerDependenciesMeta:
      supports-color:
        optional: true

  debug@4.4.3:
    resolution: {integrity: sha512-RGwwWnwQvkVfavKVt22FGLw+xYSdzARwm0ru6DhTVA3umU5hZc28V3kO4stgYryrTlLpuvgI9GiijltAjNbcqA==}
    engines: {node: '>=6.0'}
    peerDependencies:
      supports-color: '*'
    peerDependenciesMeta:
      supports-color:
        optional: true

  deepmerge@4.3.1:
    resolution: {integrity: sha512-3sUqbMEc77XqpdNO7FRyRog+eW3ph+GYCbj+rK+uYyRMuwsVy0rMiVtPn+QJlKFvWP/1PYpapqYn0Me2knFn+A==}
    engines: {node: '>=0.10.0'}

  defaults@1.0.4:
    resolution: {integrity: sha512-eFuaLoy/Rxalv2kr+lqMlUnrDWV+3j4pljOIJgLIhI058IQfWJ7vXhyEIHu+HtC738klGALYxOKDO0bQP3tg8A==}

  define-lazy-prop@2.0.0:
    resolution: {integrity: sha512-Ds09qNh8yw3khSjiJjiUInaGX9xlqZDY7JVryGxdxV7NPeuqQfplOpQ66yJFZut3jLa5zOwkXw1g9EI2uKh4Og==}
    engines: {node: '>=8'}

  depd@2.0.0:
    resolution: {integrity: sha512-g7nH6P6dyDioJogAAGprGpCtVImJhpPk/roCzdb3fIh61/s/nPsfR6onyMwkCAR/OlC3yBC0lESvUoQEAssIrw==}
    engines: {node: '>= 0.8'}

  destroy@1.2.0:
    resolution: {integrity: sha512-2sJGJTaXIIaR1w4iJSNoN0hnMY7Gpc/n8D4qSCJw8QqFWXf7cuAgnEHxBpweaVcPevC2l3KpjYCx3NypQQgaJg==}
    engines: {node: '>= 0.8', npm: 1.2.8000 || >= 1.4.16}

  detect-libc@2.1.2:
    resolution: {integrity: sha512-Btj2BOOO83o3WyH59e8MgXsxEQVcarkUOpEYrubB0urwnN10yQ364rsiByU11nZlqWYZm05i/of7io4mzihBtQ==}
    engines: {node: '>=8'}

  dnssd-advertise@1.1.6:
    resolution: {integrity: sha512-Ndrrf6BMPalkQPd/zubL+4YghH2J9NspapQ09uDXwYbvOPkP0oaqf5CkcwJ0b50kS2O3ul6yVu+jz+RY62Cejg==}

  ee-first@1.1.1:
    resolution: {integrity: sha512-WMwm9LhRUo+WUaRN+vRuETqG89IgZphVSNkdFgeb6sS/E4OrDIN7t48CAewSHXc6C8lefD8KKfr5vY61brQlow==}

  electron-to-chromium@1.5.459:
    resolution: {integrity: sha512-4SC9HHSFjO/liAhifpdOL5hG9b4BP7/5G3y3UPZVO8trlAXr1CaUEEJL0gWK3kOcYcZrOA5rkwG45Gra/lTIgg==}

  emoji-regex@8.0.0:
    resolution: {integrity: sha512-MSjYzcWNOA0ewAHpz0MxpYFvwg6yjy1NG3xteoqz644VCo/RPgnr1/GGt+ic3iJTzQ8Eu3TdM14SawnVUmGE6A==}

  encodeurl@1.0.2:
    resolution: {integrity: sha512-TPJXq8JqFaVYm2CWmPvnP2Iyo4ZSM7/QKcSmuMLDObfpH5fi7RUGmd/rTDf+rut/saiDiQEeVTNgAmJEdAOx0w==}
    engines: {node: '>= 0.8'}

  encodeurl@2.0.0:
    resolution: {integrity: sha512-Q0n9HRi4m6JuGIV1eFlmvJB7ZEVxu93IrMyiMsGC0lrMJMWzRgx6WGquyfQgZVb31vhGgXnfmPNNXmxnOkRBrg==}
    engines: {node: '>= 0.8'}

  error-stack-parser@2.1.4:
    resolution: {integrity: sha512-Sk5V6wVazPhq5MhpO+AUxJn5x7XSXGl1R93Vn7i+zS15KDVxQijejNCrz8340/2bgLBjR9GtEG8ZVKONDjcqGQ==}

  es-errors@1.3.0:
    resolution: {integrity: sha512-Zf5H2Kxt2xjTvbJvP2ZWLEICxA6j+hAmMzIlypy4xcBg1vKVnx89Wy0GbS+kf5cwCVFFzdCFh2XSCFNULS6csw==}
    engines: {node: '>= 0.4'}

  escalade@3.2.0:
    resolution: {integrity: sha512-WUj2qlxaQtO4g6Pq5c29GTcWGDyd8itL8zTlipgECz3JesAiiOKotd8JU6otB3PACgG6xkJUyVhboMS+bje/jA==}
    engines: {node: '>=6'}

  escape-html@1.0.3:
    resolution: {integrity: sha512-NiSupZ4OeuGwr68lGIeym/ksIZMJodUGOSCZ/FSnTxcrekbvqrgdUxlJOMpijaKZVjAJrWrGs/6Jy8OMuyj9ow==}

  escape-string-regexp@1.0.5:
    resolution: {integrity: sha512-vbRorB5FUQWvla16U8R/qgaFIya2qGzwDrNmCZuYKrbdSUMG6I1ZCGQRefkRVhuOkIGVne7BQ35DSfo1qvJqFg==}
    engines: {node: '>=0.8.0'}

  etag@1.8.1:
    resolution: {integrity: sha512-aIL5Fx7mawVa300al2BnEE4iNvo1qETxLrPI/o05L7z6go7fCw1J6EQmbK4FmJ2AS7kgVF/KEZWufBfdClMcPg==}
    engines: {node: '>= 0.6'}

  expo-asset@58.0.16:
    resolution: {integrity: sha512-beR3uusLA+rFo+6Ug0L7FPR4b6y/37VwtYW2Jig/i+3Co+oyYCTnvVuFPWhb05W9TOZRxdHUEI569fVKIgtYAA==}
    peerDependencies:
      expo: '*'
      react: '*'
      react-native: '*'

  expo-constants@58.0.12:
    resolution: {integrity: sha512-d3/dsps32nU4m6YJQbXQ1dIfn58GxfmJjTnZ0WtnhdSHTdG/oVsOakLqYRlX/FaLUKkQOSHXMf7hyCx+2a/HSQ==}
    peerDependencies:
      expo: '*'
      react-native: '*'

  expo-crypto@58.0.7:
    resolution: {integrity: sha512-g+4i4UpqQ5jNy1VPRvVVvr9aIdh8WwvxbpwL2ntiSESDRsXyVSeb8JM6tHVdC3b9J2nGxjtrhrsaWOo0jbSxlA==}
    peerDependencies:
      expo: '*'

  expo-dev-client@58.0.14:
    resolution: {integrity: sha512-gyzONNNS/SLZdxFdDshgzc0Uxxt2i+MjYwOQX3LNvr3pXFtYHYM9kza8MpdYOqhqGvWnA4BebeBWq3T1hjt9nQ==}
    peerDependencies:
      expo: '*'

  expo-dev-launcher@58.0.14:
    resolution: {integrity: sha512-RFgP59Tesnr3wBPj4B82Qwx2k0355VkVmHuovzwfmuti22pWhJvNhdr2aR7BokQ5U6z2Vm4HAz6NjRE+xBIFPA==}
    peerDependencies:
      expo: '*'
      react-native: '*'

  expo-dev-menu-interface@58.0.1:
    resolution: {integrity: sha512-XdjO3ZZhEq1dXm15GVtzQ0SXxSTPguJIDZib3Z8tAf2jLxfPUlQObgO/0hdnw7ssEBhTT2jQo2HAfnOSGUfj8w==}
    peerDependencies:
      expo: '*'

  expo-dev-menu@58.0.11:
    resolution: {integrity: sha512-kOqJ2wGsmM+tYf96mEy06WSBbX/cOx2KgmaouuqQX24/zpBPKlcLUQGgV75iGBXIxS6sczBO7qBp/MifFOud3w==}
    peerDependencies:
      expo: '*'
      react-native: '*'

  expo-document-picker@58.0.4:
    resolution: {integrity: sha512-rxs+9RrpI55/BEGNB/3sXjoBG6yZDLyn6Z7KzjbbBLdX8bE2cZT4IozQ3Q5wufaEEeaHQn48EgPiuMoTsAidpg==}
    peerDependencies:
      expo: '*'

  expo-file-system@58.0.9:
    resolution: {integrity: sha512-JT0km3Wa+wDz/7Rli8ifreoMnmk68ulf/uaWzRA26xm/4K+jGTY+cDhnboRmpmXUCBkED6uqxWmNoXjaVU9VUw==}
    peerDependencies:
      expo: '*'
      react-native: '*'

  expo-font@58.0.8:
    resolution: {integrity: sha512-i9HKj/ljdmmjLamYQEkI4wXJB9+ap7AG5CpCqK/bgwwy45y5T8+1lpNbYgRXE7aQgmDjPpzd09wX6dOZkHfrxg==}
    peerDependencies:
      expo: '*'
      react: '*'
      react-native: '*'

  expo-json-utils@58.0.1:
    resolution: {integrity: sha512-jNHNElOUPz2/vW3CbDKRn6tTF6eE9wwVbh/Isnqp5c/CdTcONzFVR3YHN3WQ05PnkmieyEqVfeOusOd1X9FDtQ==}

  expo-keep-awake@58.0.3:
    resolution: {integrity: sha512-wLRF+XeVsD/Rt/ZyX+A0mk1brdf8vefWizNAPzqV5eOCgkj23LCRZdN8gUi5X8UwyR8UJ7Y7Dzdz4YDGB/4c9Q==}
    peerDependencies:
      expo: '*'
      react: '*'

  expo-manifests@58.0.1:
    resolution: {integrity: sha512-fVeJJ71Fj8FJgcAUggn6QIsm7CTxsXFgekLl4pEPHgON6fmcxog63FGO0sisQ3F6yUWFR4nn8iJmgBp1Exs7ew==}
    peerDependencies:
      expo: '*'

  expo-modules-autolinking@58.0.13:
    resolution: {integrity: sha512-uzLFoTnAKabUdITvzRqWTvFkZsOdRPEXj7AEMAuBEhA2kGhqaBDa2EOWqPXVay0QJVoZuIQaEEgPGAXN1dPuYg==}
    hasBin: true

  expo-modules-core@58.0.22:
    resolution: {integrity: sha512-T3YJYziFkF4JlGDpX4zCl91oIxz1Skq5sp1LFVO+GL/BARSIXk013QWGdRZrvt+wMxoVaql5dpOdPdP5q2+0jQ==}
    peerDependencies:
      react: '*'
      react-native: '*'
      react-native-worklets: '>=0.13.0'
    peerDependenciesMeta:
      react-native-worklets:
        optional: true

  expo-modules-jsi@58.0.15:
    resolution: {integrity: sha512-PsjYgL4KWtvBqWH242r0wbP99VjgHkHCpkPCekO7nzb+ulkDNyrNnhysxa0TcNpfRTNLetmCUaLs9t4CcoquZQ==}
    peerDependencies:
      react-native: '*'

  expo-modules-macros@0.20.0:
    resolution: {integrity: sha512-Ekgb5c9LQPM9CPnmDZdeWcOa1eBbCDUGrgdN5lIFNH2GWDUf9doeAOK7IqQOOVviamy37eIp5FW+N1zyrIwzoA==}

  expo-server@58.0.5:
    resolution: {integrity: sha512-FHYecxfGOuAhacHcanR6qCN8Cln9S+FFulcYetLu3ddDg55ohuCsMZ9U4Egzwdm+A2o6N+MdSoJKquBC5F9NIg==}
    engines: {node: ^22.13.0 || ^24.3.0 || ^26.0.0 || >=27.0.0}

  expo-updates-interface@58.0.1:
    resolution: {integrity: sha512-OF+3BtMXtUsXWDfpHVNus9yHpx7WjMwjxDfeeN9LQBYSq/UtYmNNHBSfzChYTuqljWFSOAHRfsDykV9EB73Wlg==}
    peerDependencies:
      expo: '*'

  expo@58.0.14:
    resolution: {integrity: sha512-M05O++KRgG4NA6kQ9AP60kbN8xqHJ6S8uTXdtkeiwcGVIYzdu2kaUXJyraVturvePO/Mf4PWa0C9+JggrHITwA==}
    engines: {node: ^22.13.0 || ^24.3.0 || ^26.0.0 || >=27.0.0}
    hasBin: true
    peerDependencies:
      '@expo/dom-webview': '*'
      '@expo/metro-runtime': '*'
      react: '*'
      react-dom: '*'
      react-native: '*'
      react-native-web: '*'
      react-native-webview: '*'
    peerDependenciesMeta:
      '@expo/dom-webview':
        optional: true
      '@expo/metro-runtime':
        optional: true
      react-dom:
        optional: true
      react-native-web:
        optional: true
      react-native-webview:
        optional: true

  exponential-backoff@3.1.3:
    resolution: {integrity: sha512-ZgEeZXj30q+I0EN+CbSSpIyPaJ5HVQD18Z1m+u1FXbAeT94mr1zw50q4q6jiiC447Nl/YTcIYSAftiGqetwXCA==}

  fb-dotslash@0.5.8:
    resolution: {integrity: sha512-XHYLKk9J4BupDxi9bSEhkfss0m+Vr9ChTrjhf9l2iw3jB5C7BnY4GVPoMcqbrTutsKJso6yj2nAB6BI/F2oZaA==}
    engines: {node: '>=20'}
    hasBin: true

  fb-watchman@2.0.4:
    resolution: {integrity: sha512-tGQtaoYisPDriJBN0mT5yZSyNETnJGA1gTYxaVRAE5KUO3LI9kPUc9WIu8JXcxaIci+faIKlzXqXyPgrmubtBQ==}

  fdir@6.5.0:
    resolution: {integrity: sha512-tIbYtZbucOs0BRGqPJkshJUYdL+SDH7dVM8gjy+ERp3WAUjLEFJE+02kanyHtwjWOnwrKYBiwAmM0p4kLJAnXg==}
    engines: {node: '>=12.0.0'}
    peerDependencies:
      picomatch: ^3 || ^4
    peerDependenciesMeta:
      picomatch:
        optional: true

  fetch-nodeshim@0.4.10:
    resolution: {integrity: sha512-m6I8ALe4L4XpdETy7MJZWs6L1IVMbjs99bwbpIKphxX+0CTns4IKDWJY0LWfr4YsFjfg+z1TjzTMU8lKl8rG0w==}

  fill-range@7.1.1:
    resolution: {integrity: sha512-YsGpe3WHLK8ZYi4tWDg2Jy3ebRz2rXowDxnld4bkQB00cc/1Zw9AWnC0i9ztDJitivtQvaI9KaLyKrc+hBW0yg==}
    engines: {node: '>=8'}

  finalhandler@1.1.2:
    resolution: {integrity: sha512-aAWcW57uxVNrQZqFXjITpW3sIUQmHGG3qSb9mUah9MgMC4NeWhNOlNjXEYq3HjRAvL6arUviZGGJsBg6z0zsWA==}
    engines: {node: '>= 0.8'}

  flow-enums-runtime@0.0.6:
    resolution: {integrity: sha512-3PYnM29RFXwvAN6Pc/scUfkI7RwhQ/xqyLUyPNlXUp9S40zI8nup9tUSrTLSVnWGBN38FNiGWbwZOB6uR4OGdw==}

  flow-estree@0.327.0:
    resolution: {integrity: sha512-f9vK751YUzD0qaHSpKc5/qQM6gqOlgGS+4ZRqTNcZOpVqn3mC55yEQ6dUG2K1eaVm5FbKkz9CFWe6XNvrkQFQg==}
    engines: {node: '>=18'}

  flow-estree@0.331.0:
    resolution: {integrity: sha512-FVLYkSL/ITb/QXBEQvNWPjPooRGswuUtGOwrH+puSlMDneNkxy640+FZsk/TfKL+b7Wbw/Fg9FTUv2bMQDpj2w==}
    engines: {node: '>=18'}

  flow-parser@0.327.0:
    resolution: {integrity: sha512-/MYZ5hXWf5ozpbdfUDmazMgQXviLxWEiRLH3MppEGDdW0itRVqmB5UaU7QX+SBCDNiq+gEesSVn8nlxmPDyDkw==}
    engines: {node: '>=0.4.0'}

  flow-parser@0.331.0:
    resolution: {integrity: sha512-vEZcHIlnKeN8JSVtYFczj8sWJfHIJOkz+YG00O/oul/Bete+t1ZhTi+O6JRRLFYvGW+yJkZ0YgL16iStnbkUqQ==}
    engines: {node: '>=0.4.0'}

  fresh@0.5.2:
    resolution: {integrity: sha512-zJ2mQYM18rEFOudeV4GShTGIQ7RbzA7ozbU9I/XBpm7kqgMywgmylMwXHxZJmkVoYkna9d2pVXVXPdYTP9ej8Q==}
    engines: {node: '>= 0.6'}

  function-bind@1.1.2:
    resolution: {integrity: sha512-7XHNxH7qX9xG5mIwxkhumTox/MIRNcOgDrxWsMt2pAr23WHp6MrRlN7FBSFpCpr+oVO0F744iUgR82nJMfG2SA==}

  gensync@1.0.0-beta.2:
    resolution: {integrity: sha512-3hN7NaskYvMDLQY55gnW3NQ+mesEAepTqlg+VEbj7zzqEMBVNhzcGYYeqFo/TlYz6eQiFcp1HcsCZO+nGgS8zg==}
    engines: {node: '>=6.9.0'}

  get-caller-file@2.0.5:
    resolution: {integrity: sha512-DyFP3BM/3YHTQOCUL/w0OZHR0lpKeGrxotcHWcqNEdnltqFwXVfhEBQ94eIo34AfQpo0rGki4cyIiftY06h2Fg==}
    engines: {node: 6.* || 8.* || >= 10.*}

  getenv@2.0.0:
    resolution: {integrity: sha512-VilgtJj/ALgGY77fiLam5iD336eSWi96Q15JSAG1zi8NRBysm3LXKdGnHb4m5cuyxvOLQQKWpBZAT6ni4FI2iQ==}
    engines: {node: '>=6'}

  glob@13.0.6:
    resolution: {integrity: sha512-Wjlyrolmm8uDpm/ogGyXZXb1Z+Ca2B8NbJwqBVg0axK9GbBeoS7yGV6vjXnYdGm6X53iehEuxxbyiKp8QmN4Vw==}
    engines: {node: 18 || 20 || >=22}

  graceful-fs@4.2.11:
    resolution: {integrity: sha512-RbJ5/jmFcNNCcDV5o9eTnBLJ/HszWV0P73bc+Ff4nS/rJj+YaS6IGyiOL0VoBYX+l1Wrl3k63h/KrH+nhJ0XvQ==}

  has-flag@3.0.0:
    resolution: {integrity: sha512-sKJf1+ceQBr4SMkvQnBDNDtf4TXpVhVGateu0t918bl30FnbE2m4vNLX+VWe/dpjlb+HugGYzW7uQXH98HPEYw==}
    engines: {node: '>=4'}

  has-flag@4.0.0:
    resolution: {integrity: sha512-EykJT/Q1KjTWctppgIAgfSO0tKVuZUjhgMr17kqTumMl6Afv3EISleU7qZUzoXDFTAHTDC4NOoG/ZxU3EvlMPQ==}
    engines: {node: '>=8'}

  hasown@2.0.4:
    resolution: {integrity: sha512-T2UbfbBEF32wiepXIsMlTW9+dDYC6wMh/t/vYA4tuOMKqWz/n3vr1NFSxQiyP+zk2mXsoMA/i/7qV6LKut1t1A==}
    engines: {node: '>= 0.4'}

  hermes-compiler@260318099.0.4:
    resolution: {integrity: sha512-8odcPFkPC82HlqCl0C5QI9mBN4rEAT+IAo55sJhzwKw//K3qZloiv3ex6J2O8CuBbhdmkJozfidNsset2KH25w==}

  hermes-estree@0.36.1:
    resolution: {integrity: sha512-guv1nQ6IJ7S83NRFPWc3SA7IBZrdNC9kapwOq6uXvF4wP+sDCgjzQbKPCoyYmoyZRzztF/n/c36l/rccCZSiCw==}

  hermes-parser@0.36.1:
    resolution: {integrity: sha512-GApNk4zLHi2UWoWZZkx7LNCOSzLSc5lB55pZ/PhK7ycFeg7u5LcF88p/WbpIi1XUDtE0MpHE3uRR3u3KB7TjSQ==}

  hosted-git-info@7.0.2:
    resolution: {integrity: sha512-puUZAUKT5m8Zzvs72XWy3HtvVbTWljRE66cP60bxJzAqf2DgICo7lYTY2IHUmLnNpjYvw5bvmoHvPc0QO2a62w==}
    engines: {node: ^16.14.0 || >=18.0.0}

  http-errors@2.0.1:
    resolution: {integrity: sha512-4FbRdAX+bSdmo4AUFuS0WNiPz8NgFt+r8ThgNWmlrjQjt1Q7ZR9+zTlce2859x4KSXrwIsaeTqDoKQmtP8pLmQ==}
    engines: {node: '>= 0.8'}

  https-proxy-agent@7.0.6:
    resolution: {integrity: sha512-vK9P5/iUfdl95AI+JVyUuIcVtd4ofvtrOr3HNtM2yxC9bnMbEdp3x01OhQNnjb8IJYi38VlTE3mBXwcfvywuSw==}
    engines: {node: '>= 14'}

  ignore@5.3.2:
    resolution: {integrity: sha512-hsBTNUqQTDwkWtcdYI2i06Y/nUBEsNEDJKjWdigLvegy8kDuJAS8uRlpkkcQpyEXL0Z/pjDy5HBmMjRCJ2gq+g==}
    engines: {node: '>= 4'}

  inherits@2.0.4:
    resolution: {integrity: sha512-k/vGaX4/Yla3WzyMCvTQOXYeIHvqOKtnqBduzTHpzpQZzAskKMhZ2K+EnBiSM9zGSoIFeMpXKxa4dYeZIQqewQ==}

  invariant@2.2.4:
    resolution: {integrity: sha512-phJfQVBuaJM5raOpJjSfkiD6BpbCE4Ns//LaXl6wGYtUBY83nWS6Rf9tXm2e8VaK60JEjYldbPif/A2B1C2gNA==}

  is-core-module@2.17.0:
    resolution: {integrity: sha512-J/vG0zBCbIKOQFfufSwyXdMrsohyJIUNkrnmo6WZGzoM7tr/lsbfW5b2BvisL6zsyMzK9UxV9L6c7AoFbyXHOA==}
    engines: {node: '>= 0.4'}

  is-docker@2.2.1:
    resolution: {integrity: sha512-F+i2BKsFrH66iaUFc0woD8sLy8getkwTwtOBjvs56Cx4CgJDeKQeqfz8wAYiSb8JOprWhHH5p77PbmYCvvUuXQ==}
    engines: {node: '>=8'}
    hasBin: true

  is-fullwidth-code-point@3.0.0:
    resolution: {integrity: sha512-zymm5+u+sCsSWyD9qNaejV3DFvhCKclKdizYaJUuHA83RLjb7nSuGnddCHGv0hk+KY7BMAlsWeK4Ueg6EV6XQg==}
    engines: {node: '>=8'}

  is-number@7.0.0:
    resolution: {integrity: sha512-41Cifkg6e8TylSpdtTpeLVMqvSBEVzTttHvERD741+pnZ8ANv0004MRL43QKPDlK9cGvNp6NZWZUBlbGXYxxng==}
    engines: {node: '>=0.12.0'}

  is-wsl@2.2.0:
    resolution: {integrity: sha512-fKzAra0rGJUUBwGBgNkHZuToZcn+TtXHpeCgmkMJMMYx1sQDYaCSyjJBSCa2nH1DGm7s3n1oBnohoVTBaN7Lww==}
    engines: {node: '>=8'}

  isexe@2.0.0:
    resolution: {integrity: sha512-RHxMLp9lnKHGHRng9QFhRCMbYAcVpn69smSGcq3f36xjgVVWThj4qqLbTLlq7Ssj8B+fIQ1EuCEGI2lKsyQeIw==}

  jest-get-type@29.6.3:
    resolution: {integrity: sha512-zrteXnqYxfQh7l5FHyL38jL39di8H8rHoecLH3JNxH3BwOrBsNeabdap5e0I23lD4HHI8W5VFBZqG4Eaq5LNcw==}
    engines: {node: ^14.15.0 || ^16.10.0 || >=18.0.0}

  jest-util@29.7.0:
    resolution: {integrity: sha512-z6EbKajIpqGKU56y5KBUgy1dt1ihhQJgWzUlZHArA/+X2ad7Cb5iF+AK1EWVL/Bo7Rz9uurpqw6SiBCefUbCGA==}
    engines: {node: ^14.15.0 || ^16.10.0 || >=18.0.0}

  jest-validate@29.7.0:
    resolution: {integrity: sha512-ZB7wHqaRGVw/9hST/OuFUReG7M8vKeq0/J2egIGLdvjHCmYqGARhzXmtgi+gVeZ5uXFF219aOc3Ls2yLg27tkw==}
    engines: {node: ^14.15.0 || ^16.10.0 || >=18.0.0}

  jest-worker@29.7.0:
    resolution: {integrity: sha512-eIz2msL/EzL9UFTFFx7jBTkeZfku0yUAyZZZmJ93H2TYEiroIx2PQjEXcwYtYl8zXCxb+PAmA2hLIt/6ZEkPHw==}
    engines: {node: ^14.15.0 || ^16.10.0 || >=18.0.0}

  jimp-compact@0.16.1:
    resolution: {integrity: sha512-dZ6Ra7u1G8c4Letq/B5EzAxj4tLFHL+cGtdpR+PVm4yzPDj+lCk+AbivWt1eOM+ikzkowtyV7qSqX6qr3t71Ww==}

  js-tokens@4.0.0:
    resolution: {integrity: sha512-RdJUflcE3cUzKiMqQgsCu06FPu9UdIJO0beYbPhHN4k6apgJtifcoCtT9bcxOpYBtpD2kCM6Sbzg4CausW/PKQ==}

  js-yaml@4.3.2:
    resolution: {integrity: sha512-SFNOvSJ+Dgf/9An904Yx+CgSlIPCkIpao4qo51lpee25TIRejdH3rhR4EZMGoNx3/TP3O+wzWuiTFl4sqbltzA==}
    hasBin: true

  jsc-safe-url@0.2.4:
    resolution: {integrity: sha512-0wM3YBWtYePOjfyXQH5MWQ8H7sdk5EXSwZvmSLKk2RboVQ2Bu239jycHDz5J/8Blf3K0Qnoy2b6xD+z10MFB+Q==}

  jsesc@3.1.0:
    resolution: {integrity: sha512-/sM3dO2FOzXjKQhJuo0Q173wf2KOo8t4I8vHy6lF9poUp7bKT0/NHE8fPX23PwfhnykfqnC2xRxOnVw5XuGIaA==}
    engines: {node: '>=6'}
    hasBin: true

  json5@2.2.3:
    resolution: {integrity: sha512-XmOWe7eyHYH14cLdVPoyg+GOH3rYX++KpzrylJwSW98t3Nk+U8XOl8FWKOgwtzdb8lXGf6zYwDUzeHMWfxasyg==}
    engines: {node: '>=6'}
    hasBin: true

  kleur@3.0.3:
    resolution: {integrity: sha512-eTIzlVOSUR+JxdDFepEYcBMtZ9Qqdef+rnzWdRZuMbOywu5tO2w2N7rqjoANZ5k9vywhL6Br1VRjUIgTQx4E8w==}
    engines: {node: '>=6'}

  lan-network@0.2.1:
    resolution: {integrity: sha512-ONPnazC96VKDntab9j9JKwIWhZ4ZUceB4A9Epu4Ssg0hYFmtHZSeQ+n15nIwTFmcBUKtExOer8WTJ4GF9MO64A==}
    hasBin: true

  leven@3.1.0:
    resolution: {integrity: sha512-qsda+H8jTaUaN/x5vzW2rzc+8Rw4TAQ/4KjB46IwK5VH+IlVeeeje/EoZRpiXvIqjFgK84QffqPztGI3VBLG1A==}
    engines: {node: '>=6'}

  lightningcss-android-arm64@1.33.0:
    resolution: {integrity: sha512-gEpRTalKdosp4Bb8qWtc2iOgE5SeIHlpS1up9bFq2wAyYhl1UdTObYiHe98zEM9SQvSoqQZ1IQD0JNpg3Ml5pg==}
    engines: {node: '>= 12.0.0'}
    cpu: [arm64]
    os: [android]

  lightningcss-darwin-arm64@1.33.0:
    resolution: {integrity: sha512-Sciaz8eenNTKn9b3t7+xr0ipTp9YxKQY4npwQ3mrRuL0BAVHBLyZxofhaKBAVtzmtRZ/zTyo0/to4B1uWG/Djg==}
    engines: {node: '>= 12.0.0'}
    cpu: [arm64]
    os: [darwin]

  lightningcss-darwin-x64@1.33.0:
    resolution: {integrity: sha512-Z5UPAxzrjlWNNyGy6i65cJzzvgJ5D3T6wMvs+gWpY9d7qRhANrxqAp6LhxIgZhWEw18RfJTGcRxjuLIBr+m8XQ==}
    engines: {node: '>= 12.0.0'}
    cpu: [x64]
    os: [darwin]

  lightningcss-freebsd-x64@1.33.0:
    resolution: {integrity: sha512-QQM/Ti/hQajJwCY+RiWuCZ9sdtI/XQk7nDK5vC8kkdwixezOlDgvDx7+RT+QjK6FcFT4MpsuoBnHIo/O3StRRg==}
    engines: {node: '>= 12.0.0'}
    cpu: [x64]
    os: [freebsd]

  lightningcss-linux-arm-gnueabihf@1.33.0:
    resolution: {integrity: sha512-N7FVBe6iS24MlM6R/4RBTxGhQheZGs7tiQ9U32UtF75NzP5Q7xWPRqLBCKxlRQRk3rY1jCIPLzx7WzOhuUIRLQ==}
    engines: {node: '>= 12.0.0'}
    cpu: [arm]
    os: [linux]

  lightningcss-linux-arm64-gnu@1.33.0:
    resolution: {integrity: sha512-j2v/itmy4HlNxlc6voKXYgBqNi0Ng2LShg4z7GufpEgs05P+2suBVyi9I6YHq5uoVFx9ETin3eCEhLVyXGQnKg==}
    engines: {node: '>= 12.0.0'}
    cpu: [arm64]
    os: [linux]
    libc: [glibc]

  lightningcss-linux-arm64-musl@1.33.0:
    resolution: {integrity: sha512-yiO5ROMuYQgXbC60yjZU5CYSFZGKXL0HFATXt9mHJn1+zW55oCtMI9NfcVhYLMFDL7gV7oBPon/EmMMGg2OvtQ==}
    engines: {node: '>= 12.0.0'}
    cpu: [arm64]
    os: [linux]
    libc: [musl]

  lightningcss-linux-x64-gnu@1.33.0:
    resolution: {integrity: sha512-ar+Ju7LmcN0Jo4FpL4hpFybwNG9/3A/Br5KW2n2jyODg3MEZXaDYADdemoNS+BDNfMgKvylJLj4S5tyRActuAg==}
    engines: {node: '>= 12.0.0'}
    cpu: [x64]
    os: [linux]
    libc: [glibc]

  lightningcss-linux-x64-musl@1.33.0:
    resolution: {integrity: sha512-RYiYbkokw0trfKqqzfF55lginwEPrD3OJDfTuJzFs1MK6iFnDenaz1fqLLtX4ITG3OktJQXOeTaw1awrBAlZPw==}
    engines: {node: '>= 12.0.0'}
    cpu: [x64]
    os: [linux]
    libc: [musl]

  lightningcss-win32-arm64-msvc@1.33.0:
    resolution: {integrity: sha512-1K+MPfLSFVpphzpdbfkhlWk6wBrTObBzS2T6db10PNOZgR9GoVsAWzwNyuhUYYbTp23j+4RrncfujZ4uAzXvwA==}
    engines: {node: '>= 12.0.0'}
    cpu: [arm64]
    os: [win32]

  lightningcss-win32-x64-msvc@1.33.0:
    resolution: {integrity: sha512-OlEICDx/Xl0FqSp4bry8zFnCvGpig3Gl4gCquvYwHuqJKEC1+n9NgDniFvqHGmMv1ZkqDJrDqKKSykTDX+ehuA==}
    engines: {node: '>= 12.0.0'}
    cpu: [x64]
    os: [win32]

  lightningcss@1.33.0:
    resolution: {integrity: sha512-WkUDrojuJs0xkgGf2udWxa3yGBRxPtxUkB79i6aCZLRgc7PM8fZe9TosfPDcvEpQZbuFASnHYmRLBLUbmLOIIA==}
    engines: {node: '>= 12.0.0'}

  lodash.debounce@4.0.8:
    resolution: {integrity: sha512-FT1yDzDYEoYWhnSGnpE/4Kj1fLZkDFyqRb7fNt6FdYOSxlUWAtp42Eh6Wb0rGIv/m9Bgo7x4GhQbm5Ys4SG5ow==}

  lodash.throttle@4.1.1:
    resolution: {integrity: sha512-wIkUCfVKpVsWo3JSZlc+8MB5it+2AN5W8J7YVMST30UrvcQNZ1Okbj+rbVniijTWE6FGYy4XJq/rHkas8qJMLQ==}

  log-symbols@2.2.0:
    resolution: {integrity: sha512-VeIAFslyIerEJLXHziedo2basKbMKtTw3vfn5IzG0XTjhAVEJyNHnL2p7vc+wBDSdQuUpNw3M2u6xb9QsAY5Eg==}
    engines: {node: '>=4'}

  loose-envify@1.4.0:
    resolution: {integrity: sha512-lyuxPGr/Wfhrlem2CL/UcnUc1zcqKAImBDzukY7Y5F/yQiNdko6+fRLevlw1HgMySw7f611UIY408EtxRSoK3Q==}
    hasBin: true

  lru-cache@10.4.3:
    resolution: {integrity: sha512-JNAzZcXrCt42VGLuYz0zfAzDfAvJWW6AfYlDBQyDV5DClI2m5sAmK+OIO7s59XfsRsWHp02jAJrRadPRGTt6SQ==}

  lru-cache@11.5.3:
    resolution: {integrity: sha512-U4N8FgzmWxc8k1VH8Kr6lQg18U7Fjvby6wXHVRX/ZZ7IwWbRMgrRbP0Wrb5q5NVinryp4SQampHKdvtecItxUg==}
    engines: {node: 20 || >=22}

  lru-cache@5.1.1:
    resolution: {integrity: sha512-KpNARQA3Iwv+jTA0utUVVbrh+Jlrr1Fv0e56GGzAFOXN7dk/FviaDW8LHmK52DlcH4WP2n6gI8vN1aesBFgo9w==}

  makeerror@1.0.12:
    resolution: {integrity: sha512-JmqCvUhmt43madlpFzG4BQzG2Z3m6tvQDNKdClZnO3VbIudJYmxsT0FNJMeiB2+JTSlTQTSbU8QdesVmwJcmLg==}

  memoize-one@5.2.1:
    resolution: {integrity: sha512-zYiwtZUcYyXKo/np96AGZAckk+FWWsUdJ3cHGGmld7+AhvcWmQyGCYUh1hc4Q/pkOhb65dQR/pqCyK0cOaHz4Q==}

  merge-stream@2.0.0:
    resolution: {integrity: sha512-abv/qOcuPfk3URPfDzmZU1LKmuw8kT+0nIHvKrKgFrwifol/doWcdA4ZqsWQ8ENrFKkd67Mfpo/LovbIUsbt3w==}

  metro-babel-transformer@0.87.1:
    resolution: {integrity: sha512-orvRIGpb0yK1yMbk5YP3dhVKjmoxUkRB9fdltGJxNppEqus/1tFpNuf9KnGFR3Qjg0izoUrJ4z6WgoBvdkXPrA==}
    engines: {node: ^22.13.0 || ^24.3.0 || >= 26.0.0}

  metro-cache-key@0.87.1:
    resolution: {integrity: sha512-scqVVPMA2c+RVO12I3wyMDp5xCkRPLsyrcG4Qc3xfU5JR0EW/0sz2tjty+5UjMUtG09uiM1KYQ8HjWg7OQXHtw==}
    engines: {node: ^22.13.0 || ^24.3.0 || >= 26.0.0}

  metro-cache@0.87.1:
    resolution: {integrity: sha512-juNPaj0Xi5tkLp8imXqvbSnEIijwKG36m7OiFFVJMqEkiURwAjkMFVek3/xpix1+LVQqO7kjVp3PvuvIM61mKQ==}
    engines: {node: ^22.13.0 || ^24.3.0 || >= 26.0.0}

  metro-config@0.87.1:
    resolution: {integrity: sha512-NmkDlc/qZAdo5gTkVTuO2AKE/khemRKRH5IA+SKfqUBJigI5GqZ5TOXhmEokhlkAqzjt8dyzKhzI6FHvXoXaTQ==}
    engines: {node: ^22.13.0 || ^24.3.0 || >= 26.0.0}

  metro-core@0.87.1:
    resolution: {integrity: sha512-xizzky/4+c/Mkznege8OW05j7bSdM39VPoEps61Se4+hf32UQujmbvLvIE9+UnP6kNEPVomk0Fw8NsBK9iRQmw==}
    engines: {node: ^22.13.0 || ^24.3.0 || >= 26.0.0}

  metro-file-map@0.87.1:
    resolution: {integrity: sha512-9sPuNCojC3pS4vj+ZPY7FXmHGpdJeckXuKXQrDAfJvZc60AF8owRFTkI8XdwlwrmPIB2w++KraK9FMEXvC4wJw==}
    engines: {node: ^22.13.0 || ^24.3.0 || >= 26.0.0}

  metro-minify-terser@0.87.1:
    resolution: {integrity: sha512-YK4k1oO1wV48hfE+Nbw2rJCnAgeabzrgT/xH5ha5n9gbK4p3HYFC898cERUiyTl9vRh58CNTiXRc88f7y6PfKg==}
    engines: {node: ^22.13.0 || ^24.3.0 || >= 26.0.0}

  metro-resolver@0.87.1:
    resolution: {integrity: sha512-FXH/brY69wT6sPxaSW8BhMmDGD/6irmBr/cL4rUi+VWwqR3pbvdcfUOfyjcHucgQ7pe5IW3xJY21eHKLVKNumQ==}
    engines: {node: ^22.13.0 || ^24.3.0 || >= 26.0.0}

  metro-runtime@0.87.1:
    resolution: {integrity: sha512-kjeuSvInsM6OzBjkCQsWxnkrKZFMKtnkCl38oXWRI9lDGs2L9hGs9Tak9sQYJ9h3gtDujneB7wZio+irgqJKDw==}
    engines: {node: ^22.13.0 || ^24.3.0 || >= 26.0.0}

  metro-source-map@0.87.1:
    resolution: {integrity: sha512-Bqpm0PBGdy53pigIJb4HRF7QxD2pUOdgSmVh/4AWbP635kSCv+Y6ltVxUZgSnzS/QbSmzyCGijmRPlXMj2/qHw==}
    engines: {node: ^22.13.0 || ^24.3.0 || >= 26.0.0}

  metro-symbolicate@0.87.1:
    resolution: {integrity: sha512-rcGvwabrg0lbXGRGRKl14PY3My3+dkno2jZYhdJEuH2DmjTtTkV5bYwgto4JtV/Lbe+sXE6GO1UGg654430uow==}
    engines: {node: ^22.13.0 || ^24.3.0 || >= 26.0.0}
    hasBin: true

  metro-transform-plugins@0.87.1:
    resolution: {integrity: sha512-qMiJ/x+VfqumFJJSefKS6nj8uojzC29b2/aK8vlMuFABIqGjDucICEOXd2Yt6k/XMFAgAcaJvShUOT0HLyYaPw==}
    engines: {node: ^22.13.0 || ^24.3.0 || >= 26.0.0}

  metro-transform-worker@0.87.1:
    resolution: {integrity: sha512-VOzs3OV405FuOLYdAhqA2wsn1F9lvueDVxMDLvCKaQ44U+yknIqphJ9eMjjsGwLDZiJq9sW3DMLhjD27JxQgqQ==}
    engines: {node: ^22.13.0 || ^24.3.0 || >= 26.0.0}

  metro@0.87.1:
    resolution: {integrity: sha512-1oyLU9elM7hPAsKIqKooEekwxiuWr27+MZBhUROPhzcbXhMDxK64GPF/hCXwBZVp1F89ODavCrBmJtLx9WtBoQ==}
    engines: {node: ^22.13.0 || ^24.3.0 || >= 26.0.0}
    hasBin: true

  micromatch@4.0.8:
    resolution: {integrity: sha512-PXwfBhYu0hBCPw8Dn0E+WDYb7af3dSLVWKi3HGv84IdF4TyFoC0ysxFd0Goxw7nSv4T/PzEJQxsYsEiFCKo2BA==}
    engines: {node: '>=8.6'}

  mime-db@1.52.0:
    resolution: {integrity: sha512-sPU4uV7dYlvtWJxwwxHD0PuihVNiE7TyAbQ5SWxDCB9mUYvOgroQOwYQQOKPJ8CIbE+1ETVlOoK1UC2nU3gYvg==}
    engines: {node: '>= 0.6'}

  mime-db@1.54.0:
    resolution: {integrity: sha512-aU5EJuIN2WDemCcAp2vFBfp/m4EAhWJnUNSSw0ixs7/kXbd6Pg64EmwJkNdFhB8aWt1sH2CTXrLxo/iAGV3oPQ==}
    engines: {node: '>= 0.6'}

  mime-types@2.1.35:
    resolution: {integrity: sha512-ZDY+bPm5zTTF+YpCrAU9nK0UgICYPT0QtT1NZWFv4s++TNkcgVaT0g6+4R2uI4MjQjzysHB1zxuWL50hzaeXiw==}
    engines: {node: '>= 0.6'}

  mime-types@3.0.2:
    resolution: {integrity: sha512-Lbgzdk0h4juoQ9fCKXW4by0UJqj+nOOrI9MJ1sSj4nI8aI2eo1qmvQEie4VD1glsS250n15LsWsYtCugiStS5A==}
    engines: {node: '>=18'}

  mime@1.6.0:
    resolution: {integrity: sha512-x0Vn8spI+wuJ1O6S7gnbaQg8Pxh4NNHb7KSINmEWKiPE4RKOplvijn+NkmYmmRgP68mc70j2EbeTFRsrswaQeg==}
    engines: {node: '>=4'}
    hasBin: true

  mimic-fn@1.2.0:
    resolution: {integrity: sha512-jf84uxzwiuiIVKiOLpfYk7N46TSy8ubTonmneY9vrpHNAnp0QBt2BxWV9dO3/j+BoVAb+a5G6YDPW3M5HOdMWQ==}
    engines: {node: '>=4'}

  minimatch@10.2.6:
    resolution: {integrity: sha512-vpLQEs+VLCr1nU0BXS07maYoFwlDAH0gngQuuttxIwutDFEMHq2blX+8vpgxDdK3J1PwjCJiep77OitTZ4Ll1A==}
    engines: {node: 18 || 20 || >=22}

  minipass@7.1.3:
    resolution: {integrity: sha512-tEBHqDnIoM/1rXME1zgka9g6Q2lcoCkxHLuc7ODJ5BxbP5d4c2Z5cGgtXAku59200Cx7diuHTOYfSBD8n6mm8A==}
    engines: {node: '>=16 || 14 >=14.17'}

  ms@2.0.0:
    resolution: {integrity: sha512-Tpp60P6IUJDTuOq/5Z8cdskzJujfwqfOTkrwIwj7IRISpnkJnT6SyJ4PCPnGMoFjC9ddhal5KVIYtAt97ix05A==}

  ms@2.1.3:
    resolution: {integrity: sha512-6FlzubTLZG3J2a/NVCAleEhjzq5oxgHyaCU9yYXvcLsvoVaHJq/s5xXI6/XXP6tz7R9xAOtHnSO/tXtF3WRTlA==}

  multitars@1.0.2:
    resolution: {integrity: sha512-6GwVw5eLi9sThdtlS4PKwC7yRLaf45pYhIEzKBHdKxi+YOXGKFX8acIniH+Uh/+k9mS2lQOupTccjoe5r0/1IQ==}

  nanoid@3.3.20:
    resolution: {integrity: sha512-uKdg2G3GNCKQn9byYOpxbGqrT2fGO5KRt5J/8b3pok8rT6qxGWF6hxMyJiEYtAf+FVyYuD9hRaDqX5uPFYJ4ZQ==}
    engines: {node: ^10 || ^12 || ^13.7 || ^14 || >=15.0.1}
    hasBin: true

  negotiator@0.6.3:
    resolution: {integrity: sha512-+EUsqGPLsM+j/zdChZjsnX51g4XrHFOIXwfnCVPGlQk/k5giakcKsuxCObBRu6DSm9opw/O6slWbJdghQM4bBg==}
    engines: {node: '>= 0.6'}

  negotiator@0.6.4:
    resolution: {integrity: sha512-myRT3DiWPHqho5PrJaIRyaMv2kgYf0mUVgBNOYMuCH5Ki1yEiQaf/ZJuQ62nvpc44wL5WDbTX7yGJi1Neevw8w==}
    engines: {node: '>= 0.6'}

  negotiator@1.1.0:
    resolution: {integrity: sha512-NMPBRMJgiQHjbd8phG3Vebdx4kZ1H121rbl5IkMqeOsahptB9BKo/d7oJ3zTXqTgagn2bWlNSXkh0QUGM31RYg==}
    engines: {node: '>=18'}

  node-forge@1.4.0:
    resolution: {integrity: sha512-LarFH0+6VfriEhqMMcLX2F7SwSXeWwnEAJEsYm5QKWchiVYVvJyV9v7UDvUv+w5HO23ZpQTXDv/GxdDdMyOuoQ==}
    engines: {node: '>= 6.13.0'}

  node-int64@0.4.0:
    resolution: {integrity: sha512-O5lz91xSOeoXP6DulyHfllpq+Eg00MWitZIbtPfoSEvqIHdl5gfcY6hYzDWnj0qD5tz52PI08u9qUvSVeUBeHw==}

  node-releases@2.0.59:
    resolution: {integrity: sha512-5qr2okC4ItAI0hG5SaV0HoYMpnM/Y6+Oqr7AmPYy/2uEoGvS+GbSKLeRxSS1uAdu59yz0ouzcuXievSgg///WA==}
    engines: {node: '>=18'}

  noxcturnal@0.1.5:
    resolution: {integrity: sha512-X/HQXJP/xn7LVQ4z1E4La0NHSl5UHdtJPG6ky4r2/Xgb7k79nGDJgBXk7I5f1V2vInWjlSCM14oSB0cUxwZS/Q==}
    engines: {node: '>=18'}

  npm-package-arg@11.0.3:
    resolution: {integrity: sha512-sHGJy8sOC1YraBywpzQlIKBE4pBbGbiF95U6Auspzyem956E0+FtDtsx1ZxlOJkQCZ1AFXAY/yuvtFYrOxF+Bw==}
    engines: {node: ^16.14.0 || >=18.0.0}

  nullthrows@1.1.1:
    resolution: {integrity: sha512-2vPPEi+Z7WqML2jZYddDIfy5Dqb0r2fze2zTxNNknZaFpVHU3mFB3R+DWeJWGVx0ecvttSGlJTI+WG+8Z4cDWw==}

  ob1@0.87.1:
    resolution: {integrity: sha512-i8iA8uij0g1YQzS8uOJPSRCgwDjO9warIHUAu1Fqj877Wc3wlfxDYBioYWgKTBF2+URVJttyDWSEpmd99nlvtQ==}
    engines: {node: ^22.13.0 || ^24.3.0 || >= 26.0.0}

  on-finished@2.3.0:
    resolution: {integrity: sha512-ikqdkGAAyf/X/gPhXGvfgAytDZtDbr+bkNUJ0N9h5MI/dmdgCs3l6hoHrcUv41sRKew3jIwrp4qQDXiK99Utww==}
    engines: {node: '>= 0.8'}

  on-finished@2.4.1:
    resolution: {integrity: sha512-oVlzkg3ENAhCk2zdv7IJwd/QUD4z2RxRwpkcGY8psCVcCYZNq4wYnVWALHM+brtuJjePWiYF/ClmuDr8Ch5+kg==}
    engines: {node: '>= 0.8'}

  on-headers@1.1.0:
    resolution: {integrity: sha512-737ZY3yNnXy37FHkQxPzt4UZ2UWPWiCZWLvFZ4fu5cueciegX0zGPnrlY6bwRg4FdQOe9YU8MkmJwGhoMybl8A==}
    engines: {node: '>= 0.8'}

  onetime@2.0.1:
    resolution: {integrity: sha512-oyyPpiMaKARvvcgip+JV+7zci5L8D1W9RZIz2l1o08AM3pfspitVWnPt3mzHcBPp12oYMTy0pqrFs/C+m3EwsQ==}
    engines: {node: '>=4'}

  open@8.4.2:
    resolution: {integrity: sha512-7x81NCL719oNbsq/3mh+hVrAWmFuEYUqrq/Iw3kUzH8ReypT9QQ0BLoJS7/G9k6N81XjW4qHWtjWwe/9eLy1EQ==}
    engines: {node: '>=12'}

  ora@3.4.0:
    resolution: {integrity: sha512-eNwHudNbO1folBP3JsZ19v9azXWtQZjICdr3Q0TDPIaeBQ3mXLrh54wM+er0+hSp+dWKf+Z8KM58CYzEyIYxYg==}
    engines: {node: '>=6'}

  parse-png@2.1.0:
    resolution: {integrity: sha512-Nt/a5SfCLiTnQAjx3fHlqp8hRgTL3z7kTQZzvIMS9uCAepnCyjpdEc6M/sz69WqMBdaDBw9sF1F1UaHROYzGkQ==}
    engines: {node: '>=10'}

  parseurl@1.3.3:
    resolution: {integrity: sha512-CiyeOxFT/JZyN5m0z9PfXw4SCBJ6Sygz1Dpl0wqjlhDEGGBP1GnsUVEL0p63hoG1fcj3fHynXi9NYO4nWOL+qQ==}
    engines: {node: '>= 0.8'}

  path-key@3.1.1:
    resolution: {integrity: sha512-ojmeN0qd+y0jszEtoY48r0Peq5dwMEkIlCOu6Q5f41lfkswXuKtYrhgoTpLnyIcHm24Uhqx+5Tqm2InSwLhE6Q==}
    engines: {node: '>=8'}

  path-parse@1.0.7:
    resolution: {integrity: sha512-LDJzPVEEEPR+y48z93A0Ed0yXb8pAByGWo/k5YYdYgpY2/2EsOsksJrq7lOHxryrVOn1ejG6oAp8ahvOIQD8sw==}

  path-scurry@2.0.2:
    resolution: {integrity: sha512-3O/iVVsJAPsOnpwWIeD+d6z/7PmqApyQePUtCndjatj/9I5LylHvt5qluFaBT3I5h3r1ejfR056c+FCv+NnNXg==}
    engines: {node: 18 || 20 || >=22}

  picocolors@1.1.1:
    resolution: {integrity: sha512-xceH2snhtb5M9liqDsmEw56le376mTZkEX/jEb/RxNFyegNul7eNslCXP9FDj/Lcu0X8KEyMceP2ntpaHrDEVA==}

  picomatch@2.3.2:
    resolution: {integrity: sha512-V7+vQEJ06Z+c5tSye8S+nHUfI51xoXIXjHQ99cQtKUkQqqO1kO/KCJUfZXuB47h/YBlDhah2H3hdUGXn8ie0oA==}
    engines: {node: '>=8.6'}

  picomatch@4.0.7:
    resolution: {integrity: sha512-qcJu88Q2IWqJsDD529JKMdwGm/dvInW4HvQnRwiH9JtihJvzGOscDtHE3x1pBKeUOTysQ8kVmLnJ2kJu7yhcGA==}
    engines: {node: '>=12'}

  plist@3.1.1:
    resolution: {integrity: sha512-ZIfcLJC+7E7FBFnDxm9MPmt7D+DidyQ26lewieO75AdhA2ayMtsJSES0iWzqJQbcVRSrTufQoy0DR94xHue0oA==}
    engines: {node: '>=10.4.0'}

  pngjs@3.4.0:
    resolution: {integrity: sha512-NCrCHhWmnQklfH4MtJMRjZ2a8c80qXeMlQMv2uVp9ISJMTt562SbGd6n2oq0PaPgKm7Z6pL9E2UlLIhC+SHL3w==}
    engines: {node: '>=4.0.0'}

  postcss@8.5.30:
    resolution: {integrity: sha512-zkd+e9S1AQHhmaBKye9zlFHWjOwVgqXl1q3ECYy8561K7qxR2cREf/STLskulBFd78k6AOFeA+ff1TtEzk9bAA==}
    engines: {node: ^10 || ^12 || >=14}

  pretty-format@29.7.0:
    resolution: {integrity: sha512-Pdlw/oPxN+aXdmM9R00JVC9WVFoCLTKJvDVLgmJ+qAffBMxsV85l/Lu7sNx4zSzPyoL2euImuEwHhOXdEgNFZQ==}
    engines: {node: ^14.15.0 || ^16.10.0 || >=18.0.0}

  proc-log@4.2.0:
    resolution: {integrity: sha512-g8+OnU/L2v+wyiVK+D5fA34J7EH8jZ8DDlvwhRCMxmMj7UCBvxiO1mGeN+36JXIKF4zevU4kRBd8lVgG9vLelA==}
    engines: {node: ^14.17.0 || ^16.13.0 || >=18.0.0}

  progress@2.0.3:
    resolution: {integrity: sha512-7PiHtLll5LdnKIMw100I+8xJXR5gW2QwWYkT6iJva0bXitZKa/XMrSbdmg3r2Xnaidz9Qumd0VPaMrZlF9V9sA==}
    engines: {node: '>=0.4.0'}

  promise@8.3.0:
    resolution: {integrity: sha512-rZPNPKTOYVNEEKFaq1HqTgOwZD+4/YHS5ukLzQCypkj+OkYx7iv0mA91lJlpPPZ8vMau3IIGj5Qlwrx+8iiSmg==}

  prompts@2.4.2:
    resolution: {integrity: sha512-NxNv/kLguCA7p3jE8oL2aEBsrJWgAakBpgmgK6lpPWV+WuOmY6r2/zbAVnP+T8bQlA0nzHXSJSJW0Hq7ylaD2Q==}
    engines: {node: '>= 6'}

  range-parser@1.2.1:
    resolution: {integrity: sha512-Hrgsx+orqoygnmhFbKaHE6c296J+HTAQXoxEF6gNupROmmGJRoyzfG3ccAveqCBrwr/2yxQ5BVd/GTl5agOwSg==}
    engines: {node: '>= 0.6'}

  react-devtools-core@6.1.5:
    resolution: {integrity: sha512-ePrwPfxAnB+7hgnEr8vpKxL9cmnp7F322t8oqcPshbIQQhDKgFDW4tjhF2wjVbdXF9O/nyuy3sQWd9JGpiLPvA==}

  react-is@18.3.1:
    resolution: {integrity: sha512-/LLMVyas0ljjAtoYiPqYiL8VWXzUUdThrmU5+n20DZv+a+ClRoevUzw5JxU+Ieh5/c87ytoTBV9G1FiKfNJdmg==}

  react-native-ble-plx@3.5.1:
    resolution: {integrity: sha512-SxksmrUt9jG6DOarrrdkb5c/HBLSfZOKauo/9VQSSi3WJA4bmF78GkrtXrgSoGNk0m1ksacFTjB5DuL39xZq/g==}
    engines: {node: '>= 18.0.0'}
    peerDependencies:
      react: '*'
      react-native: '*'

  react-native@0.88.0:
    resolution: {integrity: sha512-v/wee0nYWcammMYBnSat/e3WY/5iaf9YQOMcBrfKT/wPApPPlHp94hgZovBtwhMuthR01yc/8cGn0FpFTE/C4A==}
    engines: {node: ^22.13.0 || ^24.3.0 || >= 26.0.0}
    hasBin: true
    peerDependencies:
      '@types/react': ^19.1.1
      react: ^19.3.0
    peerDependenciesMeta:
      '@types/react':
        optional: true

  react-refresh@0.14.2:
    resolution: {integrity: sha512-jCvmsr+1IUSMUyzOkRcvnVbX3ZYC6g9TDrDbFuFmRDq7PD4yaGbLKNQL6k2jnArV8hjYxh7hVhAZB6s9HDGpZA==}
    engines: {node: '>=0.10.0'}

  react@19.3.0:
    resolution: {integrity: sha512-E8LUcbtBWt20bbl2YoHfx4ZDBdxVTfOKtCZn9cDSJ4l6/nuoApcpIBcj47t2wZoVX8g2ZHuMHbiShgCR1T5Sog==}
    engines: {node: '>=0.10.0'}

  regenerate-unicode-properties@10.3.0:
    resolution: {integrity: sha512-9ns8odR8e9q3otKeHj3DE80jZYKg6zVeZKE+zQmRKXFoVUcuiTGeO6iusDhPRoIQQPVPRvH+SfBhrTud4eczuw==}
    engines: {node: '>=4'}

  regenerate@1.5.0:
    resolution: {integrity: sha512-1s+CxXjJ71i7LNVy8nYwg47XV4y6lAnOEhsMtSKq3WpmPfhl9LuKlTqKIn/3yUpE8lBz+W+TT88Bxyhnr0U4yw==}

  regenerator-runtime@0.13.11:
    resolution: {integrity: sha512-kY1AZVr2Ra+t+piVaJ4gxaFaReZVH40AKNo7UCX6W+dEwBo/2oZJzqfuN1qLq1oL45o56cPaTXELwrTh8Fpggg==}

  regexpu-core@6.5.3:
    resolution: {integrity: sha512-E8VgUoSK+LMQrLboDxavm76MTBGrQhx9RiNuomRmYnZ10Uw12HrI8fkxOOncktb2hBpzIZ9SV/347euQHG5z+g==}
    engines: {node: '>=4'}

  regjsgen@0.8.0:
    resolution: {integrity: sha512-RvwtGe3d7LvWiDQXeQw8p5asZUmfU1G/l6WbUXeHta7Y2PEIvBTwH6E2EfmYUK8pxcxEdEmaomqyp0vZZ7C+3Q==}

  regjsparser@0.13.4:
    resolution: {integrity: sha512-EWV80YgFaVgFrjGCAsV7oybp4GOxbls5RzBg8OB0nKEVXsBJR1JlV8Di1JhCROg3MzTfe1RI8yitIm1eOs68iA==}
    hasBin: true

  require-directory@2.1.1:
    resolution: {integrity: sha512-fGxEI7+wsG9xrvdjsrlmL22OMTTiHRwAMroiEeMgq8gzoLC/PQr7RsRDSTLUg/bZAZtF+TVIkHc6/4RIKrui+Q==}
    engines: {node: '>=0.10.0'}

  resolve-from@5.0.0:
    resolution: {integrity: sha512-qYg9KP24dD5qka9J47d0aVky0N+b4fTU89LN9iDnjB5waksiC49rvMB0PrUJQGoTmH50XPiqOvAjDfaijGxYZw==}
    engines: {node: '>=8'}

  resolve-workspace-root@2.0.1:
    resolution: {integrity: sha512-nR23LHAvaI6aHtMg6RWoaHpdR4D881Nydkzi2CixINyg9T00KgaJdJI6Vwty+Ps8WLxZHuxsS0BseWjxSA4C+w==}

  resolve@1.22.13:
    resolution: {integrity: sha512-Dj/cW9zBV2aRj6XzCxuGIs3ESZKv02jixne3q6jFZYZ3/Tg09gHHviSMDL4kObh9pqSahdRHEnDoaP2gn8YLhA==}
    engines: {node: '>= 0.4'}
    hasBin: true

  restore-cursor@2.0.0:
    resolution: {integrity: sha512-6IzJLuGi4+R14vwagDHX+JrXmPVtPpn4mffDJ1UdR7/Edm87fl6yi8mMBIVvFtJaNTUvjughmW4hwLhRG7gC1Q==}
    engines: {node: '>=4'}

  safe-buffer@5.2.1:
    resolution: {integrity: sha512-rp3So07KcdmmKbGvgaNxQSJr7bGVSVk5S9Eq1F+ppbRo70+YeaDxkw5Dd8NPN+GD6bjnYm2VuPuCXmpuYvmCXQ==}

  sandbox-cli-detector@0.2.0:
    resolution: {integrity: sha512-4lyHX0ZU0AZKwjgZ1InxZAa3PNpyEb8rOQ+Zss1ReYmhNzW0Q+h1zE5nvniXN0HaAWZaZE1zgVNEirb0R7LmNg==}
    engines: {node: '>=18.18'}
    hasBin: true

  sax@1.6.1:
    resolution: {integrity: sha512-42tBVwLWnaQvW5zc4HbZrTuWccECCZfBi92FDuwtqxasH+JbPB3/FOKb1m222K42R4WxuxzzMsTswfzgtSu64Q==}
    engines: {node: '>=11.0.0'}

  scheduler@0.28.0:
    resolution: {integrity: sha512-juorfCmIkIw8tT+p5BXSm6PJjQF/ycEYmKyzURCIt/RaZIhL+PulbQ9Yu2z1HdOJDdqDTlxA1+xKBmHXJsczAw==}

  semver@6.3.1:
    resolution: {integrity: sha512-BR7VvDCVHO+q2xBEWskxS6DJE1qRnb7DxzUrogb71CWoSficBxYsiAGd+Kl0mmq/MprG9yArRkyrQxTO6XjMzA==}
    hasBin: true

  semver@7.8.5:
    resolution: {integrity: sha512-Y7/KDsb8LjooZpwaqGyulO6DQlksgCncchHGk+sZIY4SBvUocMBEFH5Ur1fI4dV+Jvl0w6cjvucaIi40puRioA==}
    engines: {node: '>=10'}
    hasBin: true

  send@0.19.2:
    resolution: {integrity: sha512-VMbMxbDeehAxpOtWJXlcUS5E8iXh6QmN+BkRX1GARS3wRaXEEgzCcB10gTQazO42tpNIya8xIyNx8fll1OFPrg==}
    engines: {node: '>= 0.8.0'}

  serialize-error@2.1.0:
    resolution: {integrity: sha512-ghgmKt5o4Tly5yEG/UJp8qTd0AN7Xalw4XBtDEKP655B699qMEtra1WlXeE6WIvdEG481JvRxULKsInq/iNysw==}
    engines: {node: '>=0.10.0'}

  serve-static@1.16.3:
    resolution: {integrity: sha512-x0RTqQel6g5SY7Lg6ZreMmsOzncHFU7nhnRWkKgWuMTu5NN0DR5oruckMqRvacAN9d5w6ARnRBXl9xhDCgfMeA==}
    engines: {node: '>= 0.8.0'}

  setprototypeof@1.2.0:
    resolution: {integrity: sha512-E5LDX7Wrp85Kil5bhZv46j8jOeboKq5JMmYM3gVGdGH8xFpPWXUMsNrlODCrkoxMEeNi/XZIwuRvY4XNwYMJpw==}

  shebang-command@2.0.0:
    resolution: {integrity: sha512-kHxr2zZpYtdmrN1qDjrrX/Z1rR1kG8Dx+gkpK1G4eXmvXswmcE1hTWBWYUzlraYw1/yZp6YuDY77YtvbN0dmDA==}
    engines: {node: '>=8'}

  shebang-regex@3.0.0:
    resolution: {integrity: sha512-7++dFhtcx3353uBaq8DDR4NuxBetBzC7ZQOhmTQInHEd6bSrXdiEyzCvG07Z44UYdLShWUyXt5M/yhz8ekcb1A==}
    engines: {node: '>=8'}

  shell-quote@1.12.0:
    resolution: {integrity: sha512-PcByqNyT/38F2kDNi006HAMRJaULuBzq/FOsw3qdZvX/GA9W/jamDaRskgHjubHiftXK5sIFxLNkvrXUwcof6Q==}
    engines: {node: '>= 0.4'}

  signal-exit@3.0.7:
    resolution: {integrity: sha512-wnD2ZE+l+SPC/uoS0vXeE9L1+0wuaMqKlfz9AMUo38JsyLSBWSFcHR1Rri62LZc12vLr1gb3jl7iwQhgwpAbGQ==}

  simple-plist@1.3.1:
    resolution: {integrity: sha512-iMSw5i0XseMnrhtIzRb7XpQEXepa9xhWxGUojHBL43SIpQuDQkh3Wpy67ZbDzZVr6EKxvwVChnVpdl8hEVLDiw==}

  sisteransi@1.0.5:
    resolution: {integrity: sha512-bLGGlR1QxBcynn2d5YmDX4MGjlZvy2MRBDRNHLJ8VI6l6+9FUiyTFNJ0IveOSP0bcXgVDPRcfGqA0pjaqUpfVg==}

  slugify@1.6.9:
    resolution: {integrity: sha512-vZ7rfeehZui7wQs438JXBckYLkIIdfHOXsaVEUMyS5fHo1483l1bMdo0EDSWYclY0yZKFOipDy4KHuKs6ssvdg==}
    engines: {node: '>=8.0.0'}

  source-map-js@1.2.2:
    resolution: {integrity: sha512-KGj/8Y43x35aZVDtt+J4mK1hoLGHULMYfSkODJNQjNDC3oW1PqPoxMwo0pLUsWM/UEGzON/NxeHywEfNXNP3Vw==}
    engines: {node: '>=0.10.0'}

  source-map-support@0.5.21:
    resolution: {integrity: sha512-uBHU3L3czsIyYXKX88fdrGovxdSCoTGDRZ6SYXtSRxLZUzHg5P/66Ht6uoUlHu9EZod+inXhKo3qQgwXUT/y1w==}

  source-map@0.5.7:
    resolution: {integrity: sha512-LbrmJOMUSdEVxIKvdcJzQC+nQhe8FUZQTXQy6+I75skNgn3OoQ0DZA8YnFa7gp8tqtL3KPf1kmo0R5DoApeSGQ==}
    engines: {node: '>=0.10.0'}

  source-map@0.6.1:
    resolution: {integrity: sha512-UjgapumWlbMhkBgzT7Ykc5YXUT46F0iKu8SGXq0bcwP5dz/h0Plj6enJqjz1Zbq2l5WaqYnrVbwWOWMyF3F47g==}
    engines: {node: '>=0.10.0'}

  stackframe@1.3.4:
    resolution: {integrity: sha512-oeVtt7eWQS+Na6F//S4kJ2K2VbRlS9D43mAlMyVpVWovy9o+jfgH8O9agzANzaiLjclA0oYzUXEM4PurhSUChw==}

  stacktrace-parser@0.1.11:
    resolution: {integrity: sha512-WjlahMgHmCJpqzU8bIBy4qtsZdU9lRlcZE3Lvyej6t4tuOuv1vk57OW3MBrj6hXBFx/nNoC9MPMTcr5YA7NQbg==}
    engines: {node: '>=6'}

  statuses@1.5.0:
    resolution: {integrity: sha512-OpZ3zP+jT1PI7I8nemJX4AKmAX070ZkYPVWV/AaKTJl+tXCTGyVdC1a4SL8RUQYEwk/f34ZX8UTykN68FwrqAA==}
    engines: {node: '>= 0.6'}

  statuses@2.0.2:
    resolution: {integrity: sha512-DvEy55V3DB7uknRo+4iOGT5fP1slR8wQohVdknigZPMpMstaKJQWhwiYBACJE3Ul2pTnATihhBYnRhZQHGBiRw==}
    engines: {node: '>= 0.8'}

  stream-buffers@2.2.0:
    resolution: {integrity: sha512-uyQK/mx5QjHun80FLJTfaWE7JtwfRMKBLkMne6udYOmvH0CawotVa7TfgYHzAnpphn4+TweIx1QKMnRIbipmUg==}
    engines: {node: '>= 0.10.0'}

  string-width@4.2.3:
    resolution: {integrity: sha512-wKyQRQpjJ0sIp62ErSZdGsjMJWsap5oRNihHhu6G7JVO/9jIB6UyevL+tXuOqrng8j/cxKTWyWUwvSTriiZz/g==}
    engines: {node: '>=8'}

  strip-ansi@5.2.0:
    resolution: {integrity: sha512-DuRs1gKbBqsMKIZlrffwlug8MHkcnpjs5VPmL1PAh+mA30U0DTotfDZ0d2UUsXpPmPmMMJ6W773MaA3J+lbiWA==}
    engines: {node: '>=6'}

  strip-ansi@6.0.1:
    resolution: {integrity: sha512-Y38VPSHcqkFrCpFnQ9vuSXmquuv5oXOKpGeT6aGrr3o3Gc9AlVa6JBfUSOCnbxGGZF+/0ooI7KrPuUSztUdU5A==}
    engines: {node: '>=8'}

  structured-headers@0.4.1:
    resolution: {integrity: sha512-0MP/Cxx5SzeeZ10p/bZI0S6MpgD+yxAhi1BOQ34jgnMXsCq3j1t6tQnZu+KdlL7dvJTLT3g9xN8tl10TqgFMcg==}

  supports-color@5.5.0:
    resolution: {integrity: sha512-QjVjwdXIt408MIiAqCX4oUKsgU2EqAGzs2Ppkm4aQYbjm+ZEWEcW4SfFNTr4uMNZma0ey4f5lgLrkB0aX0QMow==}
    engines: {node: '>=4'}

  supports-color@7.2.0:
    resolution: {integrity: sha512-qpCAvRl9stuOHveKsn7HncJRvv501qIacKzQlO/+Lwxc9+0q2wLyv4Dfvt80/DPn2pqOBsJdDiogXGR9+OvwRw==}
    engines: {node: '>=8'}

  supports-color@8.1.1:
    resolution: {integrity: sha512-MpUEN2OodtUzxvKQl72cUF7RQ5EiHsGvSsVG0ia9c5RbWGL2CI4C7EpPS8UTBIplnlzZiNuV56w+FuNxy3ty2Q==}
    engines: {node: '>=10'}

  supports-hyperlinks@2.3.0:
    resolution: {integrity: sha512-RpsAZlpWcDwOPQA22aCH4J0t7L8JmAvsCxfOSEwm7cQs3LshN36QaTkwd70DnBOXDWGssw2eUoc8CaRWT0XunA==}
    engines: {node: '>=8'}

  supports-preserve-symlinks-flag@1.0.0:
    resolution: {integrity: sha512-ot0WnXS9fgdkgIcePe6RHNk1WA8+muPa6cSjeR3V8K27q9BB1rTE3R1p7Hv0z1ZyAc8s6Vvv8DIyWf681MAt0w==}
    engines: {node: '>= 0.4'}

  terminal-link@2.1.1:
    resolution: {integrity: sha512-un0FmiRUQNr5PJqy9kP7c40F5BOfpGlYTrxonDChEZB7pzZxRNp/bt+ymiy9/npwXya9KH99nJ/GXFIiUkYGFQ==}
    engines: {node: '>=8'}

  terser@5.51.2:
    resolution: {integrity: sha512-bWnjSNscmuI+GJze6ZupnHP8G/cTcsJF+bXCeQknk2SHQsgbNJnLrqiH9jZ2W4STPVXH2mDKKRX3iwPhc9Cn/Q==}
    engines: {node: '>=10'}
    hasBin: true

  throat@5.0.0:
    resolution: {integrity: sha512-fcwX4mndzpLQKBS1DVYhGAcYaYt7vsHNIvQV+WXMvnow5cgjPphq5CaayLaGsjRdSCKZFNGt7/GYAuXaNOiYCA==}

  tinyglobby@0.2.17:
    resolution: {integrity: sha512-wXR/dYpcqKmfWpEdZjiKJOwCNFndD0DMnrW/cYjVGttEkBfVgcLFHoNrlj47mjOVic9yyNu65alsgF4NQyTa2g==}
    engines: {node: '>=12.0.0'}

  tmpl@1.0.5:
    resolution: {integrity: sha512-3f0uOEAQwIqGuWW2MVzYg8fV/QNnc/IpuJNG837rLuczAaLVHslWHZQj4IGiEl5Hs3kkbhwL9Ab7Hrsmuj+Smw==}

  to-regex-range@5.0.1:
    resolution: {integrity: sha512-65P7iz6X5yEr1cwcgvQxbbIw7Uk3gOy5dIdtZ4rDveLqhrdJP+Li/Hx6tyK0NEb+2GCyneCMJiGqrADCSNk8sQ==}
    engines: {node: '>=8.0'}

  toidentifier@1.0.1:
    resolution: {integrity: sha512-o5sSPKEkg/DIQNmH43V0/uerLrpzVedkUh8tGNvaeXpfpuwjKenlSox/2O/BTlZUtEe+JG7s5YhEz608PlAHRA==}
    engines: {node: '>=0.6'}

  toqr@0.1.1:
    resolution: {integrity: sha512-FWAPzCIHZHnrE/5/w9MPk0kK25hSQSH2IKhYh9PyjS3SG/+IEMvlwIHbhz+oF7xl54I+ueZlVnMjyzdSwLmAwA==}

  type-fest@0.21.3:
    resolution: {integrity: sha512-t0rzBq87m3fVcduHDUFhKmyyX+9eo6WQjZvf51Ea/M0Q7+T374Jp1aUiyUl0GKxp8M/OETVHSDvmkyPgvX+X2w==}
    engines: {node: '>=10'}

  type-fest@0.7.1:
    resolution: {integrity: sha512-Ne2YiiGN8bmrmJJEuTWTLJR32nh/JdL1+PSicowtNb0WFpn59GK8/lfD61bVtzguz7b3PBt74nxpv/Pw5po5Rg==}
    engines: {node: '>=8'}

  undici-types@8.9.0:
    resolution: {integrity: sha512-KTDyRTYX8sWmKXAikPHHSyc63CRPETMctyjKFupcC6OBLXT3xsN0e9aF7m+mIXutFWpUXuedtowG7iLOzp0kQg==}

  unicode-canonical-property-names-ecmascript@2.0.1:
    resolution: {integrity: sha512-dA8WbNeb2a6oQzAQ55YlT5vQAWGV9WXOsi3SskE3bcCdM0P4SDd+24zS/OCacdRq5BkdsRj9q3Pg6YyQoxIGqg==}
    engines: {node: '>=4'}

  unicode-match-property-ecmascript@2.0.0:
    resolution: {integrity: sha512-5kaZCrbp5mmbz5ulBkDkbY0SsPOjKqVS35VpL9ulMPfSl0J0Xsm+9Evphv9CoIZFwre7aJoa94AY6seMKGVN5Q==}
    engines: {node: '>=4'}

  unicode-match-property-value-ecmascript@2.2.1:
    resolution: {integrity: sha512-JQ84qTuMg4nVkx8ga4A16a1epI9H6uTXAknqxkGF/aFfRLw1xC/Bp24HNLaZhHSkWd3+84t8iXnp1J0kYcZHhg==}
    engines: {node: '>=4'}

  unicode-property-aliases-ecmascript@2.2.0:
    resolution: {integrity: sha512-hpbDzxUY9BFwX+UeBnxv3Sh1q7HFxj48DTmXchNgRa46lO8uj3/1iEn3MiNUYTg1g9ctIqXCCERn8gYZhHC5lQ==}
    engines: {node: '>=4'}

  unpipe@1.0.0:
    resolution: {integrity: sha512-pjy2bYhSsufwWlKwPc+l3cN7+wuJlK6uz0YdJEOlQDbl6jo/YlPi4mb8agUkVC8BF7V8NuzeyPNqRksA3hztKQ==}
    engines: {node: '>= 0.8'}

  update-browserslist-db@1.3.4:
    resolution: {integrity: sha512-t8wonIOdQyOjtPd2VktlBu6QjTVTks6v8bSi7kd0r2Vll8TK1JYDZtRRdbmCHOAMphkZgrzK+L+vXK4pyZ8t4A==}
    hasBin: true
    peerDependencies:
      browserslist: '>= 4.21.0'

  utils-merge@1.0.1:
    resolution: {integrity: sha512-pMZTvIkT1d+TFGvDOqodOclx0QWkkgi6Tdoa8gC8ffGAAqz9pzPTZWAybbsHHoED/ztMtkv/VoYTYyShUn81hA==}
    engines: {node: '>= 0.4.0'}

  uuid@7.0.3:
    resolution: {integrity: sha512-DPSke0pXhTZgoF/d+WSt2QaKMCFSfx7QegxEWT+JOuHF5aWrKEn0G+ztjuJg/gG8/ItK+rbPCD/yNv8yyih6Cg==}
    deprecated: uuid@10 and below is no longer supported.  For ESM codebases, update to uuid@latest.  For CommonJS codebases, use uuid@11 (but be aware this version will likely be deprecated in 2028).
    hasBin: true

  validate-npm-package-name@5.0.1:
    resolution: {integrity: sha512-OljLrQ9SQdOUqTaQxqL5dEfZWrXExyyWsozYlAWFawPVNuD83igl7uJD2RTkNMbniIYgt8l81eCJGIdQF7avLQ==}
    engines: {node: ^14.17.0 || ^16.13.0 || >=18.0.0}

  vary@1.1.2:
    resolution: {integrity: sha512-BNGbWLfd0eUPabhkXUVm0j8uuvREyTh5ovRa/dyow/BqAbZJyC+5fU+IzQOzmAKzYqYRAISoRhdQr3eIZ/PXqg==}
    engines: {node: '>= 0.8'}

  vlq@1.0.1:
    resolution: {integrity: sha512-gQpnTgkubC6hQgdIcRdYGDSDc+SaujOdyesZQMv6JlfQee/9Mp0Qhnys6WxDWvQnL5WZdT7o2Ul187aSt0Rq+w==}

  walker@1.0.8:
    resolution: {integrity: sha512-ts/8E8l5b7kY0vlWLewOkDXMmPdLcVV4GmOQLyxuSswIJsweeFZtAsMF7k1Nszz+TYBQrlYRmzOnr398y1JemQ==}

  wcwidth@1.0.1:
    resolution: {integrity: sha512-XHPEwS0q6TaxcvG85+8EYkbiCux2XtWG2mkc47Ng2A77BQu9+DqIOJldST4HgPkuea7dvKSj5VgX3P1d4rW8Tg==}

  whatwg-fetch@3.6.20:
    resolution: {integrity: sha512-EqhiFU6daOA8kpjOWTL0olhVOF3i7OrFzSYiGsEMB8GcXS+RrzauAERX65xMeNWVqxA6HXH2m69Z9LaKKdisfg==}

  whatwg-url-minimum@0.2.0:
    resolution: {integrity: sha512-BtjXU1caNcCFfETP2DhqSeVPfRDl2MTUitI107RE34rJXjR/izfUtR5IoTFOK1WqjNLXbbeqaCH/mQAOLjpc8g==}

  which@2.0.2:
    resolution: {integrity: sha512-BLI3Tl1TW3Pvl70l3yq3Y64i+awpwXqsGBYWkkqMtnbXgrMD+yj7rhW0kuEDxzJaYXGjEW5ogapKNMEKNMjibA==}
    engines: {node: '>= 8'}
    hasBin: true

  wrap-ansi@7.0.0:
    resolution: {integrity: sha512-YVGIj2kamLSTxw6NsZjoBxfSwsn0ycdesmc4p+Q21c5zPuZ1pl+NfxVdxPtdHvmNVOQ6XSYG4AUtyt/Fi7D16Q==}
    engines: {node: '>=10'}

  ws@7.5.13:
    resolution: {integrity: sha512-rsKI6xDBFVf4r/x8XyChGK04QR/XHroxs/jUcoWvtEZM8TPU/X/uIY9B1CsSzYws9ZJb/6bbBu7dPhFW00CAoA==}
    engines: {node: '>=8.3.0'}
    peerDependencies:
      bufferutil: ^4.0.1
      utf-8-validate: ^5.0.2
    peerDependenciesMeta:
      bufferutil:
        optional: true
      utf-8-validate:
        optional: true

  ws@8.22.0:
    resolution: {integrity: sha512-Ydggc987+RO0AnWtZ/7Wq9FtNvcrL1b/RO0ud9mWjUPgDrsAAwQSF51sm2hm1XofbU/4jkpGEsLFsZZxU+1DOg==}
    engines: {node: '>=10.0.0'}
    peerDependencies:
      bufferutil: ^4.0.1
      utf-8-validate: '>=5.0.2'
    peerDependenciesMeta:
      bufferutil:
        optional: true
      utf-8-validate:
        optional: true

  xcode@3.0.1:
    resolution: {integrity: sha512-kCz5k7J7XbJtjABOvkc5lJmkiDh8VhjVCGNiqdKCscmVpdVUpEAyXv1xmCLkQJ5dsHqx3IPO4XW+NTDhU/fatA==}
    engines: {node: '>=10.0.0'}

  xml2js@0.6.0:
    resolution: {integrity: sha512-eLTh0kA8uHceqesPqSE+VvO1CDDJWMwlQfB6LuN6T8w6MaDJ8Txm8P7s5cHD0miF0V+GGTZrDQfxPZQVsur33w==}
    engines: {node: '>=4.0.0'}

  xmlbuilder@11.0.1:
    resolution: {integrity: sha512-fDlsI/kFEx7gLvbecc0/ohLG50fugQp8ryHzMTuW9vSa1GJ0XYWKnhsUx7oie3G98+r56aTQIUB4kht42R3JvA==}
    engines: {node: '>=4.0'}

  xmlbuilder@15.1.1:
    resolution: {integrity: sha512-yMqGBqtXyeN1e3TGYvgNgDVZ3j84W4cwkOXQswghol6APgZWaff9lnbvN7MHYJOiXsvGPXtjTYJEiC9J2wv9Eg==}
    engines: {node: '>=8.0'}

  y18n@5.0.8:
    resolution: {integrity: sha512-0pfFzegeDWJHJIAmTLRP2DwHjdF5s7jo9tuztdQxAhINCdvS+3nGINqPd00AphqJR/0LhANUS6/+7SCb98YOfA==}
    engines: {node: '>=10'}

  yallist@3.1.1:
    resolution: {integrity: sha512-a4UGQaWPH59mOXUYnAG2ewncQS4i4F43Tv3JoAM+s2VDAmS9NsK8GpDMLrCHPksFT7h3K6TOoUNn2pb7RoXx4g==}

  yargs-parser@21.1.1:
    resolution: {integrity: sha512-tVpsJW7DdjecAiFpbIB1e3qxIQsE6NoPc5/eTdrbbIC4h0LVsWhnoa3g+m2HclBIujHzsxZ4VJVA+GUuc2/LBw==}
    engines: {node: '>=12'}

  yargs@17.7.3:
    resolution: {integrity: sha512-GZtjxm/J/4TSxuL3FNYjCmLktBTnIw/rVmKSIyKeYAZpmJB2ig9VauCC5xsa82GNKVKDAqpOn3KVzNt0zmrU0g==}
    engines: {node: '>=12'}

  zod@3.25.76:
    resolution: {integrity: sha512-gzUt/qt81nXsFGKIFcC3YnfEAx5NkunCfnDlvuBSSFS02bcXu4Lmea0AFIUwbLWxWPx3d9p8S5QoaujKcNQxcQ==}
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
