Keyi-1/xinxian-fpga-guitar/rtl/display/guitar_radial_twiddle.v

// Explicit asynchronous logic lookup: no additional FFT RAM.
module guitar_radial_twiddle(input wire [8:0] index,output reg [31:0] value) /* synthesis syn_romstyle="logic" */;
    always @* case(index)
        9'd0:value=32'h7fff0000;
        9'd1:value=32'h7ffe00c9;
        9'd2:value=32'h7ffd0192;
        9'd3:value=32'h7ff9025b;
        9'd4:value=32'h7ff50324;
        9'd5:value=32'h7ff003ed;
        9'd6:value=32'h7fe904b6;
        9'd7:value=32'h7fe1057f;
        9'd8:value=32'h7fd80648;
        9'd9:value=32'h7fcd0711;
        9'd10:value=32'h7fc107d9;
        9'd11:value=32'h7fb408a2;
        9'd12:value=32'h7fa6096a;
        9'd13:value=32'h7f970a33;
        9'd14:value=32'h7f860afb;
        9'd15:value=32'h7f740bc4;
        9'd16:value=32'h7f610c8c;
        9'd17:value=32'h7f4d0d54;
        9'd18:value=32'h7f370e1c;
        9'd19:value=32'h7f210ee3;
        9'd20:value=32'h7f090fab;
        9'd21:value=32'h7eef1072;
        9'd22:value=32'h7ed5113a;
        9'd23:value=32'h7eb91201;
        9'd24:value=32'h7e9c12c8;
        9'd25:value=32'h7e7e138f;
        9'd26:value=32'h7e5f1455;
        9'd27:value=32'h7e3e151c;
        9'd28:value=32'h7e1d15e2;
        9'd29:value=32'h7dfa16a8;
        9'd30:value=32'h7dd5176e;
        9'd31:value=32'h7db01833;
        9'd32:value=32'h7d8918f9;
        9'd33:value=32'h7d6219be;
        9'd34:value=32'h7d391a82;
        9'd35:value=32'h7d0e1b47;
        9'd36:value=32'h7ce31c0b;
        9'd37:value=32'h7cb61ccf;
        9'd38:value=32'h7c881d93;
        9'd39:value=32'h7c591e57;
        9'd40:value=32'h7c291f1a;
        9'd41:value=32'h7bf81fdd;
        9'd42:value=32'h7bc5209f;
        9'd43:value=32'h7b912161;
        9'd44:value=32'h7b5c2223;
        9'd45:value=32'h7b2622e5;
        9'd46:value=32'h7aee23a6;
        9'd47:value=32'h7ab62467;
        9'd48:value=32'h7a7c2528;
        9'd49:value=32'h7a4125e8;
        9'd50:value=32'h7a0526a8;
        9'd51:value=32'h79c82767;
        9'd52:value=32'h79892826;
        9'd53:value=32'h794a28e5;
        9'd54:value=32'h790929a3;
        9'd55:value=32'h78c72a61;
        9'd56:value=32'h78842b1f;
        9'd57:value=32'h783f2bdc;
        9'd58:value=32'h77fa2c99;
        9'd59:value=32'h77b32d55;
        9'd60:value=32'h776b2e11;
        9'd61:value=32'h77222ecc;
        9'd62:value=32'h76d82f87;
        9'd63:value=32'h768d3041;
        9'd64:value=32'h764130fb;
        9'd65:value=32'h75f331b5;
        9'd66:value=32'h75a5326e;
        9'd67:value=32'h75553326;
        9'd68:value=32'h750433df;
        9'd69:value=32'h74b23496;
        9'd70:value=32'h745f354d;
        9'd71:value=32'h740a3604;
        9'd72:value=32'h73b536ba;
        9'd73:value=32'h735e376f;
        9'd74:value=32'h73073824;
        9'd75:value=32'h72ae38d9;
        9'd76:value=32'h7254398c;
        9'd77:value=32'h71f93a40;
        9'd78:value=32'h719d3af2;
        9'd79:value=32'h71403ba5;
        9'd80:value=32'h70e23c56;
        9'd81:value=32'h70833d07;
        9'd82:value=32'h70223db8;
        9'd83:value=32'h6fc13e68;
        9'd84:value=32'h6f5e3f17;
        9'd85:value=32'h6efb3fc5;
        9'd86:value=32'h6e964073;
        9'd87:value=32'h6e304121;
        9'd88:value=32'h6dc941ce;
        9'd89:value=32'h6d61427a;
        9'd90:value=32'h6cf84325;
        9'd91:value=32'h6c8e43d0;
        9'd92:value=32'h6c23447a;
        9'd93:value=32'h6bb74524;
        9'd94:value=32'h6b4a45cd;
        9'd95:value=32'h6adc4675;
        9'd96:value=32'h6a6d471c;
        9'd97:value=32'h69fd47c3;
        9'd98:value=32'h698b4869;
        9'd99:value=32'h6919490f;
        9'd100:value=32'h68a649b4;
        9'd101:value=32'h68324a58;
        9'd102:value=32'h67bc4afb;
        9'd103:value=32'h67464b9d;
        9'd104:value=32'h66cf4c3f;
        9'd105:value=32'h66564ce0;
        9'd106:value=32'h65dd4d81;
        9'd107:value=32'h65634e20;
        9'd108:value=32'h64e84ebf;
        9'd109:value=32'h646c4f5d;
        9'd110:value=32'h63ee4ffb;
        9'd111:value=32'h63705097;
        9'd112:value=32'h62f15133;
        9'd113:value=32'h627151ce;
        9'd114:value=32'h61f05268;
        9'd115:value=32'h616e5302;
        9'd116:value=32'h60eb539b;
        9'd117:value=32'h60685432;
        9'd118:value=32'h5fe354c9;
        9'd119:value=32'h5f5d5560;
        9'd120:value=32'h5ed755f5;
        9'd121:value=32'h5e4f568a;
        9'd122:value=32'h5dc7571d;
        9'd123:value=32'h5d3e57b0;
        9'd124:value=32'h5cb35842;
        9'd125:value=32'h5c2858d3;
        9'd126:value=32'h5b9c5964;
        9'd127:value=32'h5b0f59f3;
        9'd128:value=32'h5a825a82;
        9'd129:value=32'h59f35b0f;
        9'd130:value=32'h59645b9c;
        9'd131:value=32'h58d35c28;
        9'd132:value=32'h58425cb3;
        9'd133:value=32'h57b05d3e;
        9'd134:value=32'h571d5dc7;
        9'd135:value=32'h568a5e4f;
        9'd136:value=32'h55f55ed7;
        9'd137:value=32'h55605f5d;
        9'd138:value=32'h54c95fe3;
        9'd139:value=32'h54326068;
        9'd140:value=32'h539b60eb;
        9'd141:value=32'h5302616e;
        9'd142:value=32'h526861f0;
        9'd143:value=32'h51ce6271;
        9'd144:value=32'h513362f1;
        9'd145:value=32'h50976370;
        9'd146:value=32'h4ffb63ee;
        9'd147:value=32'h4f5d646c;
        9'd148:value=32'h4ebf64e8;
        9'd149:value=32'h4e206563;
        9'd150:value=32'h4d8165dd;
        9'd151:value=32'h4ce06656;
        9'd152:value=32'h4c3f66cf;
        9'd153:value=32'h4b9d6746;
        9'd154:value=32'h4afb67bc;
        9'd155:value=32'h4a586832;
        9'd156:value=32'h49b468a6;
        9'd157:value=32'h490f6919;
        9'd158:value=32'h4869698b;
        9'd159:value=32'h47c369fd;
        9'd160:value=32'h471c6a6d;
        9'd161:value=32'h46756adc;
        9'd162:value=32'h45cd6b4a;
        9'd163:value=32'h45246bb7;
        9'd164:value=32'h447a6c23;
        9'd165:value=32'h43d06c8e;
        9'd166:value=32'h43256cf8;
        9'd167:value=32'h427a6d61;
        9'd168:value=32'h41ce6dc9;
        9'd169:value=32'h41216e30;
        9'd170:value=32'h40736e96;
        9'd171:value=32'h3fc56efb;
        9'd172:value=32'h3f176f5e;
        9'd173:value=32'h3e686fc1;
        9'd174:value=32'h3db87022;
        9'd175:value=32'h3d077083;
        9'd176:value=32'h3c5670e2;
        9'd177:value=32'h3ba57140;
        9'd178:value=32'h3af2719d;
        9'd179:value=32'h3a4071f9;
        9'd180:value=32'h398c7254;
        9'd181:value=32'h38d972ae;
        9'd182:value=32'h38247307;
        9'd183:value=32'h376f735e;
        9'd184:value=32'h36ba73b5;
        9'd185:value=32'h3604740a;
        9'd186:value=32'h354d745f;
        9'd187:value=32'h349674b2;
        9'd188:value=32'h33df7504;
        9'd189:value=32'h33267555;
        9'd190:value=32'h326e75a5;
        9'd191:value=32'h31b575f3;
        9'd192:value=32'h30fb7641;
        9'd193:value=32'h3041768d;
        9'd194:value=32'h2f8776d8;
        9'd195:value=32'h2ecc7722;
        9'd196:value=32'h2e11776b;
        9'd197:value=32'h2d5577b3;
        9'd198:value=32'h2c9977fa;
        9'd199:value=32'h2bdc783f;
        9'd200:value=32'h2b1f7884;
        9'd201:value=32'h2a6178c7;
        9'd202:value=32'h29a37909;
        9'd203:value=32'h28e5794a;
        9'd204:value=32'h28267989;
        9'd205:value=32'h276779c8;
        9'd206:value=32'h26a87a05;
        9'd207:value=32'h25e87a41;
        9'd208:value=32'h25287a7c;
        9'd209:value=32'h24677ab6;
        9'd210:value=32'h23a67aee;
        9'd211:value=32'h22e57b26;
        9'd212:value=32'h22237b5c;
        9'd213:value=32'h21617b91;
        9'd214:value=32'h209f7bc5;
        9'd215:value=32'h1fdd7bf8;
        9'd216:value=32'h1f1a7c29;
        9'd217:value=32'h1e577c59;
        9'd218:value=32'h1d937c88;
        9'd219:value=32'h1ccf7cb6;
        9'd220:value=32'h1c0b7ce3;
        9'd221:value=32'h1b477d0e;
        9'd222:value=32'h1a827d39;
        9'd223:value=32'h19be7d62;
        9'd224:value=32'h18f97d89;
        9'd225:value=32'h18337db0;
        9'd226:value=32'h176e7dd5;
        9'd227:value=32'h16a87dfa;
        9'd228:value=32'h15e27e1d;
        9'd229:value=32'h151c7e3e;
        9'd230:value=32'h14557e5f;
        9'd231:value=32'h138f7e7e;
        9'd232:value=32'h12c87e9c;
        9'd233:value=32'h12017eb9;
        9'd234:value=32'h113a7ed5;
        9'd235:value=32'h10727eef;
        9'd236:value=32'h0fab7f09;
        9'd237:value=32'h0ee37f21;
        9'd238:value=32'h0e1c7f37;
        9'd239:value=32'h0d547f4d;
        9'd240:value=32'h0c8c7f61;
        9'd241:value=32'h0bc47f74;
        9'd242:value=32'h0afb7f86;
        9'd243:value=32'h0a337f97;
        9'd244:value=32'h096a7fa6;
        9'd245:value=32'h08a27fb4;
        9'd246:value=32'h07d97fc1;
        9'd247:value=32'h07117fcd;
        9'd248:value=32'h06487fd8;
        9'd249:value=32'h057f7fe1;
        9'd250:value=32'h04b67fe9;
        9'd251:value=32'h03ed7ff0;
        9'd252:value=32'h03247ff5;
        9'd253:value=32'h025b7ff9;
        9'd254:value=32'h01927ffd;
        9'd255:value=32'h00c97ffe;
        9'd256:value=32'h00007fff;
        9'd257:value=32'hff377ffe;
        9'd258:value=32'hfe6e7ffd;
        9'd259:value=32'hfda57ff9;
        9'd260:value=32'hfcdc7ff5;
        9'd261:value=32'hfc137ff0;
        9'd262:value=32'hfb4a7fe9;
        9'd263:value=32'hfa817fe1;
        9'd264:value=32'hf9b87fd8;
        9'd265:value=32'hf8ef7fcd;
        9'd266:value=32'hf8277fc1;
        9'd267:value=32'hf75e7fb4;
        9'd268:value=32'hf6967fa6;
        9'd269:value=32'hf5cd7f97;
        9'd270:value=32'hf5057f86;
        9'd271:value=32'hf43c7f74;
        9'd272:value=32'hf3747f61;
        9'd273:value=32'hf2ac7f4d;
        9'd274:value=32'hf1e47f37;
        9'd275:value=32'hf11d7f21;
        9'd276:value=32'hf0557f09;
        9'd277:value=32'hef8e7eef;
        9'd278:value=32'heec67ed5;
        9'd279:value=32'hedff7eb9;
        9'd280:value=32'hed387e9c;
        9'd281:value=32'hec717e7e;
        9'd282:value=32'hebab7e5f;
        9'd283:value=32'heae47e3e;
        9'd284:value=32'hea1e7e1d;
        9'd285:value=32'he9587dfa;
        9'd286:value=32'he8927dd5;
        9'd287:value=32'he7cd7db0;
        9'd288:value=32'he7077d89;
        9'd289:value=32'he6427d62;
        9'd290:value=32'he57e7d39;
        9'd291:value=32'he4b97d0e;
        9'd292:value=32'he3f57ce3;
        9'd293:value=32'he3317cb6;
        9'd294:value=32'he26d7c88;
        9'd295:value=32'he1a97c59;
        9'd296:value=32'he0e67c29;
        9'd297:value=32'he0237bf8;
        9'd298:value=32'hdf617bc5;
        9'd299:value=32'hde9f7b91;
        9'd300:value=32'hdddd7b5c;
        9'd301:value=32'hdd1b7b26;
        9'd302:value=32'hdc5a7aee;
        9'd303:value=32'hdb997ab6;
        9'd304:value=32'hdad87a7c;
        9'd305:value=32'hda187a41;
        9'd306:value=32'hd9587a05;
        9'd307:value=32'hd89979c8;
        9'd308:value=32'hd7da7989;
        9'd309:value=32'hd71b794a;
        9'd310:value=32'hd65d7909;
        9'd311:value=32'hd59f78c7;
        9'd312:value=32'hd4e17884;
        9'd313:value=32'hd424783f;
        9'd314:value=32'hd36777fa;
        9'd315:value=32'hd2ab77b3;
        9'd316:value=32'hd1ef776b;
        9'd317:value=32'hd1347722;
        9'd318:value=32'hd07976d8;
        9'd319:value=32'hcfbf768d;
        9'd320:value=32'hcf057641;
        9'd321:value=32'hce4b75f3;
        9'd322:value=32'hcd9275a5;
        9'd323:value=32'hccda7555;
        9'd324:value=32'hcc217504;
        9'd325:value=32'hcb6a74b2;
        9'd326:value=32'hcab3745f;
        9'd327:value=32'hc9fc740a;
        9'd328:value=32'hc94673b5;
        9'd329:value=32'hc891735e;
        9'd330:value=32'hc7dc7307;
        9'd331:value=32'hc72772ae;
        9'd332:value=32'hc6747254;
        9'd333:value=32'hc5c071f9;
        9'd334:value=32'hc50e719d;
        9'd335:value=32'hc45b7140;
        9'd336:value=32'hc3aa70e2;
        9'd337:value=32'hc2f97083;
        9'd338:value=32'hc2487022;
        9'd339:value=32'hc1986fc1;
        9'd340:value=32'hc0e96f5e;
        9'd341:value=32'hc03b6efb;
        9'd342:value=32'hbf8d6e96;
        9'd343:value=32'hbedf6e30;
        9'd344:value=32'hbe326dc9;
        9'd345:value=32'hbd866d61;
        9'd346:value=32'hbcdb6cf8;
        9'd347:value=32'hbc306c8e;
        9'd348:value=32'hbb866c23;
        9'd349:value=32'hbadc6bb7;
        9'd350:value=32'hba336b4a;
        9'd351:value=32'hb98b6adc;
        9'd352:value=32'hb8e46a6d;
        9'd353:value=32'hb83d69fd;
        9'd354:value=32'hb797698b;
        9'd355:value=32'hb6f16919;
        9'd356:value=32'hb64c68a6;
        9'd357:value=32'hb5a86832;
        9'd358:value=32'hb50567bc;
        9'd359:value=32'hb4636746;
        9'd360:value=32'hb3c166cf;
        9'd361:value=32'hb3206656;
        9'd362:value=32'hb27f65dd;
        9'd363:value=32'hb1e06563;
        9'd364:value=32'hb14164e8;
        9'd365:value=32'hb0a3646c;
        9'd366:value=32'hb00563ee;
        9'd367:value=32'haf696370;
        9'd368:value=32'haecd62f1;
        9'd369:value=32'hae326271;
        9'd370:value=32'had9861f0;
        9'd371:value=32'hacfe616e;
        9'd372:value=32'hac6560eb;
        9'd373:value=32'habce6068;
        9'd374:value=32'hab375fe3;
        9'd375:value=32'haaa05f5d;
        9'd376:value=32'haa0b5ed7;
        9'd377:value=32'ha9765e4f;
        9'd378:value=32'ha8e35dc7;
        9'd379:value=32'ha8505d3e;
        9'd380:value=32'ha7be5cb3;
        9'd381:value=32'ha72d5c28;
        9'd382:value=32'ha69c5b9c;
        9'd383:value=32'ha60d5b0f;
        9'd384:value=32'ha57e5a82;
        9'd385:value=32'ha4f159f3;
        9'd386:value=32'ha4645964;
        9'd387:value=32'ha3d858d3;
        9'd388:value=32'ha34d5842;
        9'd389:value=32'ha2c257b0;
        9'd390:value=32'ha239571d;
        9'd391:value=32'ha1b1568a;
        9'd392:value=32'ha12955f5;
        9'd393:value=32'ha0a35560;
        9'd394:value=32'ha01d54c9;
        9'd395:value=32'h9f985432;
        9'd396:value=32'h9f15539b;
        9'd397:value=32'h9e925302;
        9'd398:value=32'h9e105268;
        9'd399:value=32'h9d8f51ce;
        9'd400:value=32'h9d0f5133;
        9'd401:value=32'h9c905097;
        9'd402:value=32'h9c124ffb;
        9'd403:value=32'h9b944f5d;
        9'd404:value=32'h9b184ebf;
        9'd405:value=32'h9a9d4e20;
        9'd406:value=32'h9a234d81;
        9'd407:value=32'h99aa4ce0;
        9'd408:value=32'h99314c3f;
        9'd409:value=32'h98ba4b9d;
        9'd410:value=32'h98444afb;
        9'd411:value=32'h97ce4a58;
        9'd412:value=32'h975a49b4;
        9'd413:value=32'h96e7490f;
        9'd414:value=32'h96754869;
        9'd415:value=32'h960347c3;
        9'd416:value=32'h9593471c;
        9'd417:value=32'h95244675;
        9'd418:value=32'h94b645cd;
        9'd419:value=32'h94494524;
        9'd420:value=32'h93dd447a;
        9'd421:value=32'h937243d0;
        9'd422:value=32'h93084325;
        9'd423:value=32'h929f427a;
        9'd424:value=32'h923741ce;
        9'd425:value=32'h91d04121;
        9'd426:value=32'h916a4073;
        9'd427:value=32'h91053fc5;
        9'd428:value=32'h90a23f17;
        9'd429:value=32'h903f3e68;
        9'd430:value=32'h8fde3db8;
        9'd431:value=32'h8f7d3d07;
        9'd432:value=32'h8f1e3c56;
        9'd433:value=32'h8ec03ba5;
        9'd434:value=32'h8e633af2;
        9'd435:value=32'h8e073a40;
        9'd436:value=32'h8dac398c;
        9'd437:value=32'h8d5238d9;
        9'd438:value=32'h8cf93824;
        9'd439:value=32'h8ca2376f;
        9'd440:value=32'h8c4b36ba;
        9'd441:value=32'h8bf63604;
        9'd442:value=32'h8ba1354d;
        9'd443:value=32'h8b4e3496;
        9'd444:value=32'h8afc33df;
        9'd445:value=32'h8aab3326;
        9'd446:value=32'h8a5b326e;
        9'd447:value=32'h8a0d31b5;
        9'd448:value=32'h89bf30fb;
        9'd449:value=32'h89733041;
        9'd450:value=32'h89282f87;
        9'd451:value=32'h88de2ecc;
        9'd452:value=32'h88952e11;
        9'd453:value=32'h884d2d55;
        9'd454:value=32'h88062c99;
        9'd455:value=32'h87c12bdc;
        9'd456:value=32'h877c2b1f;
        9'd457:value=32'h87392a61;
        9'd458:value=32'h86f729a3;
        9'd459:value=32'h86b628e5;
        9'd460:value=32'h86772826;
        9'd461:value=32'h86382767;
        9'd462:value=32'h85fb26a8;
        9'd463:value=32'h85bf25e8;
        9'd464:value=32'h85842528;
        9'd465:value=32'h854a2467;
        9'd466:value=32'h851223a6;
        9'd467:value=32'h84da22e5;
        9'd468:value=32'h84a42223;
        9'd469:value=32'h846f2161;
        9'd470:value=32'h843b209f;
        9'd471:value=32'h84081fdd;
        9'd472:value=32'h83d71f1a;
        9'd473:value=32'h83a71e57;
        9'd474:value=32'h83781d93;
        9'd475:value=32'h834a1ccf;
        9'd476:value=32'h831d1c0b;
        9'd477:value=32'h82f21b47;
        9'd478:value=32'h82c71a82;
        9'd479:value=32'h829e19be;
        9'd480:value=32'h827718f9;
        9'd481:value=32'h82501833;
        9'd482:value=32'h822b176e;
        9'd483:value=32'h820616a8;
        9'd484:value=32'h81e315e2;
        9'd485:value=32'h81c2151c;
        9'd486:value=32'h81a11455;
        9'd487:value=32'h8182138f;
        9'd488:value=32'h816412c8;
        9'd489:value=32'h81471201;
        9'd490:value=32'h812b113a;
        9'd491:value=32'h81111072;
        9'd492:value=32'h80f70fab;
        9'd493:value=32'h80df0ee3;
        9'd494:value=32'h80c90e1c;
        9'd495:value=32'h80b30d54;
        9'd496:value=32'h809f0c8c;
        9'd497:value=32'h808c0bc4;
        9'd498:value=32'h807a0afb;
        9'd499:value=32'h80690a33;
        9'd500:value=32'h805a096a;
        9'd501:value=32'h804c08a2;
        9'd502:value=32'h803f07d9;
        9'd503:value=32'h80330711;
        9'd504:value=32'h80280648;
        9'd505:value=32'h801f057f;
        9'd506:value=32'h801704b6;
        9'd507:value=32'h801003ed;
        9'd508:value=32'h800b0324;
        9'd509:value=32'h8007025b;
        9'd510:value=32'h80030192;
        9'd511:value=32'h800200c9;
        default:value=32'h7fff0000;
    endcase
endmodule
