Keyi-1/xinxian-fpga-guitar/rtl/display/guitar_lissajous_arcsine.v

// Principal asin((y-136)/94), phase cycles Q16, centered square canvas.
module guitar_lissajous_arcsine(input wire clk,input wire [7:0] y,
    output reg signed [17:0] theta);
    reg [17:0] table_rom [0:255];
    initial begin
        table_rom[0]=18'h3c000;
        table_rom[1]=18'h3c000;
        table_rom[2]=18'h3c000;
        table_rom[3]=18'h3c000;
        table_rom[4]=18'h3c000;
        table_rom[5]=18'h3c000;
        table_rom[6]=18'h3c000;
        table_rom[7]=18'h3c000;
        table_rom[8]=18'h3c000;
        table_rom[9]=18'h3c000;
        table_rom[10]=18'h3c000;
        table_rom[11]=18'h3c000;
        table_rom[12]=18'h3c000;
        table_rom[13]=18'h3c000;
        table_rom[14]=18'h3c000;
        table_rom[15]=18'h3c000;
        table_rom[16]=18'h3c000;
        table_rom[17]=18'h3c000;
        table_rom[18]=18'h3c000;
        table_rom[19]=18'h3c000;
        table_rom[20]=18'h3c000;
        table_rom[21]=18'h3c000;
        table_rom[22]=18'h3c000;
        table_rom[23]=18'h3c000;
        table_rom[24]=18'h3c000;
        table_rom[25]=18'h3c000;
        table_rom[26]=18'h3c000;
        table_rom[27]=18'h3c000;
        table_rom[28]=18'h3c000;
        table_rom[29]=18'h3c000;
        table_rom[30]=18'h3c000;
        table_rom[31]=18'h3c000;
        table_rom[32]=18'h3c000;
        table_rom[33]=18'h3c000;
        table_rom[34]=18'h3c000;
        table_rom[35]=18'h3c000;
        table_rom[36]=18'h3c000;
        table_rom[37]=18'h3c000;
        table_rom[38]=18'h3c000;
        table_rom[39]=18'h3c000;
        table_rom[40]=18'h3c000;
        table_rom[41]=18'h3c000;
        table_rom[42]=18'h3c000;
        table_rom[43]=18'h3c5f3;
        table_rom[44]=18'h3c86b;
        table_rom[45]=18'h3ca52;
        table_rom[46]=18'h3cbee;
        table_rom[47]=18'h3cd59;
        table_rom[48]=18'h3cea3;
        table_rom[49]=18'h3cfd3;
        table_rom[50]=18'h3d0ee;
        table_rom[51]=18'h3d1fa;
        table_rom[52]=18'h3d2f7;
        table_rom[53]=18'h3d3e9;
        table_rom[54]=18'h3d4d0;
        table_rom[55]=18'h3d5af;
        table_rom[56]=18'h3d686;
        table_rom[57]=18'h3d756;
        table_rom[58]=18'h3d820;
        table_rom[59]=18'h3d8e4;
        table_rom[60]=18'h3d9a3;
        table_rom[61]=18'h3da5d;
        table_rom[62]=18'h3db13;
        table_rom[63]=18'h3dbc5;
        table_rom[64]=18'h3dc73;
        table_rom[65]=18'h3dd1e;
        table_rom[66]=18'h3ddc6;
        table_rom[67]=18'h3de6b;
        table_rom[68]=18'h3df0d;
        table_rom[69]=18'h3dfac;
        table_rom[70]=18'h3e049;
        table_rom[71]=18'h3e0e4;
        table_rom[72]=18'h3e17c;
        table_rom[73]=18'h3e213;
        table_rom[74]=18'h3e2a7;
        table_rom[75]=18'h3e33a;
        table_rom[76]=18'h3e3cb;
        table_rom[77]=18'h3e45b;
        table_rom[78]=18'h3e4e8;
        table_rom[79]=18'h3e575;
        table_rom[80]=18'h3e5ff;
        table_rom[81]=18'h3e689;
        table_rom[82]=18'h3e711;
        table_rom[83]=18'h3e798;
        table_rom[84]=18'h3e81e;
        table_rom[85]=18'h3e8a2;
        table_rom[86]=18'h3e926;
        table_rom[87]=18'h3e9a9;
        table_rom[88]=18'h3ea2a;
        table_rom[89]=18'h3eaab;
        table_rom[90]=18'h3eb2a;
        table_rom[91]=18'h3eba9;
        table_rom[92]=18'h3ec27;
        table_rom[93]=18'h3eca4;
        table_rom[94]=18'h3ed21;
        table_rom[95]=18'h3ed9c;
        table_rom[96]=18'h3ee17;
        table_rom[97]=18'h3ee92;
        table_rom[98]=18'h3ef0b;
        table_rom[99]=18'h3ef84;
        table_rom[100]=18'h3effd;
        table_rom[101]=18'h3f075;
        table_rom[102]=18'h3f0ec;
        table_rom[103]=18'h3f163;
        table_rom[104]=18'h3f1d9;
        table_rom[105]=18'h3f24f;
        table_rom[106]=18'h3f2c4;
        table_rom[107]=18'h3f339;
        table_rom[108]=18'h3f3ad;
        table_rom[109]=18'h3f421;
        table_rom[110]=18'h3f495;
        table_rom[111]=18'h3f508;
        table_rom[112]=18'h3f57b;
        table_rom[113]=18'h3f5ee;
        table_rom[114]=18'h3f660;
        table_rom[115]=18'h3f6d2;
        table_rom[116]=18'h3f744;
        table_rom[117]=18'h3f7b5;
        table_rom[118]=18'h3f826;
        table_rom[119]=18'h3f897;
        table_rom[120]=18'h3f908;
        table_rom[121]=18'h3f978;
        table_rom[122]=18'h3f9e9;
        table_rom[123]=18'h3fa59;
        table_rom[124]=18'h3fac9;
        table_rom[125]=18'h3fb39;
        table_rom[126]=18'h3fba8;
        table_rom[127]=18'h3fc18;
        table_rom[128]=18'h3fc87;
        table_rom[129]=18'h3fcf7;
        table_rom[130]=18'h3fd66;
        table_rom[131]=18'h3fdd5;
        table_rom[132]=18'h3fe44;
        table_rom[133]=18'h3feb3;
        table_rom[134]=18'h3ff22;
        table_rom[135]=18'h3ff91;
        table_rom[136]=18'h00000;
        table_rom[137]=18'h0006f;
        table_rom[138]=18'h000de;
        table_rom[139]=18'h0014d;
        table_rom[140]=18'h001bc;
        table_rom[141]=18'h0022b;
        table_rom[142]=18'h0029a;
        table_rom[143]=18'h00309;
        table_rom[144]=18'h00379;
        table_rom[145]=18'h003e8;
        table_rom[146]=18'h00458;
        table_rom[147]=18'h004c7;
        table_rom[148]=18'h00537;
        table_rom[149]=18'h005a7;
        table_rom[150]=18'h00617;
        table_rom[151]=18'h00688;
        table_rom[152]=18'h006f8;
        table_rom[153]=18'h00769;
        table_rom[154]=18'h007da;
        table_rom[155]=18'h0084b;
        table_rom[156]=18'h008bc;
        table_rom[157]=18'h0092e;
        table_rom[158]=18'h009a0;
        table_rom[159]=18'h00a12;
        table_rom[160]=18'h00a85;
        table_rom[161]=18'h00af8;
        table_rom[162]=18'h00b6b;
        table_rom[163]=18'h00bdf;
        table_rom[164]=18'h00c53;
        table_rom[165]=18'h00cc7;
        table_rom[166]=18'h00d3c;
        table_rom[167]=18'h00db1;
        table_rom[168]=18'h00e27;
        table_rom[169]=18'h00e9d;
        table_rom[170]=18'h00f14;
        table_rom[171]=18'h00f8b;
        table_rom[172]=18'h01003;
        table_rom[173]=18'h0107c;
        table_rom[174]=18'h010f5;
        table_rom[175]=18'h0116e;
        table_rom[176]=18'h011e9;
        table_rom[177]=18'h01264;
        table_rom[178]=18'h012df;
        table_rom[179]=18'h0135c;
        table_rom[180]=18'h013d9;
        table_rom[181]=18'h01457;
        table_rom[182]=18'h014d6;
        table_rom[183]=18'h01555;
        table_rom[184]=18'h015d6;
        table_rom[185]=18'h01657;
        table_rom[186]=18'h016da;
        table_rom[187]=18'h0175e;
        table_rom[188]=18'h017e2;
        table_rom[189]=18'h01868;
        table_rom[190]=18'h018ef;
        table_rom[191]=18'h01977;
        table_rom[192]=18'h01a01;
        table_rom[193]=18'h01a8b;
        table_rom[194]=18'h01b18;
        table_rom[195]=18'h01ba5;
        table_rom[196]=18'h01c35;
        table_rom[197]=18'h01cc6;
        table_rom[198]=18'h01d59;
        table_rom[199]=18'h01ded;
        table_rom[200]=18'h01e84;
        table_rom[201]=18'h01f1c;
        table_rom[202]=18'h01fb7;
        table_rom[203]=18'h02054;
        table_rom[204]=18'h020f3;
        table_rom[205]=18'h02195;
        table_rom[206]=18'h0223a;
        table_rom[207]=18'h022e2;
        table_rom[208]=18'h0238d;
        table_rom[209]=18'h0243b;
        table_rom[210]=18'h024ed;
        table_rom[211]=18'h025a3;
        table_rom[212]=18'h0265d;
        table_rom[213]=18'h0271c;
        table_rom[214]=18'h027e0;
        table_rom[215]=18'h028aa;
        table_rom[216]=18'h0297a;
        table_rom[217]=18'h02a51;
        table_rom[218]=18'h02b30;
        table_rom[219]=18'h02c17;
        table_rom[220]=18'h02d09;
        table_rom[221]=18'h02e06;
        table_rom[222]=18'h02f12;
        table_rom[223]=18'h0302d;
        table_rom[224]=18'h0315d;
        table_rom[225]=18'h032a7;
        table_rom[226]=18'h03412;
        table_rom[227]=18'h035ae;
        table_rom[228]=18'h03795;
        table_rom[229]=18'h03a0d;
        table_rom[230]=18'h04000;
        table_rom[231]=18'h04000;
        table_rom[232]=18'h04000;
        table_rom[233]=18'h04000;
        table_rom[234]=18'h04000;
        table_rom[235]=18'h04000;
        table_rom[236]=18'h04000;
        table_rom[237]=18'h04000;
        table_rom[238]=18'h04000;
        table_rom[239]=18'h04000;
        table_rom[240]=18'h04000;
        table_rom[241]=18'h04000;
        table_rom[242]=18'h04000;
        table_rom[243]=18'h04000;
        table_rom[244]=18'h04000;
        table_rom[245]=18'h04000;
        table_rom[246]=18'h04000;
        table_rom[247]=18'h04000;
        table_rom[248]=18'h04000;
        table_rom[249]=18'h04000;
        table_rom[250]=18'h04000;
        table_rom[251]=18'h04000;
        table_rom[252]=18'h04000;
        table_rom[253]=18'h04000;
        table_rom[254]=18'h04000;
        table_rom[255]=18'h04000;
    end
    always @(posedge clk) theta<=table_rom[y];
endmodule
