Keyi-1/xinxian-fpga-guitar/rtl/display/guitar_lissajous_sine.v

// Single-port shared sine ROM, signed +/-511, quarter-wave symmetry.
module guitar_lissajous_sine(input wire clk,input wire [9:0] angle,
    output wire signed [9:0] sine);
    reg [8:0] quarter [0:255];
    reg [8:0] q;
    reg negative;
    initial begin
        quarter[0]=9'd0;
        quarter[1]=9'd3;
        quarter[2]=9'd6;
        quarter[3]=9'd9;
        quarter[4]=9'd13;
        quarter[5]=9'd16;
        quarter[6]=9'd19;
        quarter[7]=9'd22;
        quarter[8]=9'd25;
        quarter[9]=9'd28;
        quarter[10]=9'd31;
        quarter[11]=9'd34;
        quarter[12]=9'd38;
        quarter[13]=9'd41;
        quarter[14]=9'd44;
        quarter[15]=9'd47;
        quarter[16]=9'd50;
        quarter[17]=9'd53;
        quarter[18]=9'd56;
        quarter[19]=9'd59;
        quarter[20]=9'd63;
        quarter[21]=9'd66;
        quarter[22]=9'd69;
        quarter[23]=9'd72;
        quarter[24]=9'd75;
        quarter[25]=9'd78;
        quarter[26]=9'd81;
        quarter[27]=9'd84;
        quarter[28]=9'd87;
        quarter[29]=9'd90;
        quarter[30]=9'd94;
        quarter[31]=9'd97;
        quarter[32]=9'd100;
        quarter[33]=9'd103;
        quarter[34]=9'd106;
        quarter[35]=9'd109;
        quarter[36]=9'd112;
        quarter[37]=9'd115;
        quarter[38]=9'd118;
        quarter[39]=9'd121;
        quarter[40]=9'd124;
        quarter[41]=9'd127;
        quarter[42]=9'd130;
        quarter[43]=9'd133;
        quarter[44]=9'd136;
        quarter[45]=9'd139;
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
        quarter[253]=9'd511;
        quarter[254]=9'd511;
        quarter[255]=9'd511;
    end
    always @(posedge clk) begin
        q<=quarter[angle[8] ? ~angle[7:0] : angle[7:0]];
        negative<=angle[9];
    end
    assign sine=negative ? -$signed({1'b0,q}) : $signed({1'b0,q});
endmodule
