Keyi-1/xinxian-fpga-guitar/rtl/display/guitar_radial_arcsine.v

// asin((y-135.5)/74.5), principal phase Q16. Explicit logic table.
module guitar_radial_arcsine(input wire clk,input wire [7:0] y,
    output reg signed [17:0] theta) /* synthesis syn_romstyle="logic" */;
    reg signed [17:0] value;
    always @* case(y)
        8'd0:value=18'h3c000;
        8'd1:value=18'h3c000;
        8'd2:value=18'h3c000;
        8'd3:value=18'h3c000;
        8'd4:value=18'h3c000;
        8'd5:value=18'h3c000;
        8'd6:value=18'h3c000;
        8'd7:value=18'h3c000;
        8'd8:value=18'h3c000;
        8'd9:value=18'h3c000;
        8'd10:value=18'h3c000;
        8'd11:value=18'h3c000;
        8'd12:value=18'h3c000;
        8'd13:value=18'h3c000;
        8'd14:value=18'h3c000;
        8'd15:value=18'h3c000;
        8'd16:value=18'h3c000;
        8'd17:value=18'h3c000;
        8'd18:value=18'h3c000;
        8'd19:value=18'h3c000;
        8'd20:value=18'h3c000;
        8'd21:value=18'h3c000;
        8'd22:value=18'h3c000;
        8'd23:value=18'h3c000;
        8'd24:value=18'h3c000;
        8'd25:value=18'h3c000;
        8'd26:value=18'h3c000;
        8'd27:value=18'h3c000;
        8'd28:value=18'h3c000;
        8'd29:value=18'h3c000;
        8'd30:value=18'h3c000;
        8'd31:value=18'h3c000;
        8'd32:value=18'h3c000;
        8'd33:value=18'h3c000;
        8'd34:value=18'h3c000;
        8'd35:value=18'h3c000;
        8'd36:value=18'h3c000;
        8'd37:value=18'h3c000;
        8'd38:value=18'h3c000;
        8'd39:value=18'h3c000;
        8'd40:value=18'h3c000;
        8'd41:value=18'h3c000;
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
