Keyi-1/xinxian-fpga-guitar/(commit log)

2026-09-06 还未进行生成 4×9 音高相位增量 ROM
2026-09-06 feat: 生成正弦查找表
2026-09-09 生成数字声音
2026-09-09 E4频率仿真验证
2026-09-10 feat: 48 kHz 音频采样节拍
    [ProPrj_guitar_2026-09-09.epro]
2026-09-10 验证采样能否得到正确数字音频
2026-09-11 feat: 增加了PT8211串行输出
2026-09-11 feat: 增加了FPGA24位到16位的转换（DAC为16位）
2026-09-11 feat: 连接完整minimal音频链
2026-09-12 feat: add fixed E4 minimal dual clock top
    [minimal_top.v, note_phase_rom.v, tb_minimal_top.sv]
2026-09-12 test: add fixed point E4 test vectors
    [voice_e4_golden.csv]
2026-09-12 feat: add 48 kHz audio sample tick
2026-09-12 fix: wait for successive golden sample pulses
2026-09-12 test: 比较RTL 16bit 采样与测试音
2026-09-12 tune: 调整可试听的包络时间
    [voice_e4_golden.csv]
2026-09-12 test: 增加一个一秒的E4音测试
2026-09-12 fix: restore full-scale PCM and complete release test
    [tb_long_voice_pcm16_export.sv, voice_audio_core.v]
2026-09-13 feat: 添加滑音平滑器
2026-09-13 feat: 增加四弦控制层和平滑器
2026-09-13 test: verify four-string audio chain integration
2026-09-17 test: cover four-voice sample-tick event boundaries
2026-09-17 feat: add four-string PT8211 audio chain
2026-09-17 feat: add MCP3208 pluck velocity frontend
2026-09-17 feat: apply pluck velocity to voice envelopes
2026-09-17 test: verify slide preserves velocity envelopes
2026-09-19 feat: add smooth classic rock harmonic timbre switch
2026-09-19 feat: add velocity-controlled rock soft clipping
2026-09-19 feat: add velocity-sensitive harmonic profiles
2026-09-19 build: add reproducible FULL Gowin implementation flow
2026-09-19 feat: add verified NEO board integration boundary
2026-09-19 fix: synchronize reset release across FULL clock domains
    [guitar_audio_top.v, neo_full_guitar_top.v, reset_sync.v, spectrum_display_top.v]
2026-09-19 添加附加功能描述：FM/PM Lite可选音色模式 类节奏大师演奏模式，该附加功能尚未实现
2026-09-21 feat: add same-fret tap vibrato
    [four_string_audio_chain.v, four_string_harmonic_audio_chain.v, four_string_voice_control.v, fret_note_event.v, phase_vibrato_modulator.v, tb_four_string_audio_chain.sv, tb_four_string_audio_output_chain.sv, tb_four_string_vibrato_gesture.sv]
2026-09-27 feat: 更新现有进度，增加最小验证发声E4模块并成功发声；尚未修改复位重发声问题
2026-09-27 fix: 完善按住KEY0音消失，松开KEY0音恢复逻辑
2026-09-28 feat：通过A板row0选音测试，达成选音、选高品位音；更新现有进度
2026-09-28 test: update A-board row0 audio selection source
2026-10-01 feat: 进行A板多音共发行为测试；进行拨弦拍频行为优化；进行爆破音行为优化
2026-10-03 feat: 添加MCP3208所在板的验证测试文件，并已成功通过上板验证
2026-10-04 feat: 完成全链路合成，并进行下板验证，尚未进行音色修改以及合音修改
    [voice_e4_golden.csv]
2026-10-04 fix: 修复音频效果，完善钢琴音效以及和音音效
2026-10-05 fix: 添加延音、合唱、音色切换等功能；修复空弦无延音、混响等问题
2026-10-05 feat: 添加摇滚音效（虽然不是很摇滚）
2026-10-05 fix: 修正README描述
2026-10-12 add: 添加屏幕显示功能，但尚有冲突
2026-10-12 feat: 更新屏幕显示效果，无冲突
2026-10-12 add: 完善松品续音逻辑
2026-10-13 feat: 修复李萨如图形直接消失问题
2026-10-13 Replace recorded piano hammer with shared procedural resonators
    [check_result.py, four_string_board_audio_chain.v, four_voice_piano_audio_core.v, piano_hammer_model.v, piano_voice_core.v]
2026-10-13 Fix IDE routing settings and isolate dry piano triad preview
    [check_result.py]
2026-10-13 docs: promote accepted dual-output firmware as current project
2026-10-13 feat: prototype GT911 touch modes and Jasmine rhythm game
    [jasmine.csv]
2026-10-14 fix: support native J6 touch with compact game state
    [check_result.py, game_chart_layout.v, game_note_controller.v, neo_guitar_touch_game_top.v]
2026-10-14 fix: restore synthesized game guidance and correct Jasmine rhythm
    [jasmine.csv]
2026-10-15 feat: implement full-width game stage and offline string allocation
    [jasmine.csv]
2026-10-15 perf: reuse frame snapshot and share game score formatter
2026-10-15 docs: archive verified full-width stage build and handoff
2026-10-15 feat: prototype bounded P2 static song engine and slow practice scores
    [jasmine.csv, qing_ge_intro.csv, seven_nation_riff.csv, slow_arpeggio.csv, time_10min.csv]
2026-10-16 add: 尝试添加长时间选曲
2026-10-16 feat: integrate supplied Qing Ge melody with game-only D3-G5 range
    [qing_ge_melody.csv]
2026-10-16 fix: show Qing Ge title as two centered Chinese characters
    [touch_game_renderer.v]
2026-10-18 feat: add writable song bank and DEBUG-USB2 UART import with verified C2 RTL
2026-10-18 perf: share BSRAM for exact piano modal state without added sample clocks
2026-10-18 release: certify writable library and DEBUG-USB2 UART import
2026-10-18 feat: add calibrated idle posture timbre control and confirmed Qing Ge rhythm
    [qing_ge_melody.csv]
2026-10-18 fix: center posture toolbar labels and bind full production gate checks
    [tb_game_audio_preservation.sv, tb_game_chart_renderer.sv, tb_game_extended_audio.sv, tb_game_p2_connection.sv, tb_game_p2_display.sv, tb_game_p3_audio_preservation.sv, tb_game_p3_display_equivalence.sv, tb_game_p3_full_gate.sv]
2026-10-18 feat: apply teammate per-string peak velocity calibration to P4 audio input
2026-10-18 test: validate physical ADC dynamics and continue original-project implementation
2026-10-19 release: certify P4 measured velocity calibration and publish verified bitstream
2026-10-19 fix: raise first-string trigger and soften the lowest velocity level
    [piano_voice_core.v, tb_dynamics_voice_preservation.sv, tb_first_string_crosstalk.sv, tb_mcp3208_pluck_frontend.sv, tb_mcp3208_velocity_exhaustive.sv, tb_velocity_calibrated_detector.sv]
2026-10-19 feat: lower third-string trigger and use quarter-step velocity gains
2026-10-19 feat(p5): explore onboard BL616 import with native phone prototype
2026-10-19 feat(pc): add guided Windows UART score uploader
    [入门示例.csv]
2026-10-21 chore: preserve local score tools and audio verification sources
    [happy_birthday_60bpm.csv]
2026-10-23 fix(imu): support ID70 sensors and document verified Flash boot
    [mpu6050_reader.v, mpu6050_reader_before_id70.v, mpu_diag_i2c_master.v, mpu_lcd_diag_reader.v, neo_mpu6050_lcd_diagnostic_top.v, tb_mpu_id70_compat.sv]
2026-10-25 feat(audio): add verified vibrato and shorter piano envelopes
    Add independent four-string performance vibrato, exact slide division and display timing fixes. Halve natural piano duration and retain fretted pitch on release. Preserve accepted ID70 and V6 releases; include targeted RTL/gate checks and original-project STA certificates.
    [four_string_board_audio_chain.v, four_string_board_audio_chain_before.v, four_string_board_audio_chain_before_v6.v, four_string_board_audio_chain_oracle.v, four_string_board_audio_chain_oracle_v6.v, four_string_vibrato_serial.v, guitar_play_control.v, guitar_touch_game_audio.v]
2026-10-26 蓝牙失败，更新滑音设置
2026-10-30 feat(bluetooth): add JDY-23 score upload and verified release
    Route the score UART to J8-9/10 at 9600/8N1 and add the Android FFE0/FFE1
    transport with paced fragments, connection isolation and pending-commit guards.
    Include the completed October 27 FPGA/APK package, original verification
    certificate, checksums, setup instructions and focused validation tools.
    Existing source and artifact hashes were checked without repeating completed
    builds or tests. Physical Bluetooth validation remains pending.
2026-10-31 fix(lcd): rotate complete display by 180 degrees
    Reverse the logical pixel coordinates and scanline rendering order so D is
    at the top and A at the bottom. Enable rotation only in the main touch-game
    display; preserve LCD timing, audio, touch input and project constraints.
    Gowin V1.9.12.03 synthesis and full P&R/STA passed on GW5AT-60 Device B:
    system/audio Fmax 50.078/18.291 MHz, setup/hold/unrouted/latch counts zero.
    Include two focused LCD simulations, build receipts and the verified FS
    release package. Hardware panel validation remains pending.
    [guitar_radial_curve_renderer.v, guitar_touch_game_display.v, tb_lcd_rotation.sv, tb_lcd_rotation_curves.sv]
2026-11-01 feat(audio): add 32-state KS synthesis and verified LCD180 release
    Replace the bright timbre with Karplus-Strong models using four voices,
    eight independent model states per voice, two parallel pipelines and TDM.
    Use a private 100 MHz PLL while preserving 48 kHz audio and the existing
    piano/wah paths. Add the approved 1.4983x fifth model and gain balance.
    Retain the remote full-display 180-degree rotation and its release history.
    Include source, project dependencies, tests, documentation, hash-bound
    validation records and three fixed KS release archives.
    Original-project synthesis, full P&R/STA and current-netlist vs RTL pass.
    System/audio/KS Fmax: 52.586/18.847/109.240 MHz; setup/hold/unr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
    [four_string_board_audio_chain.v, four_voice_piano_audio_core.v, guitar_radial_curve_renderer.v, guitar_touch_game_audio.v, guitar_touch_game_display.v, karplus_strong_voice.v, ks_compute_pll.v, ks_tdm_bank.v]
2026-11-02 feat(fpga): finalize dual score transport and rotated controls
    Restore Windows DEBUG-USB2 at 115200 alongside JDY-23 at 9600 using
    parallel UART frame receivers and one context-switched protocol kernel.
    Keep endpoint sessions, retries and errors private and serialize shared
    score writes with BEGIN ownership.
    Align touch with the 180-degree display, accept both neck directions in
    MPU posture classification, and place built-in songs in slots 1/2/3.
    Preserve the accepted four-voice/32-state KS sound with the independently
    proved equivalent pipeline changes.
    Bind the final source archive, bitstream package and original receipts.
    Original P&R: sys/audio/KS Fmax 52.375/18.044/109.368 MHz, zero s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
    [game_p2_mode_router.v, game_p3_catalog.v, game_p3_default_catalog.v, game_p3_dual_service.v, game_p3_protocol.v, game_p3_service.v, guitar_touch_game_display.v, imu_posture_classifier.v]
2026-11-02 feat(companion): publish Android 0.3.0 and Windows 1.2.0 sources
    Add the Android score library, native dark interface, adaptive app icons,
    optional note animation and system-bar/cutout insets. Keep BIN import and
    the existing JDY-23/XG3 transport.
    Synchronize Windows slot and timbre names, remove recommendation hints
    and include the same three score examples on both platforms. Preserve
    Windows DEBUG-USB2 at 115200 and the existing desktop preview feature.
    Record the completed API35 five-scenario/195-check validation and 34
    Windows regression cases, frozen EXE and delivered source hash bindings.
    Keep local signing keys and installers outside this source commit.
2026-11-03 chore: organize final sources and project documentation
    Keep the accepted 140 FPGA inputs and distributed FS/APK/Windows binaries byte-exact. Archive 982 historical files under verification and preserve protected user files.
    Rewrite the README around the finished instrument, board setup, dual score transport, source layout, and actual build/simulation platforms. Add existing UI/RTL images and portable build paths.
    Validation: clean staged checkout passes dependency/artifact checks and 42 client/protocol tests; ModelSim compiles 104 Verilog entries and elaborates the production top. No bitstream rebuild or hardware access.
    [ProPrj_guitar_2026-09-09.epro, jasmine.csv, qing_ge_intro.csv, slow_arpeggio.csv, time_10min.csv, voice_e4_golden.csv]
